Guadonna/VideoSynth/docs/r1/README.md

# VideoSynth R1 — схема, PCB и лаборатория эмуляции

23 октября 2026. Пользователь разрешил разработку схемы и PCB после исследовательской v0.5 и подтвердил готовый модуль ESP32-P4 и панель 42 HP. Старый запрет проектирования в документах v0.4/v0.5 относится к завершённому этапу. Разрешения на производство нет; заказы не создавались.

Созданы **две электрические схемы и две полностью соединённые четырёхслойные PCB KiCad 9**: основная плата и плата органов управления. В R1 используется Olimex ESP32-P4-DevKit Rev.D1. Это проверяемый инженерный прототип, ещё не выпуск для изготовления.

| Материал | Файл |
|---|---|
| Основная схема | [KiCad](../../hardware/kicad/core/videosynth_core.kicad_pro), [PDF](../../hardware/kicad/core/core-schematic.pdf) |
| Основная PCB 140×105 мм | [KiCad PCB](../../hardware/kicad/core/videosynth_core.kicad_pcb) |
| Панель управления 208,28×108 мм | [KiCad](../../hardware/kicad/panel/videosynth_panel.kicad_pro), [схема PDF](../../hardware/kicad/panel/panel-schematic.pdf), [PCB](../../hardware/kicad/panel/videosynth_panel.kicad_pcb) |
| Автономное приложение | [VideoSynth-R1.html](../../dist/VideoSynth-R1.html) — скачать и открыть в современном браузере |
| Пакет R1 с исходниками и PDF | [VideoSynth-R1-prototype.zip](../../dist/VideoSynth-R1-prototype.zip) |
| Электроника, питание и сборка | [hardware.md](hardware.md) |
| Правила синтеза и ограничения модели | [dsp.md](dsp.md) |
| Изменение AM и микса 0.6.2 | [modulation-fixes.md](modulation-fixes.md) |
| Проверки и доказательства | [validation.md](validation.md) |
| Порядок испытаний | [bringup.md](bringup.md) |
| Компоненты | [BOM](../../hardware/bom-r1.csv), [внешние узлы](../../hardware/external-assemblies.csv), [смета](../../hardware/cost-estimate-usd.csv) |
| Источники | [sources.md](sources.md) |

Краткий вывод: логика шести осцилляторов, экранной матрицы и одного микса реализована и проверяется в приложении. ERC, DRC и независимая сверка соединений проходят. Линейная модель входа CV проходит SPICE-проверку. **Работоспособность собранной электроники и 720×480/29,97 при 36 связях на ESP32-P4 пока не подтверждены.** В репозитории есть переносимое ядро C и браузерный стенд; драйверов платы и законченной ESP-IDF-прошивки ещё нет.

Перед изготовлением важнее всего проверить непрерывность PARLIO/DMA, максимальный DSP-сценарий, питание модуля без USB, номиналы и поведение CV при выключении. Также нужно утвердить точные модели ручек/дисплея и конструкцию крепления двух плат. Нулевой DRC этих вопросов не решает.
