Guadonna/VideoSynth/docs/summary-v0.5.md

# VideoSynth v0.5 — краткая выжимка

[Текущие требования](requirements/video_synth_TZ_v0.5.md) · [Исследование](feasibility-v0.5.md) · [PDF](feasibility-v0.5.pdf)

Согласовано: **один монохромный RCA, 720×480 / 480i / 29,97 кадра/с**, питание только Eurorack. Все шесть OSC могут одновременно входить в микс; кнопки переключают вкл/выкл. Выключенный из микса OSC продолжает работать в модуляционной матрице.

Матрица находится на экране: **8 источников × 18 назначений, до 36 включённых слотов**, каждый с фиксированной силой. Два энкодера выбирают строку/столбец; MODE переключает меню/preview; SLOT включает/выключает ячейку. Регулировка глубины и нажатия энкодеров не требуются. Два CV сохранены для **DC…100 Гц**. 24 потенциометра остаются.

Полностью исключены патч-гнёзда, сканер, защита 44 контактов, матричный микшер, слои A/B/C и два лишних видеоканала. У двух внешних CV и Eurorack-питания защита остаётся. Питание от USB удалено; сервисное USB-обновление из исходного ТЗ сохраняется при питании от стойки.

**Первый кандидат — один ESP32-P4NRW32X.** P4+RP2350A — резерв, если нужен отдельный генератор видеотайминга. Один RP2350 — дешёвый сравнительный стенд, без обещания максимальной производительности.

Прежние риски кабельных матриц исчезли, но максимальный DSP-режим ещё не доказан: 720×480@29,97 требует **10,358 млн точек/с**, до **62,146 млн вычислений OSC/с**. Фиксированная сила позволяет заменить многие умножения суммированием, однако 36 связей, cross-FM/PM и feedback всё равно требуют измерений. Второй MCU не ускоряет это ядро автоматически.

Предварительная стоимость: **65–150 USD электроника**, **85–210 USD с PCB и сборкой**, без панели/корпуса, доставки и налогов. База предполагает резистивный DAC, простую LED-индикацию и один MCP3204 для ручек/медленных CV. Это не котировка и не утверждённый производственный BOM. P4 нужной ревизии остаётся закупочным риском; новые ADC и RP2350A найдены в каталоге JLCPCB.

До схемы остаётся определить и проверить:

- Численные фиксированные силы FM/AM/PM, суммирование/ограничение и задержку в циклах. Отдельные экранные связи уже однозначны; проводной «семантики групп» больше нет.
- Закон итогового микса: для прототипа предложено равновесное среднее, при пустом выборе — чёрное изображение.
- Стабильность 480i под полной нагрузкой, реконструкционный фильтр, полезную видеополосу, setup и совместимость приёмников.
- Точность и защиту двух CV, потребление/нагрев, полный pin mux, конкретные органы управления и ширину HP.

Физические испытания не выполнялись. Исходный v0.4 сохранён как история; новая версия не является разрешением на схему, PCB или производство.
