Guadonna/VideoSynth/hardware/panel/opening-centres-provisional.csv

name | panel_x_mm | panel_y_mm | candidate_diameter_mm | note
H1 FREQ | 14.54 | 26.25 | 7.2 | pot candidate
H1 FINE | 14.54 | 46.25 | 7.2 | pot candidate
H1 PHASE | 14.54 | 66.25 | 7.2 | pot candidate
H1 MORPH | 14.54 | 86.25 | 7.2 | pot candidate
H2 FREQ | 36.54 | 26.25 | 7.2 | pot candidate
H2 FINE | 36.54 | 46.25 | 7.2 | pot candidate
H2 PHASE | 36.54 | 66.25 | 7.2 | pot candidate
H2 MORPH | 36.54 | 86.25 | 7.2 | pot candidate
H3 FREQ | 58.54 | 26.25 | 7.2 | pot candidate
H3 FINE | 58.54 | 46.25 | 7.2 | pot candidate
H3 PHASE | 58.54 | 66.25 | 7.2 | pot candidate
H3 MORPH | 58.54 | 86.25 | 7.2 | pot candidate
V1 FREQ | 80.53999999999999 | 26.25 | 7.2 | pot candidate
V1 FINE | 80.53999999999999 | 46.25 | 7.2 | pot candidate
V1 PHASE | 80.53999999999999 | 66.25 | 7.2 | pot candidate
V1 MORPH | 80.53999999999999 | 86.25 | 7.2 | pot candidate
V2 FREQ | 102.53999999999999 | 26.25 | 7.2 | pot candidate
V2 FINE | 102.53999999999999 | 46.25 | 7.2 | pot candidate
V2 PHASE | 102.53999999999999 | 66.25 | 7.2 | pot candidate
V2 MORPH | 102.53999999999999 | 86.25 | 7.2 | pot candidate
V3 FREQ | 124.53999999999999 | 26.25 | 7.2 | pot candidate
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
