Guadonna/VideoSynth/docs/r1/hardware.md

# Аппаратная архитектура R1

## Что разработано

Основная плата 140×105 мм и плата панели 208,28×108 мм имеют по четыре слоя: **F.Cu — сигналы/компоненты, In1.Cu — земля, In2.Cu — сигналы, B.Cu — сигналы/компоненты**. Минимальные дорожка/зазор 0,20/0,20 мм; переходные отверстия 0,60/0,30 мм; основные цепи +12 В и 5 В разведены шириной 0,70 мм. Ветви питания маломощных ИС — 0,20 мм. Толщина 1,6 мм и медь 35 мкм — предварительные параметры заказа, а не согласованный заводом stackup.

184 электрических компонента: 100 на core, 84 на panel; крепёжные отверстия отдельно. На панели SMD в основном снизу, шесть индикаторов сверху. Это **двусторонний SMD-монтаж панели**. Потенциометры, энкодеры, кнопки, CV-разъёмы, штыревые соединители и сам модуль требуют отдельной THT/ручной сборки.

Схемы содержат все используемые физические выводы; соединения между листами обозначены глобальными метками. Пользовательская библиотека символов поставляется в каждом KiCad-проекте. Геометрия корпусов взята из библиотек KiCad. PCB полностью разведены и проверены, но аналоговая компоновка и силовой контур ещё требуют инженерной проверки на физическом образце. Длинные ответвления питания и расположение развязки AD9708 не следует считать квалифицированными только на основании DRC.

## Вычислительный модуль и интерфейсы

Выбран **Olimex ESP32-P4-DevKit Rev.D1**, плата 72×30 мм, два разъёма 1×20 с шагом 2,54 мм и расстоянием между рядами 25,4 мм. Память по документации модуля: 32 МБ PSRAM, 16 МБ Flash. Частота и ограничения silicon revision должны проверяться на полученном экземпляре; старое исследование с конкретным ограничением частоты нельзя автоматически заменить рекламным значением 400 МГц.

| Функция | GPIO ESP32-P4 | Вывод модуля |
|---|---|---|
| SPI SCK / ADC CS / TFT CS | 4 / 5 / 6 | EXT1 5 / 6 / 7 |
| I²C SDA / SCL | 7 / 8 | EXT1 8 / 9 |
| Видео D0…D7 | 9…16 | EXT1 10…17 |
| Внешний clock 27 МГц | 17 | EXT1 18 |
| TFT DC / RESET | 18 / 19 | EXT1 19 / 20 |
| SPI MISO / MOSI | 54 / 53 | EXT2 3 / 4 |
| DAC SLEEP | 22 | EXT2 11 |
| UI IRQ2 / IRQ1 | 21 / 20 | EXT2 12 / 13 |
| 3,3 В для carrier/panel | выход модуля | EXT1 1 |

EXT2 pin 1 (+5 В) на carrier не подключён. Питание вводится через отдельный J2 и разъём **POE_PWR1 модуля: core J2.1 → POE_PWR1.4 (+5VP), core J2.2 → POE_PWR1.3 (GND)**. Контакты PoE PW+/PW− не используются.

**Обязательная модификация модуля: удалить FET2, разрывающий путь USB VBUS к питанию.** Без этого R1 не выполняет отказ от USB-питания. Штатный D1 в цепи +5VP сохраняется. Это операция сборки на готовом модуле, не операция JLCPCB на carrier. Сверить обозначение FET2 с фактической Rev.D1 до удаления; для другой ревизии нельзя переносить инструкцию вслепую. Сервисный USB должен работать для данных только при питании от стойки. Обратное питание и загрузку без VBUS необходимо проверить физически.

## Видеовыход

ASE-27.000MHZ-LC-T тактирует P4; SN74LVC1G04 формирует противоположный фронт для AD9708. На clock и восьми data установлены последовательные 33 Ом. Требуемое поведение: P4 меняет данные на одном фронте, ЦАП принимает их на другом. Номинальная половина периода — 18,52 нс. Полезный запас меньше: нужно вычесть GPIO delay, задержку инвертора, skew трасс и setup/hold ЦАП. Эмулятор этого не доказывает.

AD9708ARUZ работает с DVDD=3,3 В и AVDD≈5 В. `I_FS = 32 × 1,2 В / 1,91 кОм ≈ 20,105 мА`. Нагрузки IOUTA/IOUTB — 49,9 Ом. IOUTA поступает на THS7314 с усилением ×2 и встроенным ФНЧ 8,5 МГц, затем через последовательные 75 Ом и короткий 75-омный коаксиал — на панельный RCA. Дополнительной параллельной нагрузки 75 Ом на плате нет: оконечная нагрузка находится в приёмнике.

При кодах sync=0, black=73, white=255 расчётный нагруженный размах sync→white **0,9993 В**, sync→black **0,2861 В**, black→white **0,7132 В**. THS7314 добавляет смещение ≈285 мВ на выходе; после делителя 75/75 абсолютная синхровершина ≈142,5 мВ. Это не ошибка расчёта размаха, но совместимость DC-смещения/восстановления уровня с конкретным захватом необходимо измерить.

ЦАП получает 27 MSPS: строка 1716 отсчётов, активная часть 1440 отсчётов из 720 вычисленных пикселей с линейной интерполяцией ×2. В кадре 900900 байт, в двух буферах 1801800 байт. Два буфера яркости 720×480 занимают ещё 691200 байт. Памяти модуля достаточно по объёму; непрерывность DMA и реальная пропускная способность PSRAM не доказаны объёмом памяти. Физическая полоса композитного видео не гарантирует различимость всех 720 цифровых столбцов.

Возможность непрерывной выдачи через PARLIO с внешним clock, без зазоров между DMA-дескрипторами, — главный аппаратно-программный риск. В R1 нет дополнительного RP2350/FPGA, который мог бы автоматически принять эту функцию.

## CV и потенциометры

CV рассчитан для ±10 В, DC…100 Гц; ±15 В — испытательная перегрузка, **не подтверждённая характеристика**. Исчезновение физической матрицы устраняет её контакты, но не защиту двух внешних CV.

Каждый канал: 100 кОм → OPA2197 (питание 5 В), обратная связь 12 кОм || 47 нФ; смещение от делителя 12,4/10 кОм на 3,3 В; далее 4,7 кОм, 100 нФ, BAT54S к шинам, TMUX1511 с powered-off isolation и 100 кОм на землю у АЦП. Идеальная передаточная функция до последнего RC: `V = 1,65 − 0,12 × CV`. С нагрузкой 100 кОм: `V_ADC = (1,65 − 0,12 × CV) × 100/104,7`.

При −10/0/+10 В получаются приблизительно 2,7221/1,5759/0,4298 В. Код АЦП при нуле не равен середине шкалы; прошивка должна учитывать нагрузку и двухточечную калибровку. SPICE с идеальным ОУ даёт ослабление 0,846 дБ на 100 Гц относительно DC. Два полюса около 282 и 355 Гц дают лишь умеренное подавление за полосой; сильные аудио/CV вне 100 Гц не являются заявленным рабочим режимом.

TMUX1511 не разрешает произвольные ±15 В на своих выводах: его допустимый диапазон при отключённом питании ограничен документацией. Отрицательный выброс, ток в BAT54S/OPA2197, обратное питание 3,3 В, порядок включения и ESD требуют измерений. Bleeder 1 кОм — вспомогательный потребитель, а не доказательство защиты.

Два CD74HC4067 опрашивают 24 потенциометра; два оставшихся канала OPA2197 буферизуют их выходы. MCP3204 получает два mux-канала и два CV. Предложенный график: CV по 4 kSPS, каждая ручка 100 Гц с первым отбрасываемым отсчётом после переключения. Итого 12800 преобразований/с; при 24 SPI-тактах и 1 МГц занято 30,72% времени шины. Фактическое установление mux/буфера и расписание дисплея нужно проверить.

## Управление и дисплей

MCP23017 по адресам 0x20/0x21 обслуживают кнопки, LED, энкодеры и адрес mux. I²C pull-up 2,2 кОм, IRQ к P4, аппаратный RC reset. Кнопки требуют программного подавления дребезга; энкодеры — корректного квадратурного декодирования, несмотря на RC-фильтр.

TFT подключается восьмипроводным жгутом VCC/GND/DIN/CLK/CS/DC/RST/BL. Кандидат — Waveshare 2.4inch LCD Module, рабочая ориентация 320×240. Точная версия контроллера, размеры платы, ток подсветки и логический вход BL должны быть сверены с приобретённой модификацией. SN74LVC1G125 управляет **логическим BL**, а не током голого светодиода. Нельзя заменить модуль «голой» матрицей с тем же названием.

Core J5 и panel J1 соединяются 20-жильным кабелем pin-to-pin. Видеосигнал идёт отдельным коаксиалом. Предварительно целиться в длину UI-шлейфа ≤50 мм и подтвердить целостность SPI на выбранной скорости. Конструкция расстояния между платами и кронштейна ещё не утверждена.

## Питание и смета

Eurorack: pins 9/10 +12 В, 3…8 земля, 1/2 −12 В **не используются**. F1 750 мА hold, последовательный SS34, TVS SMBJ15A, TPS54302 на 5 В. Обратная связь 100 кОм/13,3 кОм, дроссель 6,8 мкГн, вход 22 мкФ/35 В и два выхода 22 мкФ/10 В. Необходимо проверить DC-bias керамики, Isat выбранного дросселя, устойчивость преобразователя и выбросы: номиналы ещё не являются испытанным импульсным источником.

Предварительный бюджет 0,4…0,9 А от 5 В при КПД 85% даёт **0,20…0,45 А от +12 В**; −12 В не потребляется. Это диапазон планирования, не измерение. Дерейтинг предохранителя и пусковой ток должны проверяться при рабочей температуре. Нужен контроль падения на штатном диоде модуля и доступного тока его 3,3 В для TFT/панели.

[Смета](../../hardware/cost-estimate-usd.csv): **$175…386 за электронику одного прототипа с двумя PCB и долей SMD-сборки**. Не включены доставка/налоги, металлическая панель, 24 колпачка ручек, ручной THT-монтаж и отладка. Это расчёт из явно заданных бюджетных допущений, не цена JLCPCB.

Сборка SMD на JLCPCB технологически правдоподобна: доступны обычные 0805, SOIC, TSSOP, SOT-23 и четырёхслойные платы. Но **все конкретные позиции не подтверждены как комплект для заказа**. Для AD9708ARUZ, OPA2197, TMUX1511, дросселя и точных номиналов нужна актуальная проверка каталога/закупки, ориентации и замены. Исторический снимок v0.5 нельзя считать подтверждением изменённого BOM R1. Готовый модуль, TFT и THT органы управления не входят автоматически в услугу SMD-монтажа.
