Guadonna/VideoSynth/docs/requirements/video_synth_TZ_v0.5.md

# Техническое задание v0.5 — один видеовыход и экранная матрица

Дата: 23.10.2026. Это консолидация изменений и ответов заказчика после исследования v0.4. Исходный файл [v0.4](video_synth_TZ_v0.4.md) сохранён как история. При противоречии применяются подтверждённые требования v0.5 ниже. Текущий этап — исследование и проверка реализуемости; схема, PCB и производство не разрешены.

## 1. Подтверждённая функциональность

- Ровно 6 цифровых пространственных осцилляторов: H1–H3 и V1–V3. Сохраняются 24 потенциометра: frequency, fine frequency, phase offset, waveform morph для каждого OSC.
- **Один** монохромный композитный видеовыход RCA, согласованный с 75-омной нагрузкой.
- Максимальная растровая сетка **720×480**, стандартный режим **480i / 30000÷1001 ≈29,97 полного кадра/с / 60000÷1001 ≈59,94 поля/с**, 525 строк всего. Это замена прежнего PAL 625/50. Цветовое кодирование не требуется.
- Шесть кнопок OSC работают как переключатели: короткое нажатие добавляет осциллятор в итоговый микс, следующее исключает его. Одновременно в изображении могут участвовать все шесть.
- Выключение OSC из микса **не выключает его как источник/приёмник модуляции**. Невидимые осцилляторы могут менять изображение через другие OSC.
- Матричного микшера 3×3, слоёв A/B/C, FIFO-назначения и трёх выходов больше нет.
- Физические патч-разъёмы и обе проводные матрицы полностью исключены. Сканирование кабелей и защита этих отсутствующих контактов больше не требуются.

## 2. Экранная матрица и органы управления

- Матрица модуляции — отдельное меню встроенного дисплея, а не физическая коммутация.
- 8 источников: H1–H3, V1–V3, CV1, CV2. 18 назначений: FM, AM, PM каждого из шести OSC. Всего 144 адресуемых слота.
- Одновременно включено **не более 36 слотов во всей матрице**, включая связи от CV. Это не 36 связей на осциллятор.
- Слот имеет только состояния **вкл/выкл с фиксированной силой**. Пользовательская регулировка глубины и жесты её редактирования на этом этапе не нужны.
- Два физических энкодера: один перемещает курсор по горизонтали, второй по вертикали.
- Рядом две отдельные кнопки: **MODE** переключает меню матрицы/предпросмотр; **SLOT** включает или выключает выбранный слот.
- Общий обязательный набор: 24 потенциометра, 2 энкодера, 8 кнопок (6 OSC + MODE + SLOT), дисплей, 2 CV TS и 1 RCA. Нажатия самих энкодеров не требуются.
- Переключение режима экрана не останавливает синтез, не меняет матрицу и не сбрасывает активные OSC.

## 3. CV и питание

- Сохраняются два внешних CV-входа для огибающих и LFO, полезная полоса **DC…100 Гц**.
- Прежний предварительный рабочий диапазон ±10 В сохранён для расчётов; диапазон, точность, перегрузка и испытательные условия входов ещё нужно зафиксировать до схемы.
- Удаление патч-матриц не отменяет входной тракт и защиту двух оставшихся CV-разъёмов от отрицательных/избыточных напряжений, ESD и обратного питания при выключении.
- Только **Eurorack**, питание от стандартной шины ±12 В/GND. Standalone и питание устройства от USB исключены.
- Защита от перевёрнутого кабеля Eurorack, ограничение аварийного тока и фильтрация питания сохраняются.
- Требование v0.4 об обновлении прошивки через USB не отменено запросом об отказе от USB-питания. Поэтому сохраняется **сервисный USB для данных при питании модуля от стойки**; USB VBUS не питает рабочие шины. Система выбора USB/Eurorack и USB current-advertisement controller не нужны.

## 4. Предложения реализации, ещё не отдельные согласованные требования

- Строки меню = 8 источников; столбцы = 18 назначений, сгруппированных по OSC. Это естественное отображение двух энкодеров.
- Включение 37-го слота отклоняется с сообщением «Лимит 36»; ранее включённые связи не меняются. Все 144 позиции остаются доступными для выбора.
- В preview кнопка SLOT ничего не меняет, чтобы не переключать невидимый слот. OSC-кнопки работают в обоих режимах.
- Для первого прототипа итоговый микс — равновесное среднее включённых OSC, затем ограничение яркости. При отсутствии выбранных OSC выводится чёрное изображение с непрерывной синхронизацией. Другой закон микса можно оценить на визуальном прототипе.
- Несколько связей на одно назначение суммируются с явно заданным ограничением. Один и тот же фиксированный коэффициент внутри данного назначения позволяет сначала суммировать источники и потом масштабировать результат.
- Конкретные фиксированные силы FM/AM/PM, единицы их измерения, saturation, диапазоны частот, morph/anti-alias и задержка циклической обратной связи требуют определения в DSP-прототипе. Фиксированная сила не означает автоматически коэффициент «1» для всех трёх разных типов модуляции.
- 720×480 рассматривается как целевая **вычисляемая** сетка максимального режима. Апскейл более низкого внутреннего разрешения не объявляется её подтверждением. Поддержка 36 связей при максимальном режиме должна быть проверена до выбора MCU.

## 5. Следующие контрольные точки

1. Проверить непрерывный 525/59,94 raster и одну нагруженную видеолинию.
2. Сравнить DSP на ESP32-P4 и RP2350: все шесть OSC, до 36 связей, включая межосевые и согласованные циклические сценарии, UI и CV одновременно.
3. Проверить CV DC…100 Гц, питание, нагрев и обновление прошивки от сервисного USB при питании Eurorack.
4. Выбрать архитектуру и полный BOM на основании результатов; затем отдельно согласовать переход к электрической схеме/PCB.
