Guadonna/VideoSynth/docs/r1/dsp.md

# DSP, матрица и эмулятор

## Подтверждённое поведение

Шесть пространственных OSC: H1–H3 зависят от X, V1–V3 — от Y. У каждого frequency/fine/phase/morph; кнопка переключает участие в итоговом изображении и **не выключает модуляцию**. Все шесть продолжают вычисляться. Матрица 8×18: шесть OSC и два CV → FM/AM/PM каждого OSC. До 36 связей суммарно, включая CV. 37-я связь отклоняется атомарно. Два энкодера перемещают курсор, MODE переключает экран, SLOT переключает выбранную связь. В режиме preview SLOT ничего не меняет.

Пользователь дополнительно выбрал **перемножение сигналов в миксе** и **AM со сменой полярности**. С версии эмулятора 0.6.2 оба действия работают с биполярными значениями −1…+1. Эти правила реализованы в интерфейсе и переносимом [ядре C](../../firmware/dsp/engine.c). Из него собирается WebAssembly для браузера; нативный C-тест использует тот же исходник. Интерфейс выполняет ровно 720×480, а не скрытый рендер низкого разрешения.

## Инженерные допущения R1

Пользователь подтвердил фиксированную силу и характер AM/микса. Числа FM/PM, объединение нескольких управляющих AM-сигналов и семантика циклов остаются **инженерными допущениями R1**:

- Frequency 0,25…64 пространственных периода на ширину/высоту; fine ±1 период; итоговая частота ограничена 0,01…64.
- Phase 0…1 оборот. Morph непрерывно проходит sine → triangle → saw → square.
- Источники OSC в матрице читаются из **предыдущего активного пикселя**. Все шесть новых значений вычисляются одновременно из старых. Самомодуляция и циклы допустимы; порядок обхода OSC не меняет причинность.
- В начале каждого поля история источников сбрасывается в ноль. H-фаза начинается заново на каждой строке. Для V хранится отдельная фаза на каждый столбец; поле шагает по чётным или нечётным строкам, поэтому V-инкремент равен двум строкам.
- FM: множитель частоты `clip(1 + 0,25×sum, 0, 2)`, сумма источников ограничена ±4. PM: `0,125×sum` оборота, сумма также ограничена ±4.
- AM: при наличии хотя бы одной связи множитель `clip(sum, −1, +1)` **без постоянного смещения**. Несколько входящих AM-источников складываются на одной управляющей шине и затем ограничиваются; они не образуют цепочку отдельных умножителей. Без AM-связей множитель равен +1. Результат OSC после AM ограничен ±1 и используется как источник матрицы на следующем активном пикселе.
- Микс — **произведение** включённых OSC после AM, пока сигналы ещё биполярны. Преобразование в яркость выполняется один раз, после перемножения. Нет включённых OSC → чёрные активные пиксели; синхронизация сохраняется.
- CV проходит номинальную модель входа, квантование 12 бит и sample-and-hold 4 kSPS с временной шкалой двух полей. Нормированный рабочий CV ±1 соответствует ±10 В. Для синусоидального LFO приближённо учтены два полюса фильтра; это не transient-SPICE защиты.

### Формулы AM и микса 0.6.2

Для формы `wᵢ ∈ [−1,+1]` после FM/PM и предыдущих выходов источников `sⱼ`:

```text
aᵢ = 1                         при отсутствии AM-связей
aᵢ = clip(Σ sⱼ, −1, +1)        при наличии AM-связей
xᵢ = clip(wᵢ × aᵢ, −1, +1)
p  = Π xᵢ                     только выбранные кнопками OSC
Y  = round(255 × (p + 1) / 2)  если выбран хотя бы один OSC
Y  = 0                        если ни один OSC не выбран
```

| Множитель AM / фактор микса | Результат |
|---|---|
| +1 | Сигнал сохраняется |
| −1 | Полярность меняется: светлое и тёмное меняются местами |
| 0 | Переменная составляющая исчезает; на экране средний серый |
| Два одинаковых сигнала `x` в миксе | `x²`; отрицательные участки становятся положительными |
| Два противоположных сигнала `x`, `−x` | `−x²` |

Это модель четырёхквадрантного умножителя. Перемножение яркостей 0…1 дало бы другой эффект без смены полярности. При умножении многих синусоид произведение часто близко к нулю, поэтому контраст может уменьшаться. Автоматического усиления, усреднения и добавления исходной несущей нет.

Сцена «AM · инверсия»: в миксе только H1; V1 модулирует его AM, оставаясь невидимым. SLOT выключает/включает связь для сравнения. Сцена «Перемножение»: H1 × V1 без связей матрицы. В «Переплетении» AM приходит от независимых H2/V2. В «36 связях» V3 подаётся на AM остальных OSC, а собственный AM у V3 отключён; все шесть прямоугольных OSC участвуют в миксе.

Циклическая модуляция может давать выраженные текстуры, зависимость от порядка строк и переход на границе поля. **Замкнутая группа только из AM, включая self-AM, при нулевой начальной истории может навсегда остаться на нуле**, то есть дать серое изображение. Это следует из `w × 0 = 0`. Независимый источник на AM-шине или отключение одной связи может разорвать такое состояние; случайный шум и скрытое смещение не добавляются. Другие начальные условия и задержки обратной связи требуют отдельного решения. Аналоговый шум и смещения реальных умножителей здесь не моделируются.

PolyBLEP уменьшает aliasing saw/square от основной частоты. Он **не обеспечивает** полную полосу при сильной PM/FM, кольцевой AM, перемножении OSC и пространственной обратной связи. Произведение создаёт суммарные/разностные частоты; для нескольких высокочастотных сигналов возможен выход за Найквист. Обработка предельных режимов — предмет следующих DSP-испытаний; размытие внешним видеотрактом не равно корректному цифровому anti-alias.

## Видеовременная шкала

[video.js](../../app/video.js) строит полный монохромный растр: 27 МГц; 1716 отсчётов/строку; 525 строк; 900900 отсчётов/кадр; два поля по 450450 отсчётов, то есть 262,5 строки. Частоты 30000/1001 и 60000/1001 Гц. На каждом поле предусмотрены 6 предуравнивающих, 6 широких синхроимпульсов и 6 постуравнивающих полупериодов. Номиналы округлены до целых отсчётов: HSync 127, equalizing 62, broad-sync 731.

Активная область поля начинается с глобальных полустрок 44 и 570, 240 строк на поле, горизонтальное смещение 244 отсчёта. Это выбранное окно 480 строк внутри 525-line timing. Цветового burst и chroma нет; режим установки чёрного — 0 IRE, без 7,5 IRE setup. Требуется проверить захват и centering на реальном приёмнике.

Кнопка экспорта во вкладке «Проверки» сохраняет ровно 900900 байт, uint8, полный кадр с синхроимпульсами. Это тестовые данные ЦАП, не видеоконтейнер и не готовый DMA-драйвер.

Превью на мониторе приложения показывает вычисленную яркость. Оно не моделирует полностью THS7314, коаксиал, телевизионный clamp, расфокусировку и деинтерлейс захвата. Режимы «Поле 1/2» позволяют увидеть чересстрочное разложение.

## Производительность и границы переносимости

При 720×480×29,97 нужно обработать **10,358 млн активных пикселей/с**, вычислить **62,146 млн OSC/с** и до **372,875 млн накоплений связей/с**. На одном ядре 400 МГц это всего **38,62 такта на весь активный пиксель**; даже два ядра без потерь дали бы 77,24. Реально часть бюджета забирают формирование растра, DMA, синхронизация, CV и UI. Для меньшей допустимой частоты запас ещё ниже.

Текущее C-ядро — скалярная эталонная модель на float с RGBA-выводом для браузера. **Оно не считается готовой производительной реализацией для P4.** 36 связей общего вида требуют профилирования, плотных структур маршрутов, SIMD/fixed-point или другого ускорения. Параллелить соседние пиксели произвольно нельзя из-за принятой обратной связи. Независимые поля можно рассмотреть отдельно, но нужно проверить работу с живым CV и задержку отображения.

[Измерение нативного ядра на хосте](../../hardware/verification/host-dsp-benchmark.json) показывает только производительность данного компьютера; его нельзя переносить на ESP32-P4. В интерфейсе отображаются фактические миллисекунды/кадр и fps браузера. При медленном компьютере приложение замедляет модельное время и сохраняет размер кадра; это не доказательство real-time.

Программно получены: управление, формирование изображения, обработка матрицы, модель CV и генерация последовательности отсчётов видео. **Ещё не реализованы:** ESP-IDF boot/application, PARLIO+GDMA, управление буферами PSRAM/cache, MCP3204/MCP23017/TFT-драйверы, аппаратный debounce, калибровка, watchdog и USB update на реальной плате. Следующий этап начинается с измерительного firmware-spike, а не с объявления платы работоспособной.

Если P4 не проходит максимальный режим, нельзя молча уменьшить разрешение или число связей. Следует пересмотреть архитектуру: отдельный видеогенератор снимает риск тайминга, но сам по себе не ускоряет DSP; для полного DSP могут потребоваться FPGA/более мощный вычислительный узел либо отдельно согласованное изменение семантики.

## Управление приложением

Ручки: вертикальное перетаскивание, колесо мыши, клавиатура после фокуса. Кнопки 1…6 — OSC, M — MODE, стрелки — курсор, пробел — SLOT. Энкодеры можно вращать колесом или кнопками +/−. Пресеты сохраняются в JSON; некорректный файл отклоняется без частичной замены состояния. Формат JSON версии 1 совместим, но старые настройки отображаются по новому закону AM/микса, поэтому изображение изменится; старый замкнутый AM-патч может стать серым. Есть экспорт PNG, пауза, генераторы внешнего CV и встроенные проверки.

Автономный HTML не обращается к CDN, серверу или облачным API. PDF-ссылки в нём ведут на GitHub; для чтения схем без сети нужно скачать пакет с PDF. На этом облачном хосте навигация Chromium по `file://` запрещена администратором, поэтому автономность проверена загрузкой HTML по HTTP с блокировкой всех последующих сетевых запросов: **0 внешних запросов**. Это ограничение тестовой среды, а не удалённая зависимость приложения.
