Guadonna/VideoSynth/docs/requirements/video_synth_TZ_v0.4.md

# Техническое задание v0.4 — цифровой видеосинтезатор с аппаратным патчингом

**Статус:** концепция и требования для предварительного анализа (НЕ утверждённый проект платы).  
**Цель:** самостоятельный цифровой видеосинтезатор, который также может монтироваться в Eurorack, с минимальной ручной сборкой.  
**Исполнитель проектирования:** Codex с KiCad и SDK выбранного микроконтроллера.  
**Производство:** PCBA с заводским монтажом всех SMD и по возможности THT; ручная пайка допускается для крупных потенциометров, джеков, RCA и разъёмов.

## 1. Режимы использования и питание

1. Standalone: питание от USB-C 5 В, без обязательного подключения к Eurorack.
2. Eurorack: питание от стандартной шины Eurorack (предварительно 10-pin ±12 В/GND; совместимость с 16-pin системами через кабель). Плата должна корректно преобразовывать напряжение в необходимое для цифровой и аналоговой частей.
3. Обязательная защита от переполюсовки и ошибок питания; безопасное переключение/объединение источников USB и Eurorack без обратной подачи питания в компьютер или шину Eurorack. Прямое соединение источников запрещено.
4. Электропотребление и нагрев — оценить до проектирования; проверить применимость типовых источников USB и возможностей питания Eurorack.
5. Механика: совместимость с Eurorack 3U по высоте, посадочным отверстиям и шагу ширины HP. Конкретная ширина — только после расчёта компоновки всех 24 ручек, 6 кнопок выбора осцилляторов и не менее 44 патч-контактов при рекомендованной реализации матрицы микширования из девяти изолированных пар (ещё больше при необходимости дополнительных точек патчинга), дисплея и разъёмов; удобство использования важнее компактности.

## 2. Процессор и ПО

1. Только программно-цифровая генерация паттернов. Основной вычислитель — микроконтроллер семейства ESP32 либо Raspberry Pi RP (например, ESP32-P4, ESP32-S3 или RP2350), окончательный выбор **только после сравнительного теста**.
2. Допускаются специализированные вспомогательные микросхемы (АЦП, мультиплексоры, видеокодеры/ЦАП, буферы, конвертеры питания), но не отдельный аналоговый осцилляторный тракт.
3. До PCB обязательно сделать доказательство реализуемости: оценить CPU, RAM, DMA, пропускную способность внешней памяти, нагрузку интерфейса и способ выдачи ТРЁХ независимых композитных потоков одновременно.
4. Прошивка должна быть обновляема через USB без внешнего программатора; предусмотреть загрузочный и диагностический режимы.
5. Инструменты: Git, KiCad, CI, unit tests алгоритмов, моделирование видеорендера на ПК.

## 3. Осцилляторы

**Утверждено заказчиком:** **ровно 6** цифровых осцилляторов: **3 горизонтальных (H1, H2, H3) и 3 вертикальных (V1, V2, V3)**. Исходное «4 H + 4 V» было опечаткой.

- Всего 6 пространственных осцилляторов с фиксированным разделением: H1–H3 формируют горизонтальные паттерны, V1–V3 — вертикальные. Каждый осциллятор может модулировать любой другой, включая осцилляторы другой ориентации.
- Для каждого: 4 физических потенциометра (всего 24): frequency, fine frequency, phase offset, waveform morph.
- Набор форм волн и правила плавного морфинга — спроектировать и согласовать. Предварительные варианты: sine, triangle, saw, square; нужны бесшовный морфинг и предсказуемый диапазон частот.
- Определить поведение осцилляторов по пикселю/строке/кадру, диапазоны частот и способы антиалиасинга; проверить корректность фазового накопителя на переходах строк и кадров.
- Каждый осциллятор может быть источником модуляции для других осцилляторов.

## 4. Матрица модуляции — физический одноконтактный патчинг

Источники: OSC1–OSC6, CV1, CV2 (итого 8).  
Назначения: индивидуальные входы FM, AM, PM на каждом из 6 осцилляторов (6 × 3 = 18).

- Минимум **26 фронтальных патч-контактов** (8 исходных + 18 целевых), если каждому источнику/назначению соответствует один контакт.
- Патч-кабели одно-контактные, в эстетике AE Modular. Все сигналы внутри устройства имеют общую опорную землю; патч-шина не должна без защиты соединяться с внешними CV-системами.
- Предпочтительный принцип: кабели только передают информацию о соединениях; DSP выполняет математическую модуляцию внутри микроконтроллера. Это не требует передачи полночастотного аналогового видео по патч-кабелям. Схему определения подключений необходимо разработать, проверить электрическую безопасность и документировать.
- Предположительно требуются одно-ко-многим и много-к-одному соединения. Для этого предусмотреть физические дублирующиеся гнёзда, стекуемые/разветвительные патч-кабели либо отдельные MULT-поля: **одинарное одноконтактное гнездо без разветвителя не позволяет вставить два обычных кабеля**. Требуется решить: допустимо ли несколько источников на одном входе, как задавать глубину модуляции и как обрабатывать самопатчинг/циклическую обратную связь.
- **Способ обнаружения кабелей:** контроллер периодически активирует ровно один защищённый контакт сканирующей сети, остальные переводит в высокоимпедансное состояние и измеряет связанные контакты. Могут применяться I/O-экспандеры/мультиплексоры, ограничительные резисторы, ESD-защита, программная антидребезговая обработка. Все кабели должны быть только однопроводными сигнальными связями **внутри устройства**; отрицательное/высокое внешнее Eurorack-CV через патч-сеть недопустимо.
- **Ограничение топологии:** сканер определяет электрически объединённые группы контактов, но **не способен в общем случае различить, какая именно пара кабелей образовала соединение в сети из трёх и более точек**. Например, A→OUT1, A→OUT2 и B→OUT1 могут электрически объединить A, B, OUT1, OUT2, отчего появляется ложный маршрут B→OUT2. Для полной 3×3 матрицы применить индивидуально сканируемые, электрически изолированные патч-пары. Правила маршрутизации для объединённых групп нужно задать до разработки прошивки.
- Недопустимо электрически соединять активные GPIO-выходы друг с другом без токоограничения/защиты. Датчик патчинга должен выдерживать произвольные соединения доступных фронтальных контактов.
- **Согласованная цель по ошибочному патчингу:** выдерживать случайное длительное попадание напряжения от −15 до +15 В на любой пользовательский цифровой патч-контакт, включая выключенное питание, без повреждения устройства и без опасных токов в подключённое внешнее оборудование. Это инженерное требование, а не подтверждённая характеристика: нужны расчёты максимальных токов, ESD/перенапряжения, защита от обратного питания, тестовый план и верификация прототипа. Допустимые комбинации ошибок и сценарии соединения нескольких контактов документировать.

## 5. Два CV-входа Eurorack

- 2 × 3.5 мм моно TS входа CV1/CV2.
- Доступность обоих CV как источников внутренней матрицы модуляции.
- Защита АЦП/входов микроконтроллера от отрицательных и положительных внешних напряжений, ошибок коммутации и ESD; предварительно ориентироваться на рабочий диапазон -10…+10 В, подтвердить до схемы.
- Диапазон частот полезного CV-сигнала и частота опроса АЦП — отдельная инженерная спецификация; недопустимо молча считать быстрые CV аудиочастотными без проверки.
- Настройка функциональности и масштабирования CV через интерфейс прибора — деталь реализации для согласования.

## 6. Матрица микширования 3 × 3

- 3 входные шины/слоя A, B, C → 3 выходных канала OUT1, OUT2, OUT3.
- 9 потенциальных маршрутов, включаемых физическим патчингом одноконтактными кабелями. Логическая матрица имеет девять независимых состояний маршрута (A/B/C → OUT1/OUT2/OUT3). Минимально 3 исходных + 3 приёмных контакта (6 точек) поддерживают **простые** соединения. Для одновременного патчинга нескольких источников к одному OUT и одного источника к нескольким OUT требуются дублирующиеся контакты, MULT-разветвители или специальные кабели. **Рекомендуемый вариант, позволяющий однозначно обнаружить все девять маршрутов**: девять электрически независимых пар контактов (18 физических контактов, один короткий кабель на каждую ячейку 3×3). Альтернатива — 9 контактов источников (по 3 на источник) и 9 контактов назначений (по 3 на OUT), причём все повторяющиеся точки должны быть *электрически изолированы для сканера*, но сопоставлены с общим логическим источником/назначением в прошивке. Запрещается жёстко соединять одноимённые контакты, если это делает независимые патчи неразличимыми. Компоновку согласовать до PCB.
### 6.1. Назначение осцилляторов на входы A/B/C — утверждено

- **Шесть отдельных фронтальных кнопок OSC1…OSC6**, по одной на каждый из 6 генераторов, выбирают источник для трёх входных цифровых шин **A, B, C**. **Никакой дополнительной кабельной коммутации OSC → A/B/C не требуется**: это только программное назначение.
- Один вход A/B/C в каждый момент содержит **не более одного** назначенного осциллятора. По умолчанию один и тот же осциллятор не должен занимать сразу два входа; кнопка уже назначенного осциллятора не меняет маршрутизацию (без повторного переназначения).
- При нажатии кнопки не назначенного осциллятора контроллер:
  1. Если есть свободные входы, занимает **первый свободный в порядке A → B → C**.
  2. Если A/B/C уже заняты, заменяет источник во входе, где находится **самое раннее из трёх текущих назначений** (FIFO по времени назначения). Новый источник становится самым новым назначением, а остальные остаются на своих входах.
- Проверочный пример: `OSC1 → A`, затем `OSC2 → B`, затем `OSC3 → C`; нажатие `OSC4` приводит к `A=OSC4, B=OSC2, C=OSC3`; следующее нажатие `OSC5` приводит к `A=OSC4, B=OSC5, C=OSC3`; затем `OSC6` → `A=OSC4, B=OSC5, C=OSC6`.
- **Предлагаемое для проверки поведение при повторном нажатии уже назначенного OSC:** никаких изменений (в том числе FIFO-порядка). Для освобождения слота предусмотреть **удержание** его кнопки (например, 1 с): вход становится пустым. Это правило является UX-предложением, подлежит согласованию; не путать его с уже утверждённым FIFO-алгоритмом.
- Обеспечить **понятную индикацию** на панели: желательно RGB-индикатор возле каждой кнопки (A/B/C — три различимые цвета, не назначен — не горит); также можно показывать текстовые назначения `A:OSC4 / B:OSC2 / C:OSC3` на дисплее. Конкретные цветовые обозначения/электронику выбрать на стадии компоновки. Индикация должна корректно обновляться при вытеснении осциллятора.
- Назначение источника A/B/C **не изменяет кабельные маршруты матрицы 3×3**: каждая активная ячейка A/B/C → OUT1/2/3 продолжает работать, только содержимое соответствующей шины меняется. Поведение пустого входа — нулевая яркостная составляющая; синхронизация видеовыхода должна оставаться корректной.
- Состояние, очередь возрастов назначений и отображение изменять атомарно, исключая «рваные» кадры. Проверить автотестами назначение, вытеснение, повторное нажатие и очистку.
- **Ключевой открытый вопрос:** требуются ли регулируемые уровни/глубины смешивания каждого из 9 соединений; физические патчи сами по себе не задают коэффициенты.
- Смешивание цифровое, с предсказуемыми ограничениями уровня, чтобы не портить композитную синхронизацию.

## 7. Три независимых видеовыхода

- 3 × RCA Composite Video, по одному на OUT1/2/3, все должны работать одновременно.
- Независимые изображения на трёх выходах, но согласованная видеоразвёртка между каналами.
- **Утверждено заказчиком:** монохромный (чёрно-белый) композитный видеосигнал на всех трёх выходах; цветной видеокодер и PAL-хрома не требуются. Требуется подтвердить кадровый режим (например, 625/50 с чересстрочностью или прогрессивный вариант, если дисплеи его поддержат), разрешения рендера и качества изображения.
- Требуются выделенные выводящие тракты для 3 выходов (ЦАП/видеокодер/выходные буферы — по проекту), привязка к реальной нагрузке 75 Ом, правильные уровни и синхроимпульсы. Нельзя выдавать GPIO напрямую на RCA и считать это готовым выходом.
- До закупки — доказать одновременную работу всех трёх монохромных каналов на целевой платформе. Синхроимпульсы всех каналов генерируются общей временной базой и не смешиваются с уровнем яркости.

## 8. Встроенный дисплей

- Фронтальный экран для предпросмотра результата без внешнего монитора.
- По умолчанию — переключаемый preview OUT1 / OUT2 / OUT3; при наличии производительности возможен режим трёх миниатюр.
- Экран не должен нарушать своевременную генерацию видеосинхронизации трёх RCA.
- Размер, интерфейс и тип экрана выбрать только после составления компоновки/бюджета памяти и шин.

## 9. Передняя панель и механика

- 24 потенциометра и **6 кнопок OSC1…OSC6 с индикацией назначенного слота A/B/C**: отдельные группы из 3 горизонтальных (H1–H3) и 3 вертикальных (V1–V3) генераторов, по 4 ручки на каждый. Группы должны быть визуально различимы.
- Не менее 26 модуляционных патч-контактов. Для рекомендованного способа детектирования 9 независимых маршрутов микширования предусмотреть ещё 18 патч-контактов (9 изолированных пар). Итого исходная оценка — минимум 44 контакта, до уточнения физической реализации.
- 2 × CV TS 3.5 мм, 3 × RCA, экран, органы выбора preview/режимов (если нужны).
- На плате предусмотреть понятные маркировки, крепёж, тест-пойнты, демонтируемость дисплея и защиту от вырывания разъёмов.
- Допускается несколько соединённых PCB: основная вычислительная, панельные органы управления/патч-плата, при необходимости видеоаналоговая/питания.
- Дизайн корпуса как standalone и фронтальной панели 3U как минимум должен иметь общие монтажные точки.

## 10. Заводская сборка

- Целевая услуга — PCB + PCBA (например, JLCPCB). Все SMD заводской сборки. Выводные компоненты устанавливаются заводом при доступности услуги; крупные органы управления можно оставить для самостоятельной пайки.
- Проверять реальные артикулы, footprint, наличие в каталоге сборщика, ревизии компонентов и риск замены, а не только номиналы.
- Составить BOM с реальными manufacturer part number / supplier part number, CPL/position file, Gerber, drill, assembly drawings, фото/3D платы, полную схему KiCad.
- Не размещать заказ без предварительной проверки сборщиком и независимой ревизии принципиальной схемы и питания человеком, имеющим опыт с высокочастотной электроникой.

## 11. Порядок выполнения для Codex

**Шлюз 1 — feasibility:** сопоставить RP2350A/B, ESP32-S3 и ESP32-P4; расчёты бюджета времени на пиксель, ОЗУ, передачи данных, таймингов трёх композитных потоков + предпросмотра. Отчёт с источниками и рисками; НЕ рисовать всю PCB до прохождения этапа.

**Шлюз 2 — цифровой прототип:** разработать C/C++-ядро 6 пространственных осцилляторов, smooth morph, FM/AM/PM, патч-граф с безопасным feedback и 3×3 микшер; **FIFO-менеджер 6 кнопок → 3 слота A/B/C, включая автотесты**; host-side рендер тестовых кадров OUT1/2/3 и unit tests.

**Шлюз 3 — видеовывод:** подтвердить на девкитах/лабораторном прототипе 3 одновременно работающих композитных видеовыхода; если невозможно на выбранном MCU без дополнительных узлов, подготовить прозрачную переработку архитектуры.

**Шлюз 4 — схемотехника:** раздельные листы KiCad: питание USB/Eurorack, MCU/память, 24 потенциометра, 6 кнопок выбора OSC, их индикацию и опрос, сканер патчей, 2 × CV с защитой, 3 × видео, TFT; ERC и проверка питаний.

**Шлюз 5 — разводка:** компоновка фронтальной панели, тепловой/помеховый анализ, импедансы и видеотракты, DRC, 3D preview и примерка в 3U; проверить все доступные для монтажа у производителя footprint.

**Шлюз 6 — производство:** подготовить Gerber/Excellon, BOM, CPL, документацию по ручным компонентам, смету, последовательность сборки и тест-план; независимая ревизия до оплаты.

## 12. Что Codex обязан выдать

- `docs/requirements.md` — утверждённое ТЗ и список допущений.
- `docs/feasibility.md` — сравнение процессоров, RAM/DMA/выходов/дисплея с измеряемыми расчётами.
- `docs/architecture.md` — архитектура сигнального графа, временных задержек, патч-детектора и приоритетов задач.
- `firmware/` — собираемый код, автотесты, тестовые векторные паттерны.
- `hardware/kicad/` — редактируемый исходник проекта KiCad с проверяемой схемой и PCB.
- `hardware/panel/` — размеры передней панели, отверстия, компонентный layout и 3D-проверка.
- `manufacturing/` — Gerber, BOM, CPL, монтажная документация, список вручную устанавливаемых деталей.
- `docs/bringup.md` — пошаговая безопасная первая проверка собранных плат с мультиметром и при необходимости осциллографом, включая условия остановки при сбоях.
- `docs/risks.md` — незакрытые технические риски и требуемые проверки инженером.

## 13. Вопросы, которые нельзя молча угадать

1. **Решено:** 6 осцилляторов делятся на 3 горизонтальных (H1–H3) и 3 вертикальных (V1–V3).
2. Утверждены **3 независимых монохромных композитных выхода**. Какой видеорежим — PAL 625/50 interlaced либо 288p-like progressive?
3. **Решено:** шесть кнопок, по одной на каждый OSC; свободные A/B/C заполняются по порядку, после заполнения вытесняется наиболее старое текущее назначение. **На согласование:** короткое повторное нажатие активного OSC игнорируется; длительное нажатие освобождает слот.
4. Как задаётся глубина каждого соединения в матрице модуляции и микширования?
5. Допускается ли один провод с несколькими назначениями и несколько источников на одном назначении?
6. Какой максимум ширины Eurorack (HP) приемлем и как физически реализуем 9 одновременных маршрутов микшера?
7. Требуется ли обновление параметров FM/AM/PM на скорости пикселей или допустима более низкая частота управления для некоторых модулей?

**Изменения v0.4:** добавлено утверждённое управление шестью осцилляторами через шесть кнопок с программным FIFO-назначением на три входа A/B/C матрицы микширования; пример алгоритма, индикация, предлагаемые правила повторного/длительного нажатия, тесты и влияние на панель. Зафиксирована цель защиты цифровых патч-контактов от случайных внешних ±15 В (без заявлений о доказанной устойчивости).

**Изменения v0.3:** заказчик подтвердил ровно 3 горизонтальных + 3 вертикальных осциллятора. Обновлены компоновка панели, минимальное число контактов при рекомендуемой схеме микшерной матрицы (26 + 18 = 44) и список открытых вопросов.

**Изменения v0.2:** утверждены 6 вместо 8 генераторов, 24 вместо 32 ручек, 3 независимых монохромных выхода; подтверждён полностью цифровой принцип **обеих** патч-матриц. Добавлено требование проверки физического one-to-many/many-to-one патчинга и индикации/сканирования связей.

**Принцип:** не начинать изготовление дорогостоящей платы, пока требования, цифровой прототип и способ генерации трёх видео-каналов не проверены. Codex может выполнять разработку, но аппаратные ошибки окончательно обнаруживаются измерениями на физических прототипах.

## Полезные спецификации и источники

- RP2350 official: https://www.raspberrypi.com/products/rp2350/
- Raspberry Pi MCU specifications: https://www.raspberrypi.com/documentation/microcontrollers/microcontroller-chips.html
- ESP32-P4 official datasheet: https://documentation.espressif.com/esp32-p4_datasheet_en.html
- Eurorack power: https://doepfer.de/a100_man/a100t_e.htm
- JLCPCB PCBA services: https://jlcpcb.com/help/article/pcb-assembly-faqs
- Composite video background: https://www.analog.com/en/resources/technical-articles/understanding-analog-video-signals.html
