Guadonna/VideoSynth/docs/summary-v0.4.md

# VideoSynth: краткая выжимка исследования v0.4

Обновлено 23.10.2026. [Полный отчёт](feasibility-v0.4.md), [PDF](feasibility-v0.4.pdf), [проверка ранее заблокированных источников](research-v0.4/verification-update.md).

**Три независимых монохромных изображения с общей развёрткой 625/50 технически реализуемы. Полное ТЗ на выбранном MCU пока не доказано:** основные ограничения — тяжёлая перекрёстная модуляция, защита/сканирование патчей и качество аналогового видео. Рекомендация для сравнительного прототипа сохраняется: **ESP32-P4 для DSP/UI + RP2350B для видеотайминга**, параллельно сравнить варианты с одним RP2350B и одним P4. Начальная точка измерений — 360×288 при 25 обновлениях/с; это предложение, а не утверждённое изменение ТЗ.

Сетевые блокировки сняты. Прочитаны datasheet, ITU и USB-IF, проверен публичный каталог JLCPCB. Дополнительные разрешения среды для этой работы не нужны. Электрическая схема, PCB и производственные заказы не создавались.

Важные изменения после проверки:

- **Защиту патчей нужно переработать.** ADG7421F защищает внешний S-пин при отключённом питании, но не гарантирует сканирование прямыми уровнями 0/3,3 В. Предложены смещённые уровни, отдельные драйверы/компараторы и 6 экспандеров вместо 3. Это архитектурный кандидат, ещё без электрической квалификации.
- **Видеовыход требует уточнения.** SYNC в ADV7125 действует только на один из трёх DAC. Фильтр THS7314 8,5 МГц недостаточен как единственный фильтр для широкополосного содержимого при 13,5 MSPS. Нужны согласованные фильтрация/интерполяция и одинаковая синхронизация трёх выходов.
- **CV-ADC заменён в shortlist.** ADS8684 имеет полосу −3 дБ 15 кГц, поэтому для CV до 20 кГц предложены 2×ADS8866 с внешним защищённым аналоговым трактом. Частота преобразований сама по себе не доказывает полезную полосу.
- **Питание уточнено.** TPS62133 — фиксированный 5-В регулятор; для 3,3 В нужны TPS62132 или регулируемый TPS62130. Учтено отдельное питание ядра P4. USB-C 5 В реализуем, но допустимый ток определяется CC; полный режим нельзя обещать от любого USB-порта.
- **JLCPCB проверен предметно.** RP2350B и большинство базовых IC найдены. P4 ревизии X — под заказ, ADG7421F в наличии 7 шт. при потребности 22 на прибор. Consignment/Global Sourcing поддерживаются, однако весь BOM сейчас складом не обеспечен.

Обновлённый резерв: **$250–420 за электронику**, ориентировочно **$280–525 с PCB и сборкой**, без доставки, налогов и механики. Это расчётный диапазон, не котировка завода. Защита 44 контактов — одна из главных статей стоимости.

Перед проектированием стоит дополнить ТЗ:

1. **Разрешение и производительность:** минимальное качество, 25/50 обновлений, допустимое число одновременно активных pixel-rate FM/AM/PM-связей, поведение при перегрузке и задержка feedback.
2. **Семантика патчей:** однопроводная сеть позволяет определить связанные группы, но не отдельные кабели внутри них. Выбрать групповую модель либо другую систему маршрутизации; задать fan-out, длины кабелей и требуемую задержку обнаружения.
3. **CV:** диапазон, полезная полоса и допустимый спад/ошибка, необходимость синхронного sampling и защита при выключенном питании.
4. **Качество видео:** полезная полоса и уровни, список приёмников для совместимости; различить монохромный 625/50 и строгий студийный PAL с допуском частоты цветного стандарта ±0,2 ppm.
5. **Питание и механика:** поведение от слабого USB, предельный ток Eurorack, габариты/HP, конкретные гнёзда и экран, тираж и целевая цена.

Без физических испытаний остаются неподтверждёнными FPS и DMA-устойчивость, три нагруженных 75-омных выхода, реальная защита ±15 В on/off, сканирование длинных групп, CV-шум/полоса, hot-plug, потребление и нагрев. План этих испытаний приведён в §15 полного отчёта. Переход к схеме и PCB требует отдельного согласования.
