Guadonna/VideoSynth/docs/r1/screenshots/dsp-compatibility-mobile.png

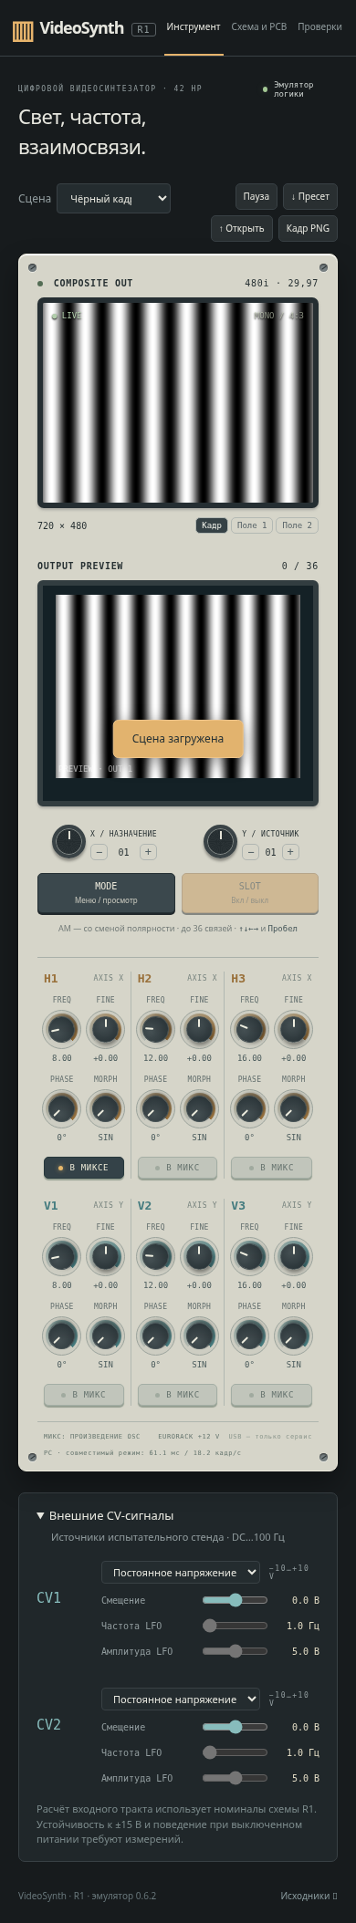
docs/r1/screenshots/dsp-compatibility-mobile.png
