Guadonna/VideoSynth/docs/r1/screenshots/emulator-mobile.png

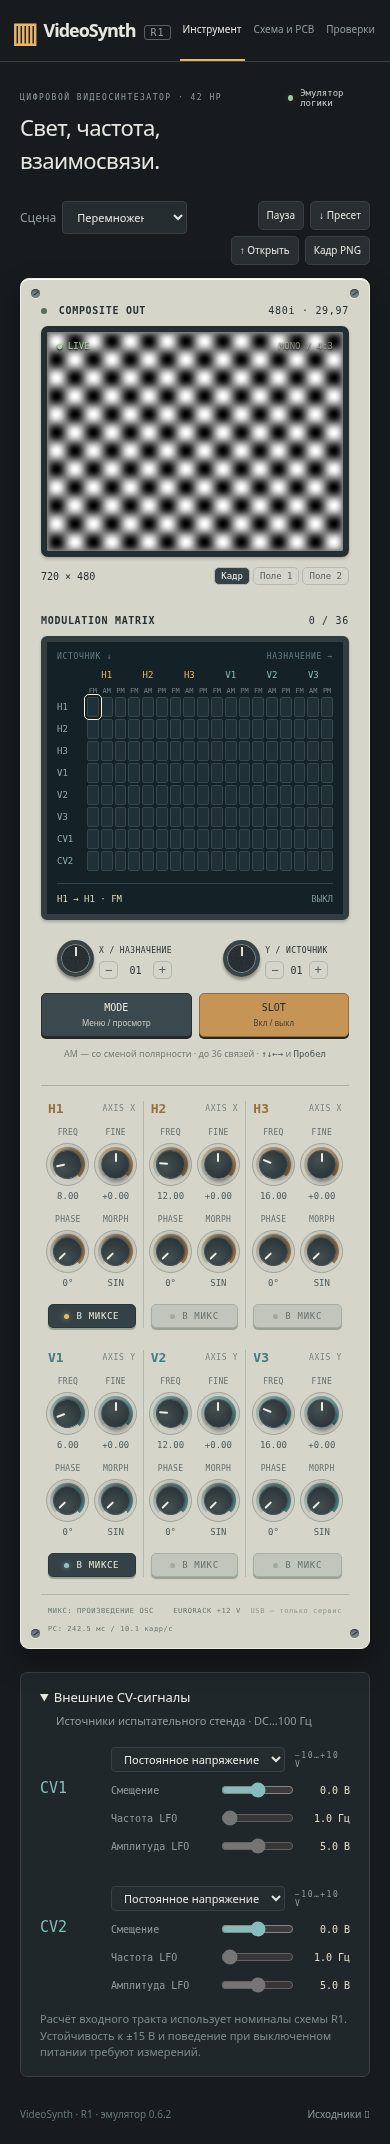
docs/r1/screenshots/emulator-mobile.png
