Guadonna/VideoSynth/docs/r1/screenshots/hardware.png

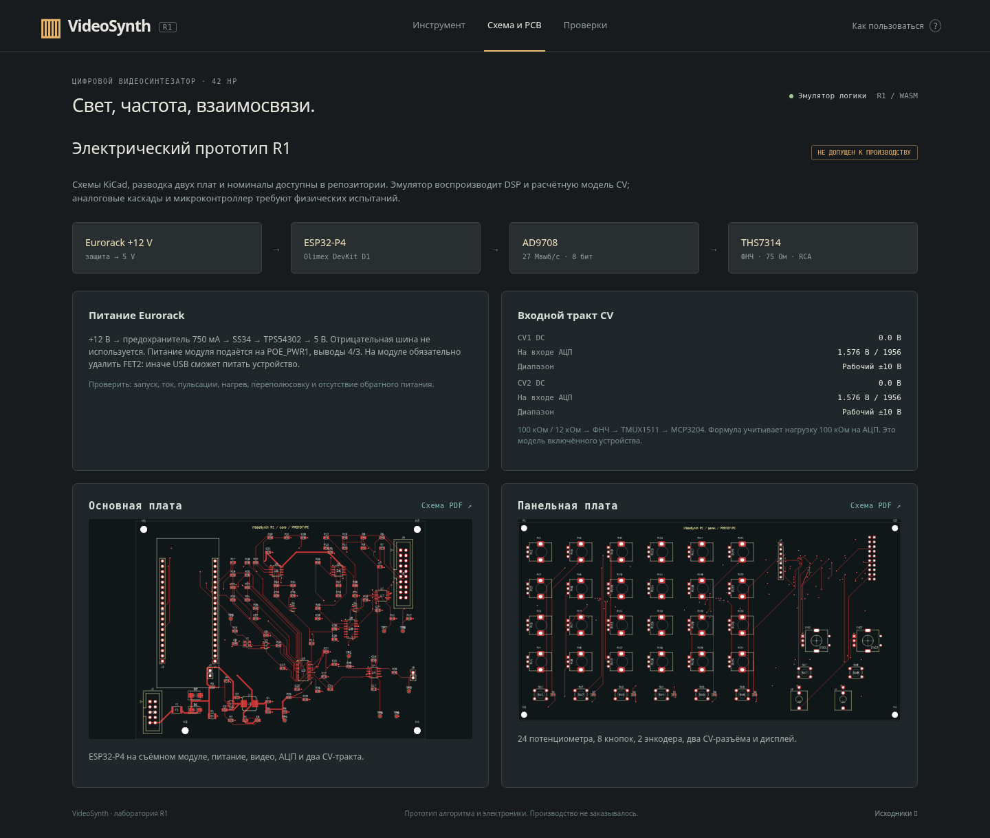
docs/r1/screenshots/hardware.png
