Guadonna/VideoSynth/docs/r1/screenshots/panel-layout.png

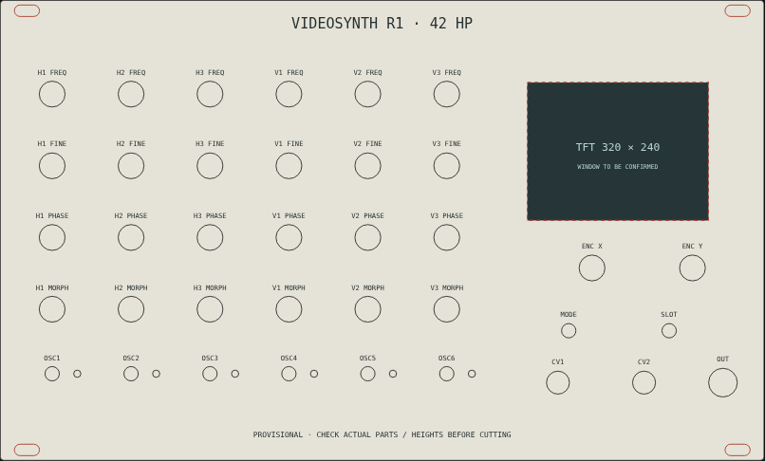
docs/r1/screenshots/panel-layout.png
