Guadonna/VideoSynth/hardware/bom-r1.csv

board | reference | value | manufacturer_part | footprint | assembly | qualification | note
core | J1 | EURORACK_10 |  | Connector_IDC:IDC-Header_2x05_P2.54mm_Vertical | THT/module | MPN to select: verify value / rating / package | Stripe = pins 1/2, -12 V NC. Use keyed 10-pin ribbon.
core | F1 | 750mA HOLD 33V | Bourns MF-MSMF075-2 | Fuse:Fuse_1812_4532Metric | SMD | candidate MPN: approve exact orderable part
core | D1 | SS34 | SS34 | Diode_SMD:D_SMA | SMD | candidate MPN: approve exact orderable part | Series reverse polarity diode, 40 V
core | D2 | SMBJ15A | SMBJ15A | Diode_SMD:D_SMB | SMD | candidate MPN: approve exact orderable part | TVS after fuse/series diode; surge qualification required
core | C1 | 22u 35V X7R | GRM32ER7YA226KE15L | Capacitor_SMD:C_1210_3225Metric | SMD | candidate MPN: approve exact orderable part
core | C2 | 100n 50V X7R |  | Capacitor_SMD:C_0805_2012Metric | SMD | MPN to select: verify value / rating / package
core | U1 | TPS54302DDCR | TPS54302DDCR | Package_TO_SOT_SMD:SOT-23-6 | SMD | candidate MPN: approve exact orderable part
core | C3 | 100n 16V X7R |  | Capacitor_SMD:C_0805_2012Metric | SMD | MPN to select: verify value / rating / package
core | L1 | 6.8uH verify Isat | SRP7028A-6R8M | Inductor_SMD:L_Bourns_SRP7028A_7.3x6.6mm | SMD | candidate MPN: approve exact orderable part
core | C4 | 22u 10V X7R |  | Capacitor_SMD:C_0805_2012Metric | SMD | MPN to select: verify value / rating / package
core | C5 | 22u 10V X7R |  | Capacitor_SMD:C_0805_2012Metric | SMD | MPN to select: verify value / rating / package
core | R1 | 100k 1% |  | Resistor_SMD:R_0805_2012Metric | SMD | MPN to select: verify value / rating / package
core | R2 | 13.3k 1% |  | Resistor_SMD:R_0805_2012Metric | SMD | MPN to select: verify value / rating / package
core | C6 | 75p C0G |  | Capacitor_SMD:C_0805_2012Metric | SMD | MPN to select: verify value / rating / package
core | R3 | 100k 1% |  | Resistor_SMD:R_0805_2012Metric | SMD | MPN to select: verify value / rating / package
core | R4 | 24.9k 1% |  | Resistor_SMD:R_0805_2012Metric | SMD | MPN to select: verify value / rating / package
core | R5 | 1k 1% |  | Resistor_SMD:R_0805_2012Metric | SMD | MPN to select: verify value / rating / package | Rail discharge / small fault-current sink; 25 mW nominal
core | J2 | MODULE_5VP_GND |  | Connector_PinHeader_2.54mm:PinHeader_1x02_P2.54mm_Vertical | THT/module | MPN to select: verify value / rating / package | Harness to Olimex POE_PWR1: our pin1 -> module pin4; our pin2 -> module pin3. Pins1/2 PoE never connected.
core | J3 | OLIMEX_EXT1 |  | Connector_PinSocket_2.54mm:PinSocket_1x20_P2.54mm_Vertical | THT/module | MPN to select: verify value / rating / package | Olimex ESP32-P4-DevKit Rev.D1 EXT1, top-view exact pin correspondence
core | J4 | OLIMEX_EXT2 |  | Connector_PinSocket_2.54mm:PinSocket_1x20_P2.54mm_Vertical | THT/module | MPN to select: verify value / rating / package | EXT2 pin1 +5V intentionally NC. Supply through POE_PWR1 only. REMOVE module FET2 to disconnect USB power.
core | J5 | PANEL_20 |  | Connector_IDC:IDC-Header_2x10_P2.54mm_Vertical | THT/module | MPN to select: verify value / rating / package | Straight-through keyed cable <=50 mm, same pin numbers on panel.
core | R6 | 33 |  | Resistor_SMD:R_0805_2012Metric | SMD | MPN to select: verify value / rating / package
core | R7 | 33 |  | Resistor_SMD:R_0805_2012Metric | SMD | MPN to select: verify value / rating / package
core | R8 | 2.2k |  | Resistor_SMD:R_0805_2012Metric | SMD | MPN to select: verify value / rating / package
core | R9 | 2.2k |  | Resistor_SMD:R_0805_2012Metric | SMD | MPN to select: verify value / rating / package
core | R10 | 10k |  | Resistor_SMD:R_0805_2012Metric | SMD | MPN to select: verify value / rating / package
core | R11 | 10k |  | Resistor_SMD:R_0805_2012Metric | SMD | MPN to select: verify value / rating / package
core | R12 | 10k |  | Resistor_SMD:R_0805_2012Metric | SMD | MPN to select: verify value / rating / package
core | R13 | 10k |  | Resistor_SMD:R_0805_2012Metric | SMD | MPN to select: verify value / rating / package
core | R14 | 100k |  | Resistor_SMD:R_0805_2012Metric | SMD | MPN to select: verify value / rating / package
core | C7 | 10u 10V X7R |  | Capacitor_SMD:C_0805_2012Metric | SMD | MPN to select: verify value / rating / package
core | Y1 | 27.000MHz 3V3 | ASE-27.000MHZ-LC-T | Oscillator:Oscillator_SMD_Abracon_ASE-4Pin_3.2x2.5mm | SMD | candidate MPN: approve exact orderable part
core | C8 | 100n 16V X7R |  | Capacitor_SMD:C_0805_2012Metric | SMD | MPN to select: verify value / rating / package
core | R15 | 33 |  | Resistor_SMD:R_0805_2012Metric | SMD | MPN to select: verify value / rating / package
core | U2 | SN74LVC1G04DBVR | SN74LVC1G04DBVR | Package_TO_SOT_SMD:SOT-23-5 | SMD | candidate MPN: approve exact orderable part
core | C9 | 100n 16V X7R |  | Capacitor_SMD:C_0805_2012Metric | SMD | MPN to select: verify value / rating / package
core | R16 | 33 |  | Resistor_SMD:R_0805_2012Metric | SMD | MPN to select: verify value / rating / package
core | U3 | AD9708ARUZ | AD9708ARUZ | Package_SO:TSSOP-28_4.4x9.7mm_P0.65mm | SMD | candidate MPN: approve exact orderable part
core | R17 | 33 |  | Resistor_SMD:R_0805_2012Metric | SMD | MPN to select: verify value / rating / package
core | R18 | 33 |  | Resistor_SMD:R_0805_2012Metric | SMD | MPN to select: verify value / rating / package
core | R19 | 33 |  | Resistor_SMD:R_0805_2012Metric | SMD | MPN to select: verify value / rating / package
core | R20 | 33 |  | Resistor_SMD:R_0805_2012Metric | SMD | MPN to select: verify value / rating / package
core | R21 | 33 |  | Resistor_SMD:R_0805_2012Metric | SMD | MPN to select: verify value / rating / package
core | R22 | 33 |  | Resistor_SMD:R_0805_2012Metric | SMD | MPN to select: verify value / rating / package
core | R23 | 33 |  | Resistor_SMD:R_0805_2012Metric | SMD | MPN to select: verify value / rating / package
core | R24 | 33 |  | Resistor_SMD:R_0805_2012Metric | SMD | MPN to select: verify value / rating / package
core | R25 | 1 1% |  | Resistor_SMD:R_0805_2012Metric | SMD | MPN to select: verify value / rating / package
core | C10 | 22u 10V X7R |  | Capacitor_SMD:C_0805_2012Metric | SMD | MPN to select: verify value / rating / package
core | C11 | 100n 16V X7R |  | Capacitor_SMD:C_0805_2012Metric | SMD | MPN to select: verify value / rating / package
core | C12 | 100n 16V X7R |  | Capacitor_SMD:C_0805_2012Metric | SMD | MPN to select: verify value / rating / package
core | C13 | 100n 16V X7R |  | Capacitor_SMD:C_0805_2012Metric | SMD | MPN to select: verify value / rating / package
core | R26 | 1.91k 0.1% |  | Resistor_SMD:R_0805_2012Metric | SMD | MPN to select: verify value / rating / package
core | C14 | 100n 16V X7R |  | Capacitor_SMD:C_0805_2012Metric | SMD | MPN to select: verify value / rating / package
core | C15 | 100n 16V X7R |  | Capacitor_SMD:C_0805_2012Metric | SMD | MPN to select: verify value / rating / package
core | R27 | 49.9 0.1% |  | Resistor_SMD:R_0805_2012Metric | SMD | MPN to select: verify value / rating / package
core | R28 | 49.9 0.1% |  | Resistor_SMD:R_0805_2012Metric | SMD | MPN to select: verify value / rating / package
core | U4 | THS7314D | THS7314D | Package_SO:SOIC-8_3.9x4.9mm_P1.27mm | SMD | candidate MPN: approve exact orderable part | Gain 2, 8.5MHz fifth-order LPF, +285mV output level shift
core | C16 | 100n 16V X7R |  | Capacitor_SMD:C_0805_2012Metric | SMD | MPN to select: verify value / rating / package
core | C17 | 10u 10V X7R |  | Capacitor_SMD:C_0805_2012Metric | SMD | MPN to select: verify value / rating / package
core | R29 | 75 1% |  | Resistor_SMD:R_0805_2012Metric | SMD | MPN to select: verify value / rating / package
core | J6 | CVBS_COAX |  | Connector_PinHeader_2.54mm:PinHeader_1x02_P2.54mm_Vertical | THT/module | MPN to select: verify value / rating / package | Short 75 ohm coax to panel RCA; no second 75 ohm shunt on PCB.
core | TP1 | DAC_A |  | TestPoint:TestPoint_Pad_D1.5mm | THT/module | MPN to select: verify value / rating / package
core | TP2 | CVBS |  | TestPoint:TestPoint_Pad_D1.5mm | THT/module | MPN to select: verify value / rating / package
core | TP3 | CLK_P4 |  | TestPoint:TestPoint_Pad_D1.5mm | THT/module | MPN to select: verify value / rating / package
core | R30 | 12.4k 0.1% |  | Resistor_SMD:R_0805_2012Metric | SMD | MPN to select: verify value / rating / package
core | R31 | 10k 0.1% |  | Resistor_SMD:R_0805_2012Metric | SMD | MPN to select: verify value / rating / package
core | C18 | 1u 10V X7R |  | Capacitor_SMD:C_0805_2012Metric | SMD | MPN to select: verify value / rating / package
core | R32 | 100k 0.1% |  | Resistor_SMD:R_0805_2012Metric | SMD | MPN to select: verify value / rating / package
core | R33 | 12k 0.1% |  | Resistor_SMD:R_0805_2012Metric | SMD | MPN to select: verify value / rating / package
core | C19 | 47n 5% X7R |  | Capacitor_SMD:C_0805_2012Metric | SMD | MPN to select: verify value / rating / package
core | R34 | 4.7k 1% |  | Resistor_SMD:R_0805_2012Metric | SMD | MPN to select: verify value / rating / package
core | C20 | 100n 5% X7R |  | Capacitor_SMD:C_0805_2012Metric | SMD | MPN to select: verify value / rating / package
core | D3 | BAT54S | BAT54S | Package_TO_SOT_SMD:SOT-23 | SMD | candidate MPN: approve exact orderable part | Series pair clamp. Exact forward voltage and power-off behavior require bench test.
core | U5 | OPA2197IDR | OPA2197IDR | Package_SO:SOIC-8_3.9x4.9mm_P1.27mm | SMD | candidate MPN: approve exact orderable part
core | C21 | 100n 16V X7R |  | Capacitor_SMD:C_0805_2012Metric | SMD | MPN to select: verify value / rating / package
core | R35 | 47 |  | Resistor_SMD:R_0805_2012Metric | SMD | MPN to select: verify value / rating / package
core | C22 | 1n C0G |  | Capacitor_SMD:C_0805_2012Metric | SMD | MPN to select: verify value / rating / package
core | R36 | 100k 0.1% |  | Resistor_SMD:R_0805_2012Metric | SMD | MPN to select: verify value / rating / package
core | R37 | 12k 0.1% |  | Resistor_SMD:R_0805_2012Metric | SMD | MPN to select: verify value / rating / package
core | C23 | 47n 5% X7R |  | Capacitor_SMD:C_0805_2012Metric | SMD | MPN to select: verify value / rating / package
core | R38 | 4.7k 1% |  | Resistor_SMD:R_0805_2012Metric | SMD | MPN to select: verify value / rating / package
core | C24 | 100n 5% X7R |  | Capacitor_SMD:C_0805_2012Metric | SMD | MPN to select: verify value / rating / package
core | D4 | BAT54S | BAT54S | Package_TO_SOT_SMD:SOT-23 | SMD | candidate MPN: approve exact orderable part | Series pair clamp. Exact forward voltage and power-off behavior require bench test.
core | U6 | OPA2197IDR | OPA2197IDR | Package_SO:SOIC-8_3.9x4.9mm_P1.27mm | SMD | candidate MPN: approve exact orderable part
core | C25 | 100n 16V X7R |  | Capacitor_SMD:C_0805_2012Metric | SMD | MPN to select: verify value / rating / package
core | R39 | 47 |  | Resistor_SMD:R_0805_2012Metric | SMD | MPN to select: verify value / rating / package
core | C26 | 1n C0G |  | Capacitor_SMD:C_0805_2012Metric | SMD | MPN to select: verify value / rating / package
core | R40 | 1k 1% |  | Resistor_SMD:R_0805_2012Metric | SMD | MPN to select: verify value / rating / package | 3.3 mA bleeder absorbs specified clamp-current budget; not a replacement for power-off test
core | U7 | TMUX1511PWR | TMUX1511PWR | Package_SO:TSSOP-14_4.4x5mm_P0.65mm | SMD | candidate MPN: approve exact orderable part | Powered-off isolation valid only for signal nodes 0..3.6V; verify both CV fault polarities.
core | C27 | 100n 16V X7R |  | Capacitor_SMD:C_0805_2012Metric | SMD | MPN to select: verify value / rating / package
core | R41 | 100k |  | Resistor_SMD:R_0805_2012Metric | SMD | MPN to select: verify value / rating / package
core | R42 | 100k |  | Resistor_SMD:R_0805_2012Metric | SMD | MPN to select: verify value / rating / package
core | U8 | MCP3204-CI/SL | MCP3204-CI/SL | Package_SO:SOIC-14_3.9x8.7mm_P1.27mm | SMD | candidate MPN: approve exact orderable part
core | C28 | 100n 16V X7R |  | Capacitor_SMD:C_0805_2012Metric | SMD | MPN to select: verify value / rating / package
core | C29 | 1u 10V X7R |  | Capacitor_SMD:C_0805_2012Metric | SMD | MPN to select: verify value / rating / package
core | TP4 | V5 |  | TestPoint:TestPoint_Pad_D1.5mm | THT/module | MPN to select: verify value / rating / package
core | TP5 | V3V3 |  | TestPoint:TestPoint_Pad_D1.5mm | THT/module | MPN to select: verify value / rating / package
core | TP6 | GND |  | TestPoint:TestPoint_Pad_D1.5mm | THT/module | MPN to select: verify value / rating / package
core | TP7 | CV1_ADC |  | TestPoint:TestPoint_Pad_D1.5mm | THT/module | MPN to select: verify value / rating / package
core | TP8 | CV2_ADC |  | TestPoint:TestPoint_Pad_D1.5mm | THT/module | MPN to select: verify value / rating / package
panel | J1 | CORE_20 |  | Connector_IDC:IDC-Header_2x10_P2.54mm_Vertical | THT/module | MPN to select: verify value / rating / package | Pin-for-pin cable to core PANEL_20, inspect pin1 on both faces
panel | C1 | 10u 10V X7R |  | Capacitor_SMD:C_0805_2012Metric | SMD | MPN to select: verify value / rating / package
panel | U1 | MCP23017-E/SO | MCP23017-E/SO | Package_SO:SOIC-28W_7.5x17.9mm_P1.27mm | SMD | candidate MPN: approve exact orderable part | I2C address 0x20; IRQ open-drain active-low; configure output latches before direction.
panel | C2 | 100n 16V X7R |  | Capacitor_SMD:C_0805_2012Metric | SMD | MPN to select: verify value / rating / package
panel | U2 | MCP23017-E/SO | MCP23017-E/SO | Package_SO:SOIC-28W_7.5x17.9mm_P1.27mm | SMD | candidate MPN: approve exact orderable part | I2C address 0x21; IRQ open-drain active-low; configure output latches before direction.
panel | C3 | 100n 16V X7R |  | Capacitor_SMD:C_0805_2012Metric | SMD | MPN to select: verify value / rating / package
panel | R1 | 10k |  | Resistor_SMD:R_0805_2012Metric | SMD | MPN to select: verify value / rating / package
panel | C4 | 100n 16V X7R |  | Capacitor_SMD:C_0805_2012Metric | SMD | MPN to select: verify value / rating / package
panel | R2 | 100k |  | Resistor_SMD:R_0805_2012Metric | SMD | MPN to select: verify value / rating / package
panel | R3 | 100k |  | Resistor_SMD:R_0805_2012Metric | SMD | MPN to select: verify value / rating / package
panel | R4 | 100k |  | Resistor_SMD:R_0805_2012Metric | SMD | MPN to select: verify value / rating / package
panel | R5 | 100k |  | Resistor_SMD:R_0805_2012Metric | SMD | MPN to select: verify value / rating / package
panel | RV1 | 10k B linear | ALPS RK09K1130A6S | Potentiometer_THT:Potentiometer_Alps_RK09K_Single_Vertical | THT/module | candidate MPN: approve exact orderable part | H1 frequency; shaft=(12,16) mm
panel | RV2 | 10k B linear | ALPS RK09K1130A6S | Potentiometer_THT:Potentiometer_Alps_RK09K_Single_Vertical | THT/module | candidate MPN: approve exact orderable part | H1 fine; shaft=(12,36) mm
panel | RV3 | 10k B linear | ALPS RK09K1130A6S | Potentiometer_THT:Potentiometer_Alps_RK09K_Single_Vertical | THT/module | candidate MPN: approve exact orderable part | H1 phase; shaft=(12,56) mm
panel | RV4 | 10k B linear | ALPS RK09K1130A6S | Potentiometer_THT:Potentiometer_Alps_RK09K_Single_Vertical | THT/module | candidate MPN: approve exact orderable part | H1 morph; shaft=(12,76) mm
panel | RV5 | 10k B linear | ALPS RK09K1130A6S | Potentiometer_THT:Potentiometer_Alps_RK09K_Single_Vertical | THT/module | candidate MPN: approve exact orderable part | H2 frequency; shaft=(34,16) mm
panel | RV6 | 10k B linear | ALPS RK09K1130A6S | Potentiometer_THT:Potentiometer_Alps_RK09K_Single_Vertical | THT/module | candidate MPN: approve exact orderable part | H2 fine; shaft=(34,36) mm
panel | RV7 | 10k B linear | ALPS RK09K1130A6S | Potentiometer_THT:Potentiometer_Alps_RK09K_Single_Vertical | THT/module | candidate MPN: approve exact orderable part | H2 phase; shaft=(34,56) mm
panel | RV8 | 10k B linear | ALPS RK09K1130A6S | Potentiometer_THT:Potentiometer_Alps_RK09K_Single_Vertical | THT/module | candidate MPN: approve exact orderable part | H2 morph; shaft=(34,76) mm
panel | RV9 | 10k B linear | ALPS RK09K1130A6S | Potentiometer_THT:Potentiometer_Alps_RK09K_Single_Vertical | THT/module | candidate MPN: approve exact orderable part | H3 frequency; shaft=(56,16) mm
panel | RV10 | 10k B linear | ALPS RK09K1130A6S | Potentiometer_THT:Potentiometer_Alps_RK09K_Single_Vertical | THT/module | candidate MPN: approve exact orderable part | H3 fine; shaft=(56,36) mm
panel | RV11 | 10k B linear | ALPS RK09K1130A6S | Potentiometer_THT:Potentiometer_Alps_RK09K_Single_Vertical | THT/module | candidate MPN: approve exact orderable part | H3 phase; shaft=(56,56) mm
panel | RV12 | 10k B linear | ALPS RK09K1130A6S | Potentiometer_THT:Potentiometer_Alps_RK09K_Single_Vertical | THT/module | candidate MPN: approve exact orderable part | H3 morph; shaft=(56,76) mm
panel | RV13 | 10k B linear | ALPS RK09K1130A6S | Potentiometer_THT:Potentiometer_Alps_RK09K_Single_Vertical | THT/module | candidate MPN: approve exact orderable part | V1 frequency; shaft=(78,16) mm
panel | RV14 | 10k B linear | ALPS RK09K1130A6S | Potentiometer_THT:Potentiometer_Alps_RK09K_Single_Vertical | THT/module | candidate MPN: approve exact orderable part | V1 fine; shaft=(78,36) mm
panel | RV15 | 10k B linear | ALPS RK09K1130A6S | Potentiometer_THT:Potentiometer_Alps_RK09K_Single_Vertical | THT/module | candidate MPN: approve exact orderable part | V1 phase; shaft=(78,56) mm
panel | RV16 | 10k B linear | ALPS RK09K1130A6S | Potentiometer_THT:Potentiometer_Alps_RK09K_Single_Vertical | THT/module | candidate MPN: approve exact orderable part | V1 morph; shaft=(78,76) mm
panel | RV17 | 10k B linear | ALPS RK09K1130A6S | Potentiometer_THT:Potentiometer_Alps_RK09K_Single_Vertical | THT/module | candidate MPN: approve exact orderable part | V2 frequency; shaft=(100,16) mm
panel | RV18 | 10k B linear | ALPS RK09K1130A6S | Potentiometer_THT:Potentiometer_Alps_RK09K_Single_Vertical | THT/module | candidate MPN: approve exact orderable part | V2 fine; shaft=(100,36) mm
panel | RV19 | 10k B linear | ALPS RK09K1130A6S | Potentiometer_THT:Potentiometer_Alps_RK09K_Single_Vertical | THT/module | candidate MPN: approve exact orderable part | V2 phase; shaft=(100,56) mm
panel | RV20 | 10k B linear | ALPS RK09K1130A6S | Potentiometer_THT:Potentiometer_Alps_RK09K_Single_Vertical | THT/module | candidate MPN: approve exact orderable part | V2 morph; shaft=(100,76) mm
panel | RV21 | 10k B linear | ALPS RK09K1130A6S | Potentiometer_THT:Potentiometer_Alps_RK09K_Single_Vertical | THT/module | candidate MPN: approve exact orderable part | V3 frequency; shaft=(122,16) mm
panel | RV22 | 10k B linear | ALPS RK09K1130A6S | Potentiometer_THT:Potentiometer_Alps_RK09K_Single_Vertical | THT/module | candidate MPN: approve exact orderable part | V3 fine; shaft=(122,36) mm
panel | RV23 | 10k B linear | ALPS RK09K1130A6S | Potentiometer_THT:Potentiometer_Alps_RK09K_Single_Vertical | THT/module | candidate MPN: approve exact orderable part | V3 phase; shaft=(122,56) mm
panel | RV24 | 10k B linear | ALPS RK09K1130A6S | Potentiometer_THT:Potentiometer_Alps_RK09K_Single_Vertical | THT/module | candidate MPN: approve exact orderable part | V3 morph; shaft=(122,76) mm
panel | U3 | CD74HC4067M96 | CD74HC4067M96 | Package_SO:SOIC-24W_7.5x15.4mm_P1.27mm | SMD | candidate MPN: approve exact orderable part
panel | C5 | 100n 16V X7R |  | Capacitor_SMD:C_0805_2012Metric | SMD | MPN to select: verify value / rating / package
panel | U4 | CD74HC4067M96 | CD74HC4067M96 | Package_SO:SOIC-24W_7.5x15.4mm_P1.27mm | SMD | candidate MPN: approve exact orderable part
panel | C6 | 100n 16V X7R |  | Capacitor_SMD:C_0805_2012Metric | SMD | MPN to select: verify value / rating / package
panel | SW1 | OSC1 | Omron B3F-1000 | Button_Switch_THT:SW_PUSH_6mm | THT/module | candidate MPN: approve exact orderable part | Momentary; latched in software
panel | R6 | 10k |  | Resistor_SMD:R_0805_2012Metric | SMD | MPN to select: verify value / rating / package
panel | D1 | LED green | LTST-C190KGKT | LED_SMD:LED_0603_1608Metric | SMD | candidate MPN: approve exact orderable part
panel | R7 | 1k |  | Resistor_SMD:R_0805_2012Metric | SMD | MPN to select: verify value / rating / package
panel | SW2 | OSC2 | Omron B3F-1000 | Button_Switch_THT:SW_PUSH_6mm | THT/module | candidate MPN: approve exact orderable part | Momentary; latched in software
panel | R8 | 10k |  | Resistor_SMD:R_0805_2012Metric | SMD | MPN to select: verify value / rating / package
panel | D2 | LED green | LTST-C190KGKT | LED_SMD:LED_0603_1608Metric | SMD | candidate MPN: approve exact orderable part
panel | R9 | 1k |  | Resistor_SMD:R_0805_2012Metric | SMD | MPN to select: verify value / rating / package
panel | SW3 | OSC3 | Omron B3F-1000 | Button_Switch_THT:SW_PUSH_6mm | THT/module | candidate MPN: approve exact orderable part | Momentary; latched in software
panel | R10 | 10k |  | Resistor_SMD:R_0805_2012Metric | SMD | MPN to select: verify value / rating / package
panel | D3 | LED green | LTST-C190KGKT | LED_SMD:LED_0603_1608Metric | SMD | candidate MPN: approve exact orderable part
panel | R11 | 1k |  | Resistor_SMD:R_0805_2012Metric | SMD | MPN to select: verify value / rating / package
panel | SW4 | OSC4 | Omron B3F-1000 | Button_Switch_THT:SW_PUSH_6mm | THT/module | candidate MPN: approve exact orderable part | Momentary; latched in software
panel | R12 | 10k |  | Resistor_SMD:R_0805_2012Metric | SMD | MPN to select: verify value / rating / package
panel | D4 | LED green | LTST-C190KGKT | LED_SMD:LED_0603_1608Metric | SMD | candidate MPN: approve exact orderable part
panel | R13 | 1k |  | Resistor_SMD:R_0805_2012Metric | SMD | MPN to select: verify value / rating / package
panel | SW5 | OSC5 | Omron B3F-1000 | Button_Switch_THT:SW_PUSH_6mm | THT/module | candidate MPN: approve exact orderable part | Momentary; latched in software
panel | R14 | 10k |  | Resistor_SMD:R_0805_2012Metric | SMD | MPN to select: verify value / rating / package
panel | D5 | LED green | LTST-C190KGKT | LED_SMD:LED_0603_1608Metric | SMD | candidate MPN: approve exact orderable part
panel | R15 | 1k |  | Resistor_SMD:R_0805_2012Metric | SMD | MPN to select: verify value / rating / package
panel | SW6 | OSC6 | Omron B3F-1000 | Button_Switch_THT:SW_PUSH_6mm | THT/module | candidate MPN: approve exact orderable part | Momentary; latched in software
panel | R16 | 10k |  | Resistor_SMD:R_0805_2012Metric | SMD | MPN to select: verify value / rating / package
panel | D6 | LED green | LTST-C190KGKT | LED_SMD:LED_0603_1608Metric | SMD | candidate MPN: approve exact orderable part
panel | R17 | 1k |  | Resistor_SMD:R_0805_2012Metric | SMD | MPN to select: verify value / rating / package
panel | SW7 | MODE | Omron B3F-1000 | Button_Switch_THT:SW_PUSH_6mm | THT/module | candidate MPN: approve exact orderable part | Momentary; latched in software
panel | R18 | 10k |  | Resistor_SMD:R_0805_2012Metric | SMD | MPN to select: verify value / rating / package
panel | SW8 | SLOT | Omron B3F-1000 | Button_Switch_THT:SW_PUSH_6mm | THT/module | candidate MPN: approve exact orderable part | Momentary; latched in software
panel | R19 | 10k |  | Resistor_SMD:R_0805_2012Metric | SMD | MPN to select: verify value / rating / package
panel | ENC1 | EC11E1534408 | ALPS EC11E1534408 | Rotary_Encoder:RotaryEncoder_Alps_EC11E_Vertical_H20mm | THT/module | candidate MPN: approve exact orderable part
panel | R20 | 10k |  | Resistor_SMD:R_0805_2012Metric | SMD | MPN to select: verify value / rating / package
panel | C7 | 10n 16V X7R |  | Capacitor_SMD:C_0805_2012Metric | SMD | MPN to select: verify value / rating / package
panel | R21 | 10k |  | Resistor_SMD:R_0805_2012Metric | SMD | MPN to select: verify value / rating / package
panel | C8 | 10n 16V X7R |  | Capacitor_SMD:C_0805_2012Metric | SMD | MPN to select: verify value / rating / package
panel | ENC2 | EC11E1534408 | ALPS EC11E1534408 | Rotary_Encoder:RotaryEncoder_Alps_EC11E_Vertical_H20mm | THT/module | candidate MPN: approve exact orderable part
panel | R22 | 10k |  | Resistor_SMD:R_0805_2012Metric | SMD | MPN to select: verify value / rating / package
panel | C9 | 10n 16V X7R |  | Capacitor_SMD:C_0805_2012Metric | SMD | MPN to select: verify value / rating / package
panel | R23 | 10k |  | Resistor_SMD:R_0805_2012Metric | SMD | MPN to select: verify value / rating / package
panel | C10 | 10n 16V X7R |  | Capacitor_SMD:C_0805_2012Metric | SMD | MPN to select: verify value / rating / package
panel | J2 | TFT_SPI_3V3 |  | Connector_PinHeader_2.54mm:PinHeader_1x08_P2.54mm_Vertical | THT/module | MPN to select: verify value / rating / package | Harness: Waveshare 2.4inch LCD Module: VCC GND DIN CLK CS DC RST BL. Confirm ordered revision before assembly.
panel | U5 | SN74LVC1G125DBVR | SN74LVC1G125DBVR | Package_TO_SOT_SMD:SOT-23-5 | SMD | candidate MPN: approve exact orderable part
panel | R24 | 100k |  | Resistor_SMD:R_0805_2012Metric | SMD | MPN to select: verify value / rating / package
panel | C11 | 100n 16V X7R |  | Capacitor_SMD:C_0805_2012Metric | SMD | MPN to select: verify value / rating / package
panel | J3 | CV1 | WQP-PJ398SM | Connector_Audio:Jack_3.5mm_QingPu_WQP-PJ398SM_Vertical_CircularHoles | THT/module | candidate MPN: approve exact orderable part | Verify physical sleeve/tip orientation. Normalling contact tied to GND makes unplugged CV 0 V.
panel | J4 | CV2 | WQP-PJ398SM | Connector_Audio:Jack_3.5mm_QingPu_WQP-PJ398SM_Vertical_CircularHoles | THT/module | candidate MPN: approve exact orderable part | Verify physical sleeve/tip orientation. Normalling contact tied to GND makes unplugged CV 0 V.
