Guadonna/VideoSynth/docs/r1/validation.md

# Проверки R1 и границы доказательств

Результаты получены 23.10.2026 на сохранённых исходниках. Отчёты доступны в [hardware/verification](../../hardware/verification/). Физических плат в этой сессии не было.

| Проверка | Результат | Что подтверждает |
|---|---|---|
| ERC core / panel | 0 ошибок, 0 предупреждений | Проверяемые электрические правила KiCad при заданных типах выводов |
| DRC core / panel | 0 нарушений, 0 незавершённых соединений | Геометрию меди/отверстий и связность по правилам проекта; исключения не добавлялись |
| XML схемы ↔ manifest ↔ PCB | PASS, 678 уникальных пар reference/pad | Все заданные nets и NC совпадают; 184 электрических компонента |
| C / WASM / model / raster / запуск | 32 теста PASS | Логика, кольцевая AM, произведение OSC, цифровой растр и восстановление запуска DSP |
| Chromium UI | 13 сценариев PASS, 0 page errors | Управление, проверку AM/микса по аналитическим значениям пикселей, загрузку/экспорт, лимит, адаптивность и standalone |
| Chromium: совместимость DSP, повтор на 0.6.2 | 7 сценариев PASS, 0 page errors | Блокировка Worker, отсутствие API, timeout, оба canvas, ошибки WASM, автономный HTML в документе с opaque origin |
| Встроенная самопроверка | 10 PASS | Отдельные проверки логики, включая инверсию AM, нулевую несущую и произведение |
| SPICE powered-on CV | 201 DC + 201 AC точка | Линейную передаточную функцию идеализированного входа |
| Физический ESP32-P4 / CV / видео / питание | **НЕ ПРОВЕРЕНО** | Нет соответствующих экспериментальных данных |

ERC не доказывает правильность выбранного корпуса или datasheet pinout: часть выводов пассивна, а power flags являются явными допущениями о внешних источниках. Поэтому добавлена независимая сверка всех площадок и отдельные проверки Eurorack, module power и межплатного шлейфа. Эта сверка тоже не заменяет физическое ревью модуля и компонентов.

Автотесты проверяют максимальные 36 связей и отказ 37-й, неизменность матрицы при выключении OSC из микса, циклы и самомодуляцию, X/Y-зависимость, чётные/нечётные строки, чёрный кадр с синхронизацией, защиту загрузки пресета, 900900 отсчётов и полупериоды 480i. Браузерный тест проверяет standalone с блокированием всех запросов после HTML; внешних ресурсов не требуется. Сам браузер хоста запрещает прямую навигацию `file://`, поэтому этот путь не объявлен непосредственно испытанным здесь.

В 0.6.2 добавлены аналитические проверки `x²`, `−x²`, произведения шести синусоид, отключения факторов, AM с +10/0/−10 В, независимого невидимого OSC-модулятора, задержки на один активный пиксель в обоих полях, суммирования нескольких AM-источников и нулевого состояния замкнутой AM-цепи. Допуск сравнения с аналитической синусоидой — 1 LSB яркости с учётом LUT и 12-битного CV. Через UI проверяются реальные пиксели canvas после изменения кнопок, слота и CV, а не только внутреннее состояние JavaScript.

## Численные результаты

SPICE: максимальное расхождение DC с номинальной формулой **3,05 мкВ** (это точность идеальной модели, не точность реального устройства); на ±10 В получены **2,72206 / 0,42980 В** у АЦП; на 100 Гц **−0,8462 дБ относительно DC**. Нет моделей перегрузки ОУ, диодов, TMUX power-off, ESD, импульсного buck и паразитик видеотракта.

Нативный C-бенчмарк 0.6.2 на данном x86_64 хосте, GCC 14.2, `-O3`: **79,12 мс/кадр в среднем за 20 кадров** при отдельном повторе после остальных тестов. Сценарий соответствует обновлённому пресету «36 связей»: шесть square OSC в произведении, V3 без входящих AM, но с FM/PM. Контрольная сумма кадра — 2284877339. Это медленнее бюджета 33,37 мс даже на этом хосте. Прежние 41,78 мс относились к другому алгоритму и патчу; прямого сравнения скорости версий из этих чисел сделать нельзя. Сценарий не является полным worst-case по morph/UI/CV; результат может меняться при повторе из-за нагрузки хоста. **Утверждать, что этот эталонный алгоритм уже работает в real-time на P4, оснований нет.** Нужны оптимизация и аппаратное измерение; возможен пересмотр архитектуры.

Расчёт загрузки: 10,358 млн пикселей/с; 62,146 млн вычислений OSC/с; до 372,875 млн накоплений модуляции/с. Это объясняет, почему прошивка является самостоятельным следующим этапом, а не автоматической компиляцией эмулятора.

## Как повторить

Приложение использует включённый WASM; для запуска нужен только Node.js 20+ или автономный HTML. Для полного цикла нужны KiCad 9 с pcbnew, C-компилятор, Chromium, libngspice, Python 3, Node.js и wasi-sdk 25.

```sh
bash scripts/setup-cloud.sh
npm run build
npm test
bash scripts/verify-hardware.sh
python3 scripts/draw_panel.py
```

В отдельном терминале запустить `npm start`, затем:

```sh
npm run test:browser
python3 scripts/verification_asset.py
node scripts/bundle.mjs
```

`setup-cloud.sh` проверяет зависимости базового образа и устанавливает npm/wasi-sdk без root. Он не устанавливает системный KiCad/Chromium/libngspice на произвольной ОС: они уже присутствуют в выбранном облачном образе. Для другого Linux установите их пакетным менеджером своей системы. `CHROMIUM` и `WASI_CC` позволяют задать пути. В облаке HOME доступен только для чтения; KiCad использует XDG-каталоги внутри `/workspace`.

Готовые PCB открываются без генератора и autorouter. **Не запускать `build_kicad.py` без `--schematics-only` на рабочей разводке:** это намеренно создаёт исходные платы заново и удаляет трассировку. Изменение single-source design.py также требует последующего согласованного изменения PCB, повторного ERC/DRC и сверки; скрипт не выполняет магический ECO.

## Что было заблокировано и как решено

- Системная установка пакетов без root недоступна. Использованы уже установленные KiCad/Chromium, shared libngspice и локальный wasi-sdk; текущие проверки выполнены, ожидания разрешения на установку нет.
- Запись настроек KiCad в read-only HOME заменена штатными XDG-путями в `/workspace`.
- Прямая `file://`-навигация Chromium запрещена политикой браузера. Проверка автономного HTML выполнена с полной блокировкой вторичных сетевых запросов.
- Datasheet Bourns дросселя возвращал HTTP 403. Isat/дерейтинг остаются незакрытым пунктом BOM, не подменены предположением.
- Заводская комплектация всех конкретных SMD, коммерческая PCBA-котировка и DFM ещё не получены; производство не заказывалось.
- Настройка среды сохраняется отдельным черновиком. Сохранение черновика само по себе не публикует образ и не подтверждает восстановление новой машины.

Ни один провал CAD-проверки не скрыт исключением: локальные airwires/зазоры исправлены, окончательные отчёты чистые.
