Guadonna/VideoSynth/docs/r1/bringup.md

# План сборки и физических испытаний R1

Изготовление не заказано. До передачи файлов заводу выполнить ревью схемы/корпусов и квалификацию компонентов. Все пункты ниже пока являются планом, а не отчётом измерений.

## 1. До PCB: модуль, видео и вычисления

1. Проверить фактическую ревизию Olimex, ESP32-P4 и доступные GPIO. Сначала на модуле написать минимальную прошивку PARLIO/GDMA, выдающую повторяющийся растр 27 MSPS от внешнего clock. Проверить паузы на стыках DMA-дескрипторов, PSRAM/cache, reset и SLEEP ЦАП. Длительный тест не должен иметь пропусков строк/полей.
2. Измерить время DSP в 720×480: 0/18/36 связей; межосевые циклы; максимальная частота/morph; два CV 100 Гц; обновление TFT и опрос органов управления одновременно. Логировать worst-case, не только среднее, минимум 30 минут. Цель для рабочего кадра — ≤33,3667 мс с запасом; рекомендуемый инженерный gate ≤26 мс для DSP+подготовки, без underrun.
3. Если gate не пройден, профилировать и измерить оптимизированное ядро. При сохраняющемся провале остановить выпуск R1 и выбрать другую вычислительную архитектуру; перенос синхронизации на RP2350 не решает недостаток DSP.

## 2. Проверка до включения собранных плат

- Сверить каждый MPN, напряжение/ёмкость под DC bias, Isat дросселя, реальные pin 1 и ориентации IC/диодов/LED. У BOM есть незаполненные MPN пассивов и кандидаты механики; это открытые пункты закупки.
- Сверить Ext1/Ext2 с Rev.D1 и подключение 5VP. Удалить **FET2** на модуле только после проверки обозначения. Проверить, что EXT2 +5 В не соединён на carrier. Не перепутать POE_PWR1 с PoE PW+/PW−.
- Проверить отсутствие замыканий на +12/5/3,3 В; целостность земляных контактов; полярность Eurorack. −12 В никуда не должно питать узлы R1.
- Проверить шлейф core J5 ↔ panel J1: pin-to-pin, без зеркального переворота. Сверить TS tip/sleeve/normal с реальным разъёмом. Не подключать неизвестный TFT по одному совпадению количества контактов.
- Примерить панель, 24 ручки/колпачка, высоты кнопок/энкодеров/CV, окно и плату TFT, RCA, доступ к сервисному USB. Чертёж панели предварительный. Разработать/проверить крепёж core к panel: набор отверстий сам по себе не задаёт совместимый кронштейн.

## 3. Питание

Первое включение от лабораторного +12 В с ограничением тока, без дорогого видеоприёмника. Проверить 5 В сначала без модуля, потом с электронной нагрузкой до выбранного максимума; затем модуль и панель. Записать запуск, ток, пульсации, переходные процессы, dropout на модуле, нагрев после 60 минут и запас F1 при температуре.

Отдельно проверить rack on/USB off, rack on/USB on, rack off/USB on. Последний режим не должен запускать устройство или поднимать рабочие шины. Проверить сервисное программирование/boot/reset при питании от стойки. Испытание переполюсовки начинать на ограниченном лабораторном источнике, а не на установленной стойке.

## 4. Видео

Нагрузить выход **одними 75 Ом**, осциллограф использовать с корректной 75-омной оконечкой или внешним резистором и высокоомным входом. Проверить full-scale, sync, black, white, DC-смещение, фронты, overshoot и спектр шума. Цели номинально: 0,999 В sync→white, 0,286 В sync→black, H=63,5556 мкс, поля 16,6833 мс.

Логическим анализатором/осциллографом проверить D0…D7 и setup/hold относительно DAC_CLK, включая reset/SLEEP. Сравнить белый/чёрный, лестницу яркости, сетку, single-pixel чередование, 36-связный stress. Проверить захват минимум двумя разными приёмниками и длительное удержание синхронизации, оба поля, положение изображения и реальную полосу.

## 5. CV и управление

Двухточечно калибровать каждый CV и проверить −10/0/+10 В. Снять DC и АЧХ 1…100 Гц; сравнить с 0,846 дБ на 100 Гц, оценить шум, погрешность АЦП, установление после mux и проникновение SPI/TFT в видео.

Защиту ±15 В проверять отдельно на ограниченном источнике с измерением токов и всех шин: +15/−15 В, по одному и двум каналам, питание on/off, включение/выключение под CV, горячее подключение. Начать с небольшого тока и короткой выдержки, затем увеличивать в рамках datasheet всех затронутых компонентов. Проверить отсутствие latch-up, обратного питания, повреждения и остаточного смещения. ESD — отдельный стенд и методика; SPICE с идеальным ОУ не сертифицирует ESD.

Для 24 ручек проверить монотонность/концы диапазона/скорость обновления; для энкодеров — быстрые шаги и направление; для кнопок — дребезг и однократное переключение. Проверить невидимый OSC, лимит 36, попытку включить 37-й, MODE/SLOT, сохранение настроек и восстановление после reset.

## Условия следующего выпуска

Закрыты timing/DSP gates, питание и CV испытаны, корректный сигнал принят реальными устройствами, утверждены точные компоненты и механика, выполнено независимое ревью PCB и заводской DFM/BOM/CPL. Лишь после этого имеет смысл подготовить производственный выпуск и отдельно согласовать отправку на изготовление.
