Guadonna/VideoSynth/docs/research-v0.4/verification-update.md

# Дополнительная проверка источников и исправления

Дата проверки: 23.10.2026 UTC. Это дополнение к исследованию ТЗ v0.4, а не новая версия самого ТЗ. Исходное задание не изменено. Электрическая схема и PCB не создавались; заказы, резервирование компонентов и обращения к поставщикам не выполнялись.

## Что удалось закрыть

Прежний сетевой запрет снят. Прочитаны прямые документы Raspberry Pi, Espressif, TI, Analog Devices, Microchip, NXP, ST, ITU и USB-IF; проверены публичные каталог и условия PCBA JLCPCB. В `source-register.csv` сохранена история прежних неудач и добавлены успешные загрузки с SHA-256. История `403` больше не является текущей причиной незавершённости.

Снимок каталога находится в `catalog-snapshot-2026-10-23.json`, выбранные позиции — в `catalog-availability.csv`. Пустая HTML-оболочка поиска не считалась отсутствием товара: выполнены запросы публичного поиска, включая отдельный раздел закупки `buy`. Ответы этого поиска не являются заказом или резервом. Документы производителей не перепубликуются в репозитории; приведены оригинальные ссылки и контрольные суммы.

## Исправления, влияющие на архитектуру

| Узел | Подтверждение | Следствие |
|---|---|---|
| PAL | ITU-R BT.470-7 отсылает к BT.1700; в официальном ZIP прочитан именно `1700-e.pdf`, Part B, tables 1–3, figures 1–5 | Базовые 625/50, 64 мкс подтверждены; уточнены допуски и чересстрочная последовательность |
| Временная точность | BT.1700 table 1: 15 625 Гц ±0,00002% для **цветного** 625 PAL | Это ±0,2 ppm. Делитель PLL обеспечивает точное отношение частот, но не такую абсолютную точность обычного кварца. Для монохромной совместимости и строгого соответствия студийному PAL нужны разные явно названные критерии |
| ADV7125 | Rev D, pin descriptions p.9: `SYNC` управляет током только IOG; `BLANK` действует на все три выхода и защёлкивается CLOCK | Три DAC не дают три готовых CVBS. Для одинакового sync на A/B/C нужен общий внешний тракт/маска или кодирование sync во всех трёх потоках. Прерывание CLOCK тоже должно быть исключено; GPIO-бюджет уточнён до 46/48 с отдельным DAC CLOCK |
| THS7314 | SLOS513B, электрические характеристики и раздел фильтра: −3 дБ при 8,5 МГц, gain 2, внутреннее DC-смещение примерно 0,29 В на выходе | При DAC 13,5 MSPS и тоне 5 МГц первый образ попадает на 8,5 МГц: один этот фильтр подавит его лишь примерно на 3 дБ. Необходимо пересмотреть фильтр/полосу/интерполяцию |
| ADG7421F | Rev 0, table 11 p.26: для single 3 V допустимый аналоговый диапазон VSS+0,1…VDD−0,25 В | Прямые уровни GPIO 0/3,3 В не гарантированы. Нужны смещённые уровни и отдельные драйверы/компараторы; 22 dual IC дают 44 защищённых канала |
| ADG7421F off-state | Source S защищён до ±60 В при питании и без него; GND обязателен. Drain leakage при заземлённых rails нормируется, при плавающих rails приводится другой типовой результат | Внешний контакт подключается к защищаемой стороне S. Нужны определённое состояние rails при выключении, ограничение быстрых импульсов и проверка отсутствия back-power; число «±60 В» само по себе не квалифицирует весь порт |
| TMUX7462F | SCDS394B, recommended conditions: VDD−VSS ≥8 В; single supply 8–44 В; VFP/VFN задают пороги | Реальная альтернативная quad-защита, но USB 5 В требует вспомогательного boost. Это не drop-in для 3,3/5 В |
| MCP23S17 | DS20001952C p.4: GPIO VIH≥0,8VDD, VIL≤0,2VDD, утечка до ±1 мкА | При 44 контактах, R=4,7 кОм, Rp=1 МОм идеальный HIGH 2,735 В даёт всего 95 мВ до VIH=2,64 В. Прямое высокоомное считывание не квалифицировано; повышен резерв IO с 3 до 6 экспандеров для отдельных драйверов и приёмников |
| ADS8684 | SBAS582C pp.7,9: полоса −3 дБ 15 кГц, −0,1 дБ 2,5 кГц; защита ±20 В требует AVDD=5 В либо сопротивления rail <30 кОм, при плавающем AVDD лишь ±11 В | Снят с роли основного ADC для CV до 20 кГц. Допустим как вариант для более медленного CV. Выдерживание ±15 В при плавающем питании не подтверждено |
| Новый кандидат CV | ADS8866, SBAS614C: 16 bit, 100 kSPS, AVDD 2,7–3,6 В, VREF 2,5–5 В, вход 0…VREF | По одному ADC на CV; общий CONVST позволяет синхронизировать выборку, данные читаются раздельно/цепочкой. Требуются внешний масштабатор ±10 В, смещение, буфер, reference, anti-alias и защита; это ещё не готовый CV-тракт |
| Шина 3,3 В | TI SLVSAG7 family comparison p.3: TPS62132=3,3 В, TPS62133=5 В, TPS62130 adjustable | TPS62133 исключён. Из-за нулевого остатка TPS62132 основной закупочный кандидат — TPS62130RGTR с настройкой на 3,3 В |
| ESP32-P4 | Официальный **pre-release v0.7**, tables 2-12/13, 5-2: HP supply 0,99–1,3 В, nominal 1,1 В; PSRAM 1,65–1,95 В; external DC/DC EN/FB | В бюджет добавлено питание ядра. Нельзя запитать весь P4 одной шиной 3,3 В. План внутренних LDO/внешних rails, sequencing и токовый запас требуют проверки на devkit; 0,5 А в таблице — требование к источнику, не измеренное потребление всего прибора |
| MCU revision | P4 v0.7 перечисляет NRW16X/NRW32X, v3.x, 400 МГц, 16/32 MB PSRAM, bus16 DDR до250 МГц. Каталог RP2350B указывает A4 | Фиксировать полный MPN и проверять silicon revision при получении. Datasheet P4 имеет статус pre-release; SDK и errata должны быть зафиксированы вместе с прошивкой |
| USB-C | USB Type-C R2.5 March2026, §2.3.3/table2-1 и §4.6; TUSB320LAI datasheet | 5 В 1,5/3 А доступны без PD при соответствующем объявлении CC. Default current не равен 1,5 А. При недостаточном источнике нужно ограничение функций/пуска; Rd и CC-контроллер не дублировать без предусмотренной схемы |
| Power mux | TPS2121 datasheet: 2,8–22 В, reverse-current blocking; TPS54302: 4,5–28 В input | Два регулируемых пути 5 В можно объединить через mux. Защита от обратного тока не заменяет защиту Eurorack от −12 В при перевёрнутом кабеле |

### Численная проверка сканирования без выбора схемы

Для исследовательского варианта ADG7421F предлагаются функциональные уровни: idle bias 0,3 В, активный drive 2,7 В, comparator threshold 0,9 В. При R=47 кОм, Rp=2,2 МОм и 44 объединённых контактах:

`Vhigh = 0,3 + (2,7−0,3) × 2,2M / (2,2M + 44×47k) = 1,537 В`.

Идеальный запас HIGH — 0,637 В, LOW — 0,6 В. Это показывает перспективность смещённого компараторного считывания, но **не является worst-case доказательством**. Нужны допуски bias/threshold, токи всех драйверов в high-Z, утечки switch/TVS, offset/bias компараторов, загрязнение и температура. TLV1704 имеет input bias до 20 нА в указанном диапазоне температур; это кандидат за fault-switch, а не самостоятельная защита ±15 В. При выключении и быстрых фронтах нужно квалифицировать весь путь до каждого входа.

Оценка 5RC при 2 нФ и 47 кОм — 470 мкс; 44 точки — 20,68 мс. Для шести MCP23S17 при консервативном бюджете 300 SPI-бит/позицию и 5 МГц добавляется 2,64 мс: около 23,3 мс на скан до программных накладных расходов. Два подтверждения дают порядка 47 мс. Поэтому прежнюю иллюстративную задержку 6,2 мс нельзя переносить на новый вариант. Максимальный размер группы и длины кабелей влияют на цену, ток и задержку одновременно.

### Видеофильтр и синхронизация

Для иллюстративного идеального фильтра Butterworth порядка 5: `A(f)=10 log10(1+(f/8,5MHz)^10)`. Это 3,01 дБ при 8,5 МГц и около 41,3 дБ при 22 МГц. Реальный THS7314 — модифицированный фильтр, поэтому точную характеристику берут из datasheet/измерений, а не из этой модели.

Повышение тактовой частоты DAC до 27 МГц помогает только при настоящей цифровой интерполяции/формировании более частой последовательности. Простое повторение каждого значения дважды оставляет аналоговую ступеньку прежней длительности и не устраняет образ исходного 13,5-MSPS потока. Для 360 отсчётов на активную строку ситуация с собственными образами ещё строже: требуется учитывать реальную частоту смены уровней. Альтернатива — ограничить полезную полосу и выбрать согласованный более узкий фильтр. Резкие края sync нельзя бесконтрольно фильтровать вместе с яркостью: в BT.1700 отдельно нормированы фронты и длительности.

При настоящем 27-MSPS выводе 32-битного слова поток RP2350 составит 108 MB/s, 16 строк потребуют 110592 байта; PIO при 135 МГц имеет делитель 5. Это арифметическая возможность, а не подтверждение DMA-арбитража. Архитектура должна сохранять CLOCK и синхронизацию при голодании pixel FIFO.

## Закупка и заводская сборка

На момент снимка публичного каталога:

| Компонент | JLC код | Остаток | Нужен на прибор | Наблюдаемая цена, USD |
|---|---|---:|---:|---:|
| RP2350B, описание A4 | C42415655 | 3649 | 1 | 1,2822 при 1–9 |
| ESP32-P4NRW32X | C54540373 | 0; `buy` | 1 | 6,2031 при 1–9; срок требует подтверждения |
| ADG7421FBCPZ-RL7 | C3657421 | 7 | 22 | 5,7762 при 1–9; 5,4459 при 100+ |
| TMUX7462FRRPR, альтернатива | C3657147 | 3 | 11 | 5,6585 при 1–9 |
| ADV7125KSTZ140 | C9668 | 252 | 1 | 12,7757 при 1–9 |
| THS7314DR, Texas Instruments | C882751 | 3489 | 1 | 0,6853 при 1–9 |
| ADS8866IDGSR | C455432 | 1541 | 2 | 5,49 при 10–29 |
| MCP23S17-E/SO | C145413 | 1139 | 6 | 1,3509 при 27–99 |
| TPS62132RGTR | C81563 | 0 | 1 | цена не означает наличие |
| TPS62130RGTR, adjustable | C43590 | 25142 | 1 | 1,1285 при 1–9 |

Для пяти приборов требуется 110 ADG7421F, а не 22. Каталожная цена 110 штук даёт `22×5,4459 = 119,81 USD/прибор` только за защитные switch; их нельзя сейчас купить из наблюдаемого остатка 7. Смета оставляет резерв 121–136,40 USD на этот блок и отдельно 20–45 USD на драйверы/приёмники. Для одиннадцати quad TMUX в WQFN публичные ступени цен дают потенциально меньшую стоимость, но нужен boost, другой fault/front-end и пополнение склада. Это отдельный прототипный вариант, не утверждённая замена.

Для C55820335 (P4NRW16X) выдача содержала неправдоподобные 0,0398 USD, нулевой остаток и отсутствие срока. Эта цена сохранена для аудита, но **исключена из расчёта**. Строка THS7314DR-TUDI другого производителя не приравнивалась к TI THS7314DR. Неинтерпретируемый `assemblyComponentFlag=false` в поиске не использован как доказательство ни отказа, ни приёмки PCBA.

Официальные [возможности PCBA](https://jlcpcb.com/capabilities/pcb-assembly-capabilities) подтверждают монтаж QFN/QFP/BGA и минимальный шаг 0,35 мм для Standard, 0,40 мм для Economy. Для корпуса P4 и всех мелких QFN проверить конкретный package drawing; Standard — исходный кандидат сервиса. [FAQ](https://jlcpcb.com/help/article/pcb-assembly-faqs) прямо допускает consigned parts и Global Sourcing. Таким образом, маршрут монтажа всех SMD существует; **полный BOM сейчас не обеспечен складом и не принят сборщиком**. Условия профиля reflow, exposed pad, точные корпус/лента, запас на потери и допустимость дисплея должны войти в будущую проверку BOM/CPL после согласования проектирования. Публичные минимальные тарифы не заменяют котировку конкретного изделия.

## Что осталось и почему

| Остаток работы | Причина | Следующий шаг |
|---|---|---|
| Реальный DSP/FPS, DMA underrun, PSRAM contention | Нет физических devkit и измерений; расчёт частоты не benchmark | Единое ядро на RP2350/P4, сцены 0/18/54/108 OSC-связей, UI/CV/scan одновременно |
| PAL и фильтрация | Не собран аналоговый тракт; bandwidth и критерий совместимости ещё не утверждены | Три 75-омных нагрузки, осциллограф, проверка полей/полосы/изображений на нескольких приёмниках |
| ±15 В on/off | Datasheet квалифицирует IC при конкретных условиях, не всю цепь | Отдельный исследовательский макет защиты, управляемые faults, тест выключенных/плавающих rails и максимальной кабельной группы |
| Точный CV-тракт | Нужно выбрать полосу/плоскостность, усилители, reference и защиту | 2×ADS8866 со стендовым масштабированием, АЧХ/шум/settling/phase/skew |
| Мощность и hot-plug | Нет совместно работающего железа | USB default/1,5/3 А, Eurorack, оба источника; ток/температура/back-feed |
| Полная заводская сборка и конечная цена | P4 под заказ, protection shortage, часть аналоговой обвязки и механики ещё не выбрана | Закупочная проверка и котировка после фиксации технического BOM; без заказа сейчас |
| Разрешение, modulation budget, семантика patch, габариты | Это открытые требования изделия | Зафиксировать дополнение к ТЗ перед схемой; текущая работа не подменяет согласование |

Дополнительные разрешения облачной среды больше не нужны. Переход к электрической схеме/PCB остаётся за отдельным согласованием пользователя. Физические испытания и закупочная котировка не объявлены выполненными.
