Guadonna/VideoSynth/hardware/kicad/core/core-schematic.pdf

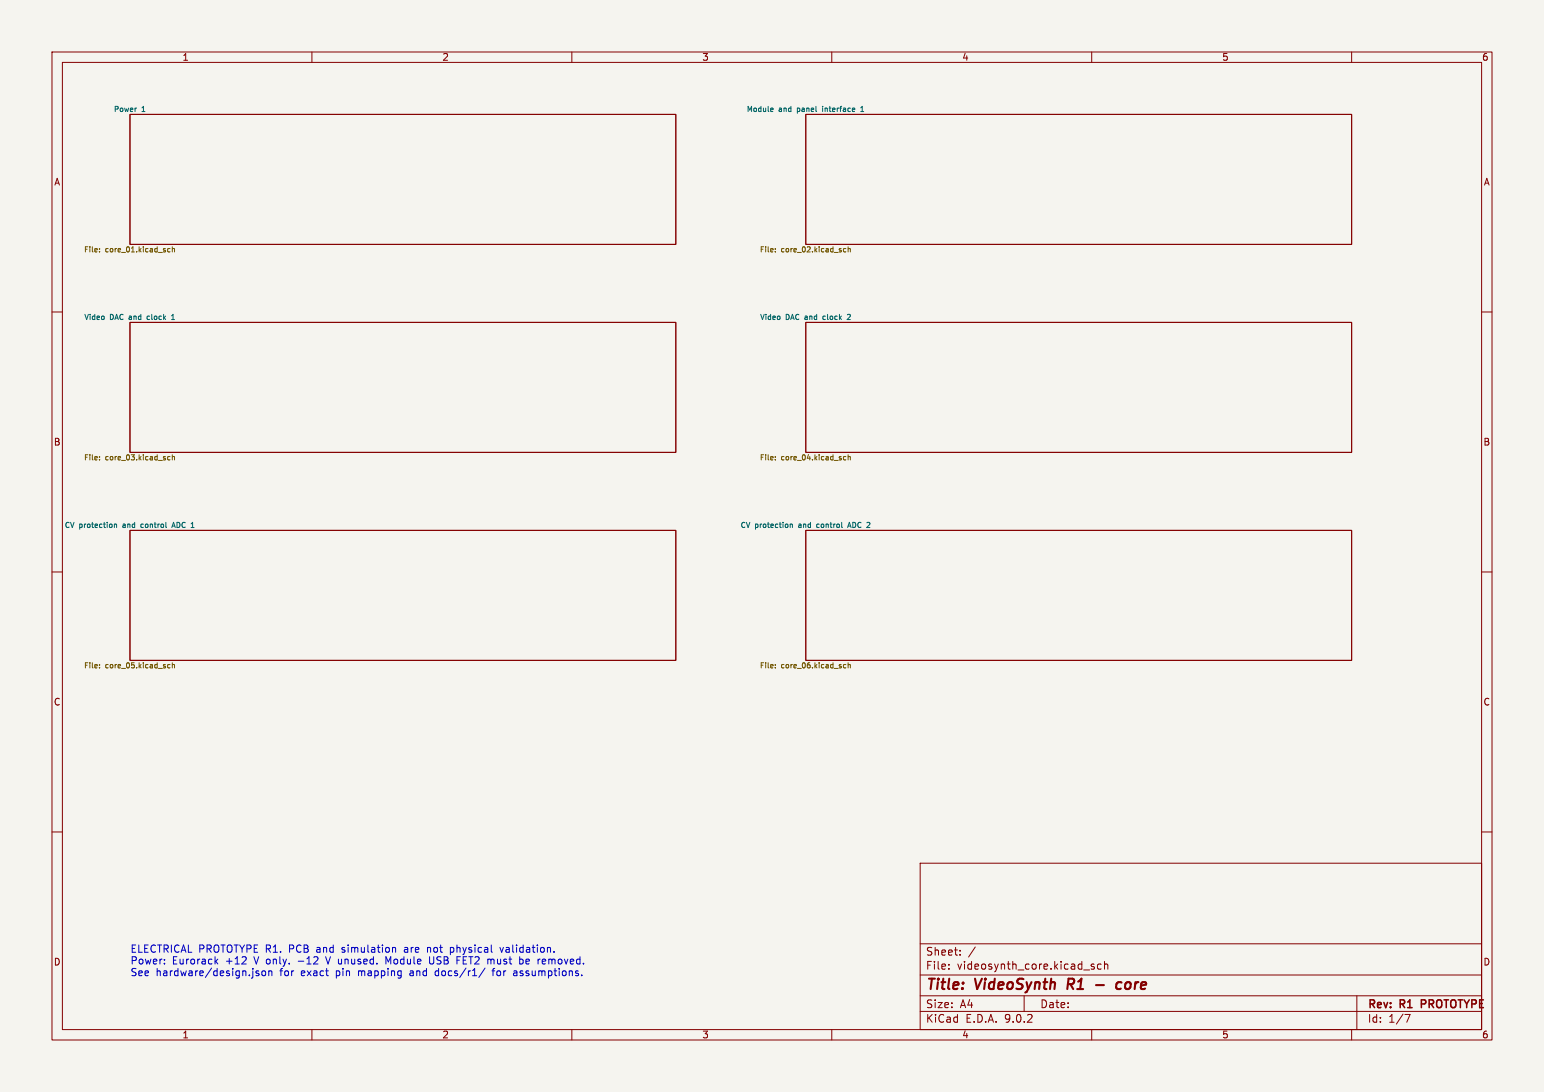
[picture p8: page 1]

File: videosynth_core.kicad_sch Sheet: /
Id: 1/7 Title: VideoSynth R1 - core

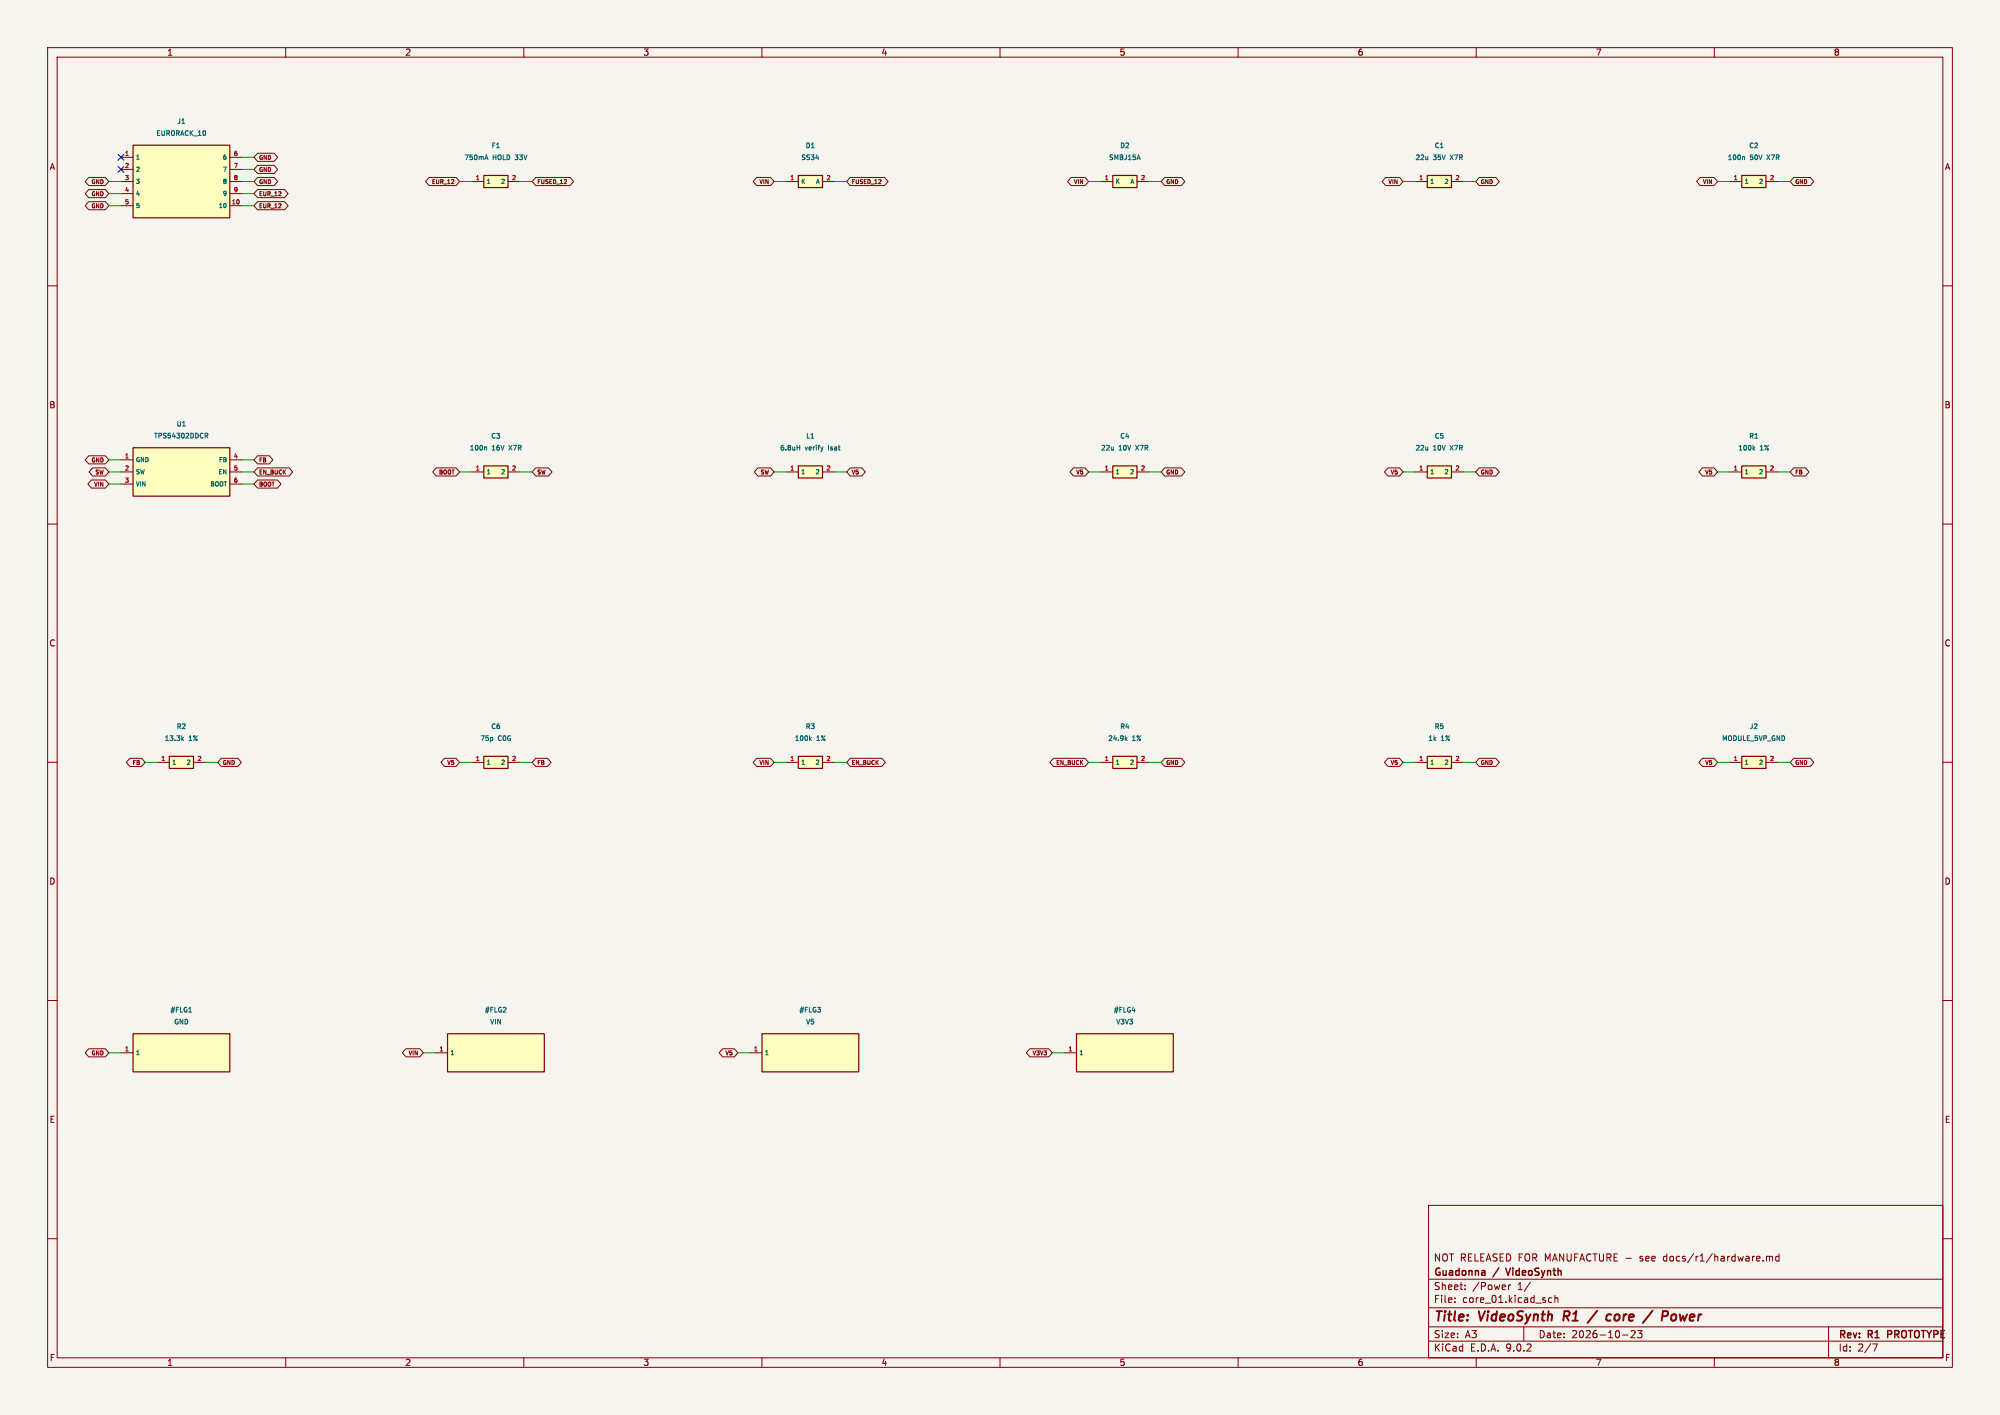
[picture p9: page 2]

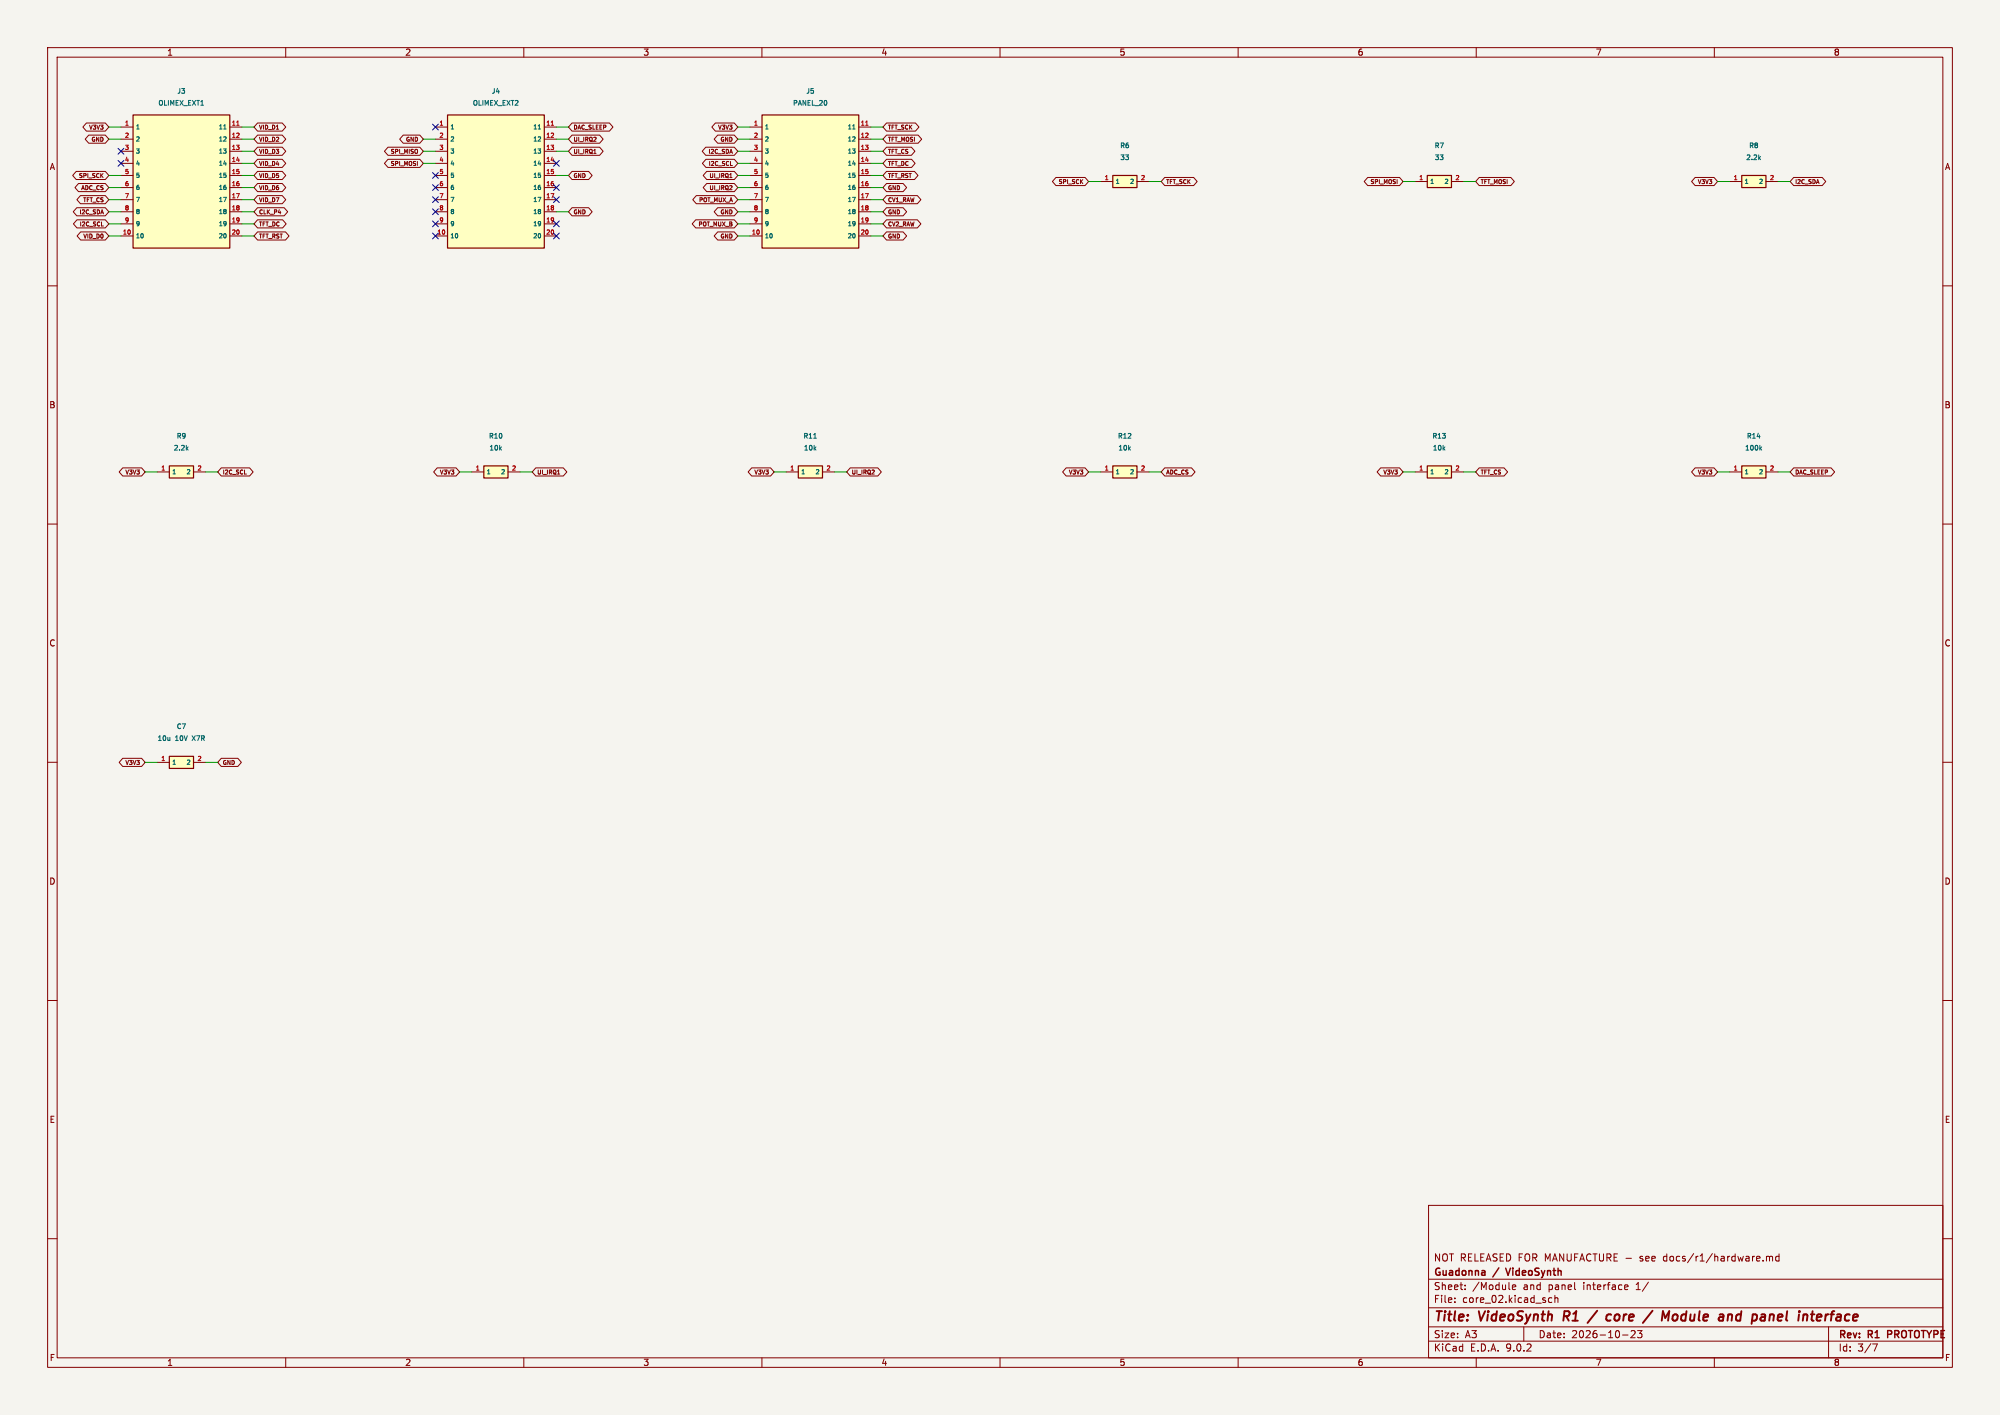
[picture p10: page 3]

Id: 3/7 Title: VideoSynth R1 / core / Module and panel interface

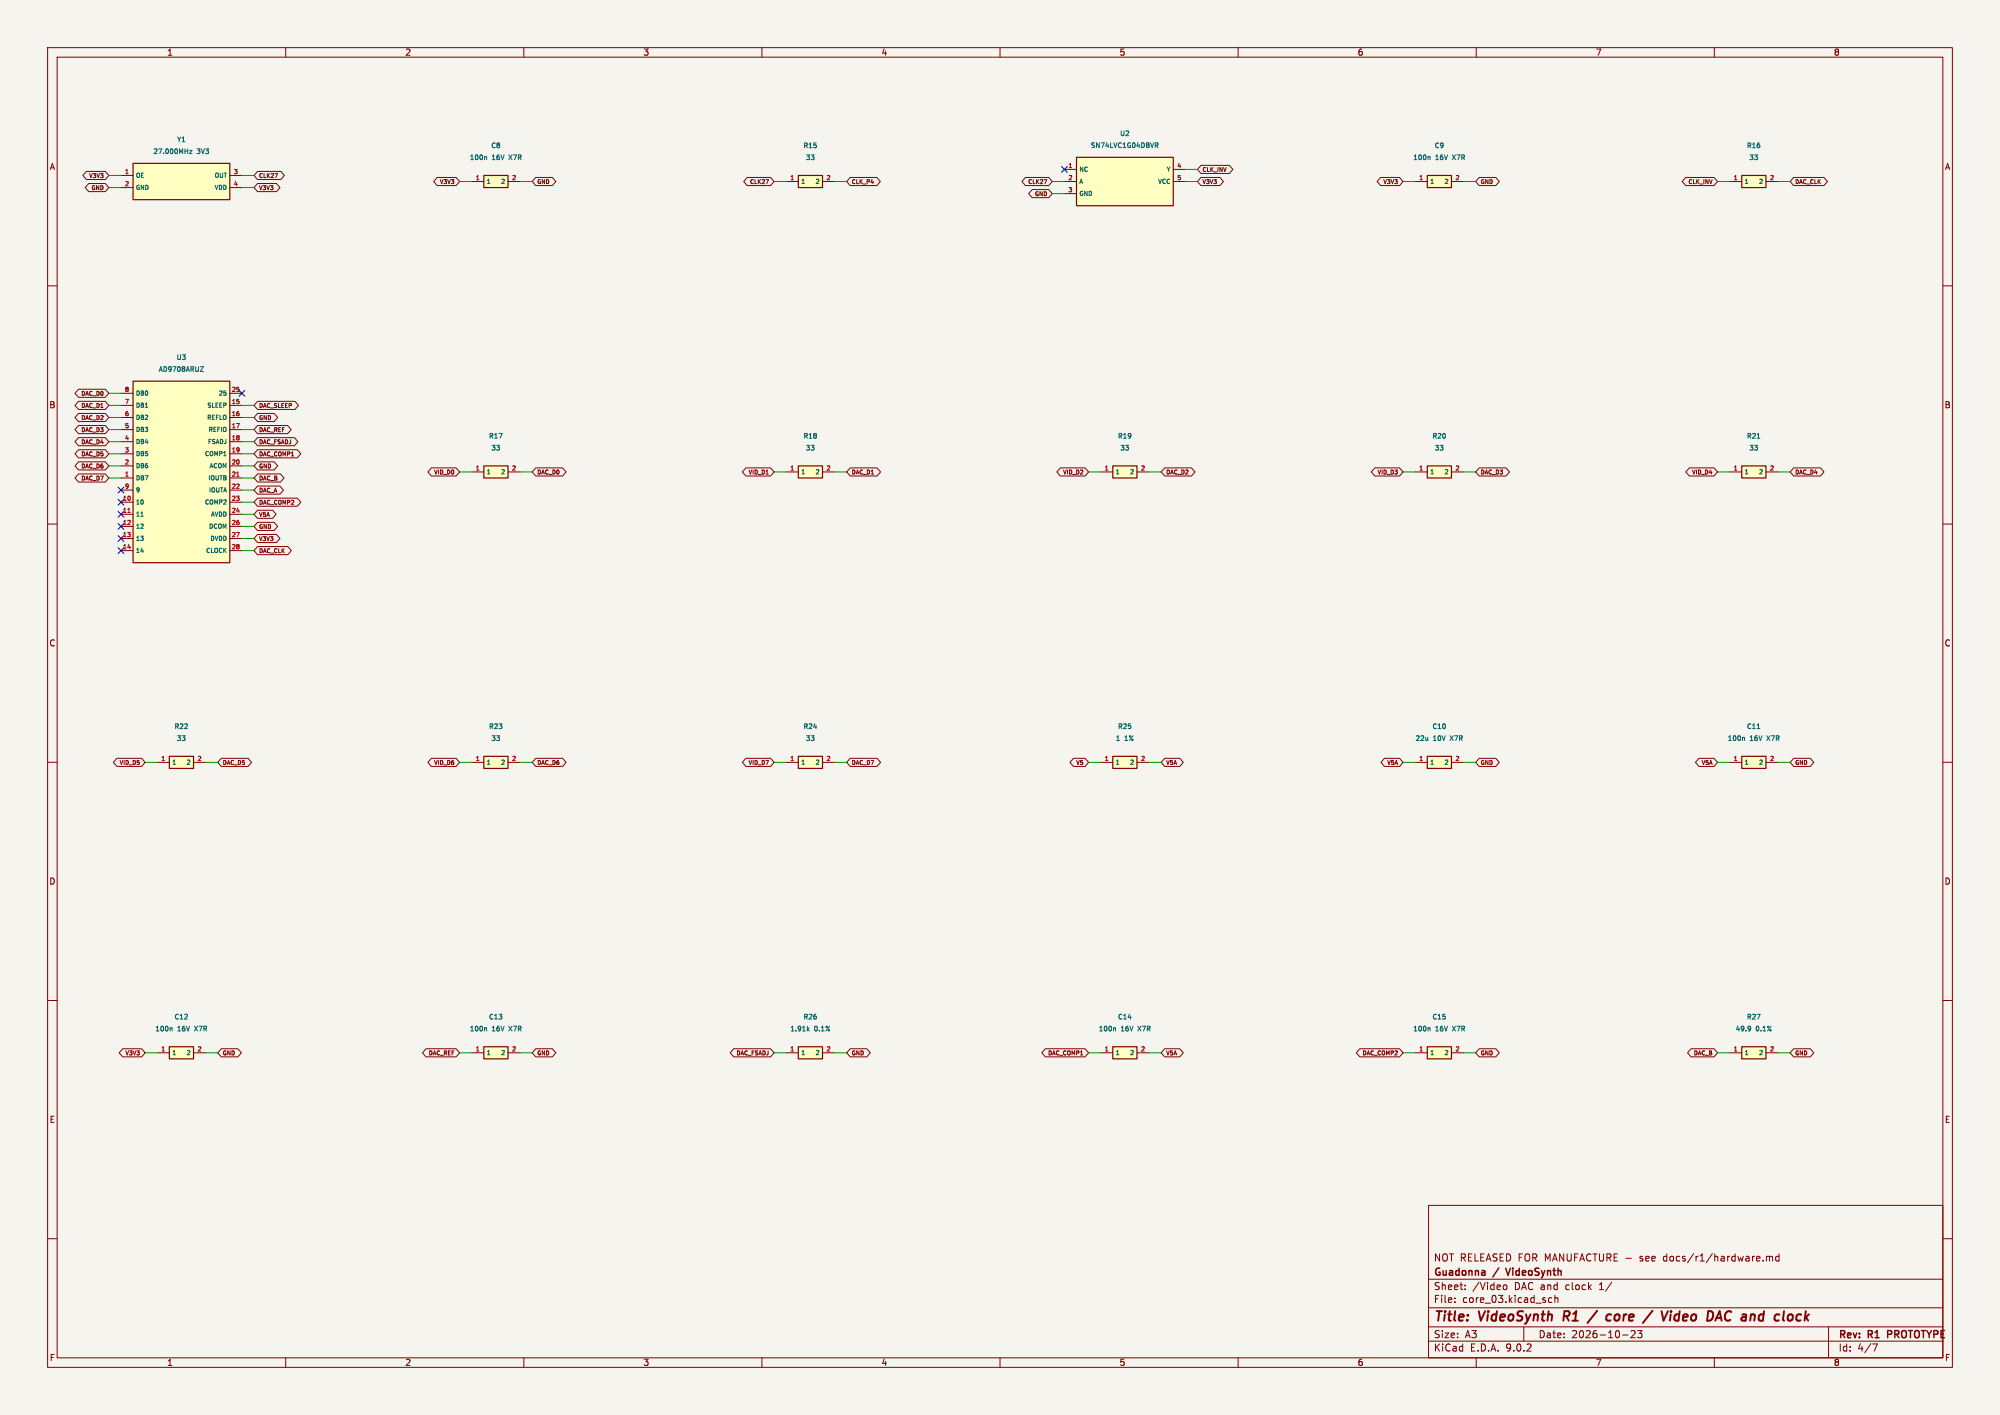
[picture p11: page 4]

Id: 4/7 Title: VideoSynth R1 / core / Video DAC and clock

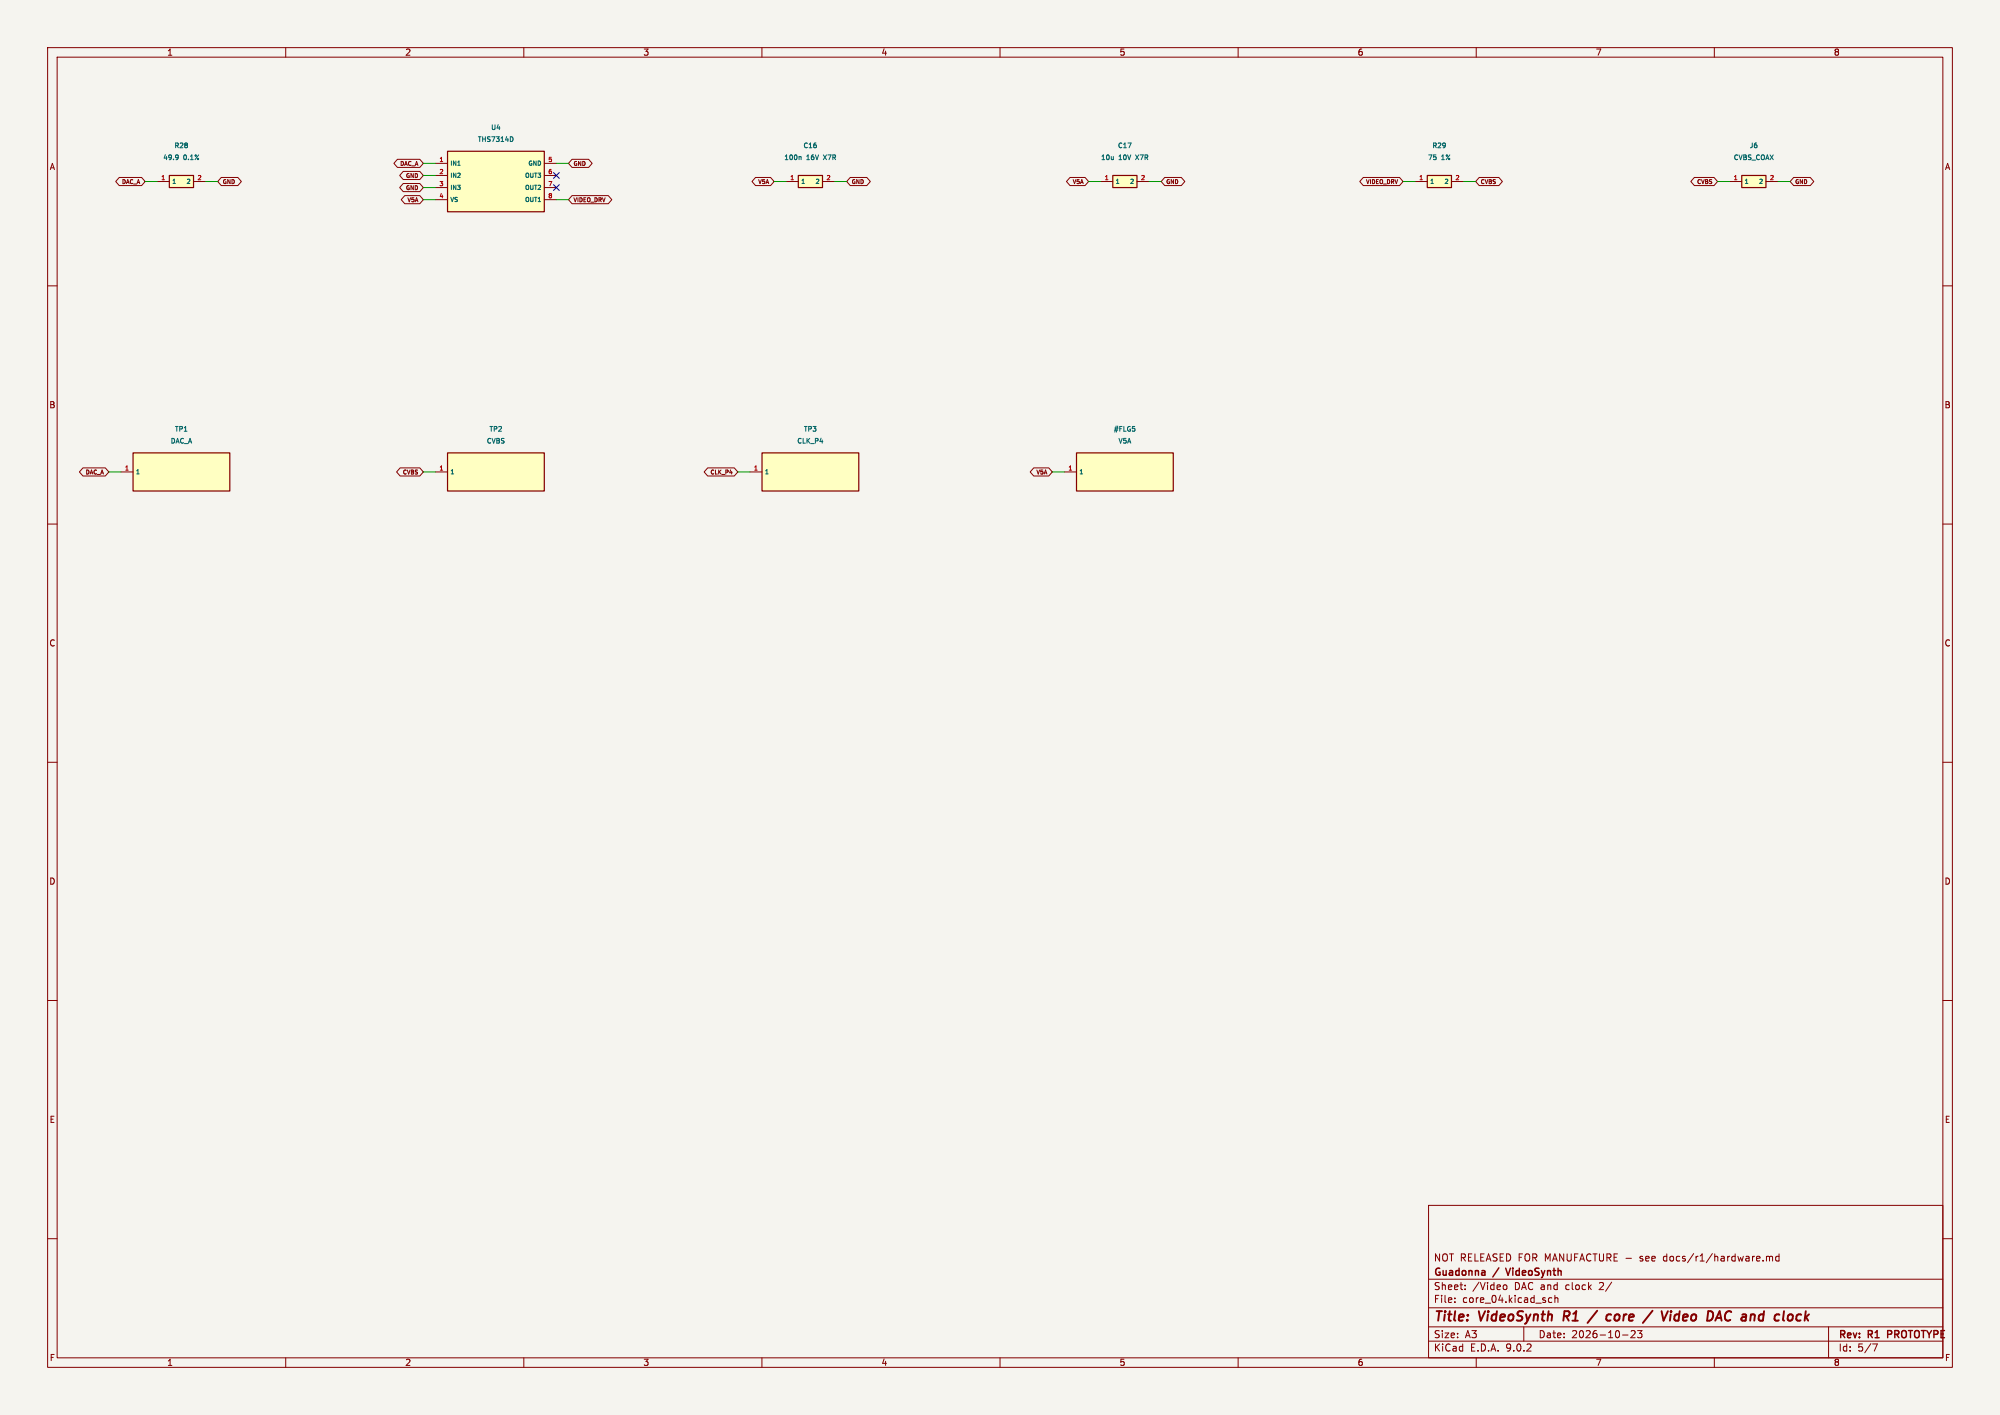
[picture p12: page 5]

Id: 5/7 Title: VideoSynth R1 / core / Video DAC and clock

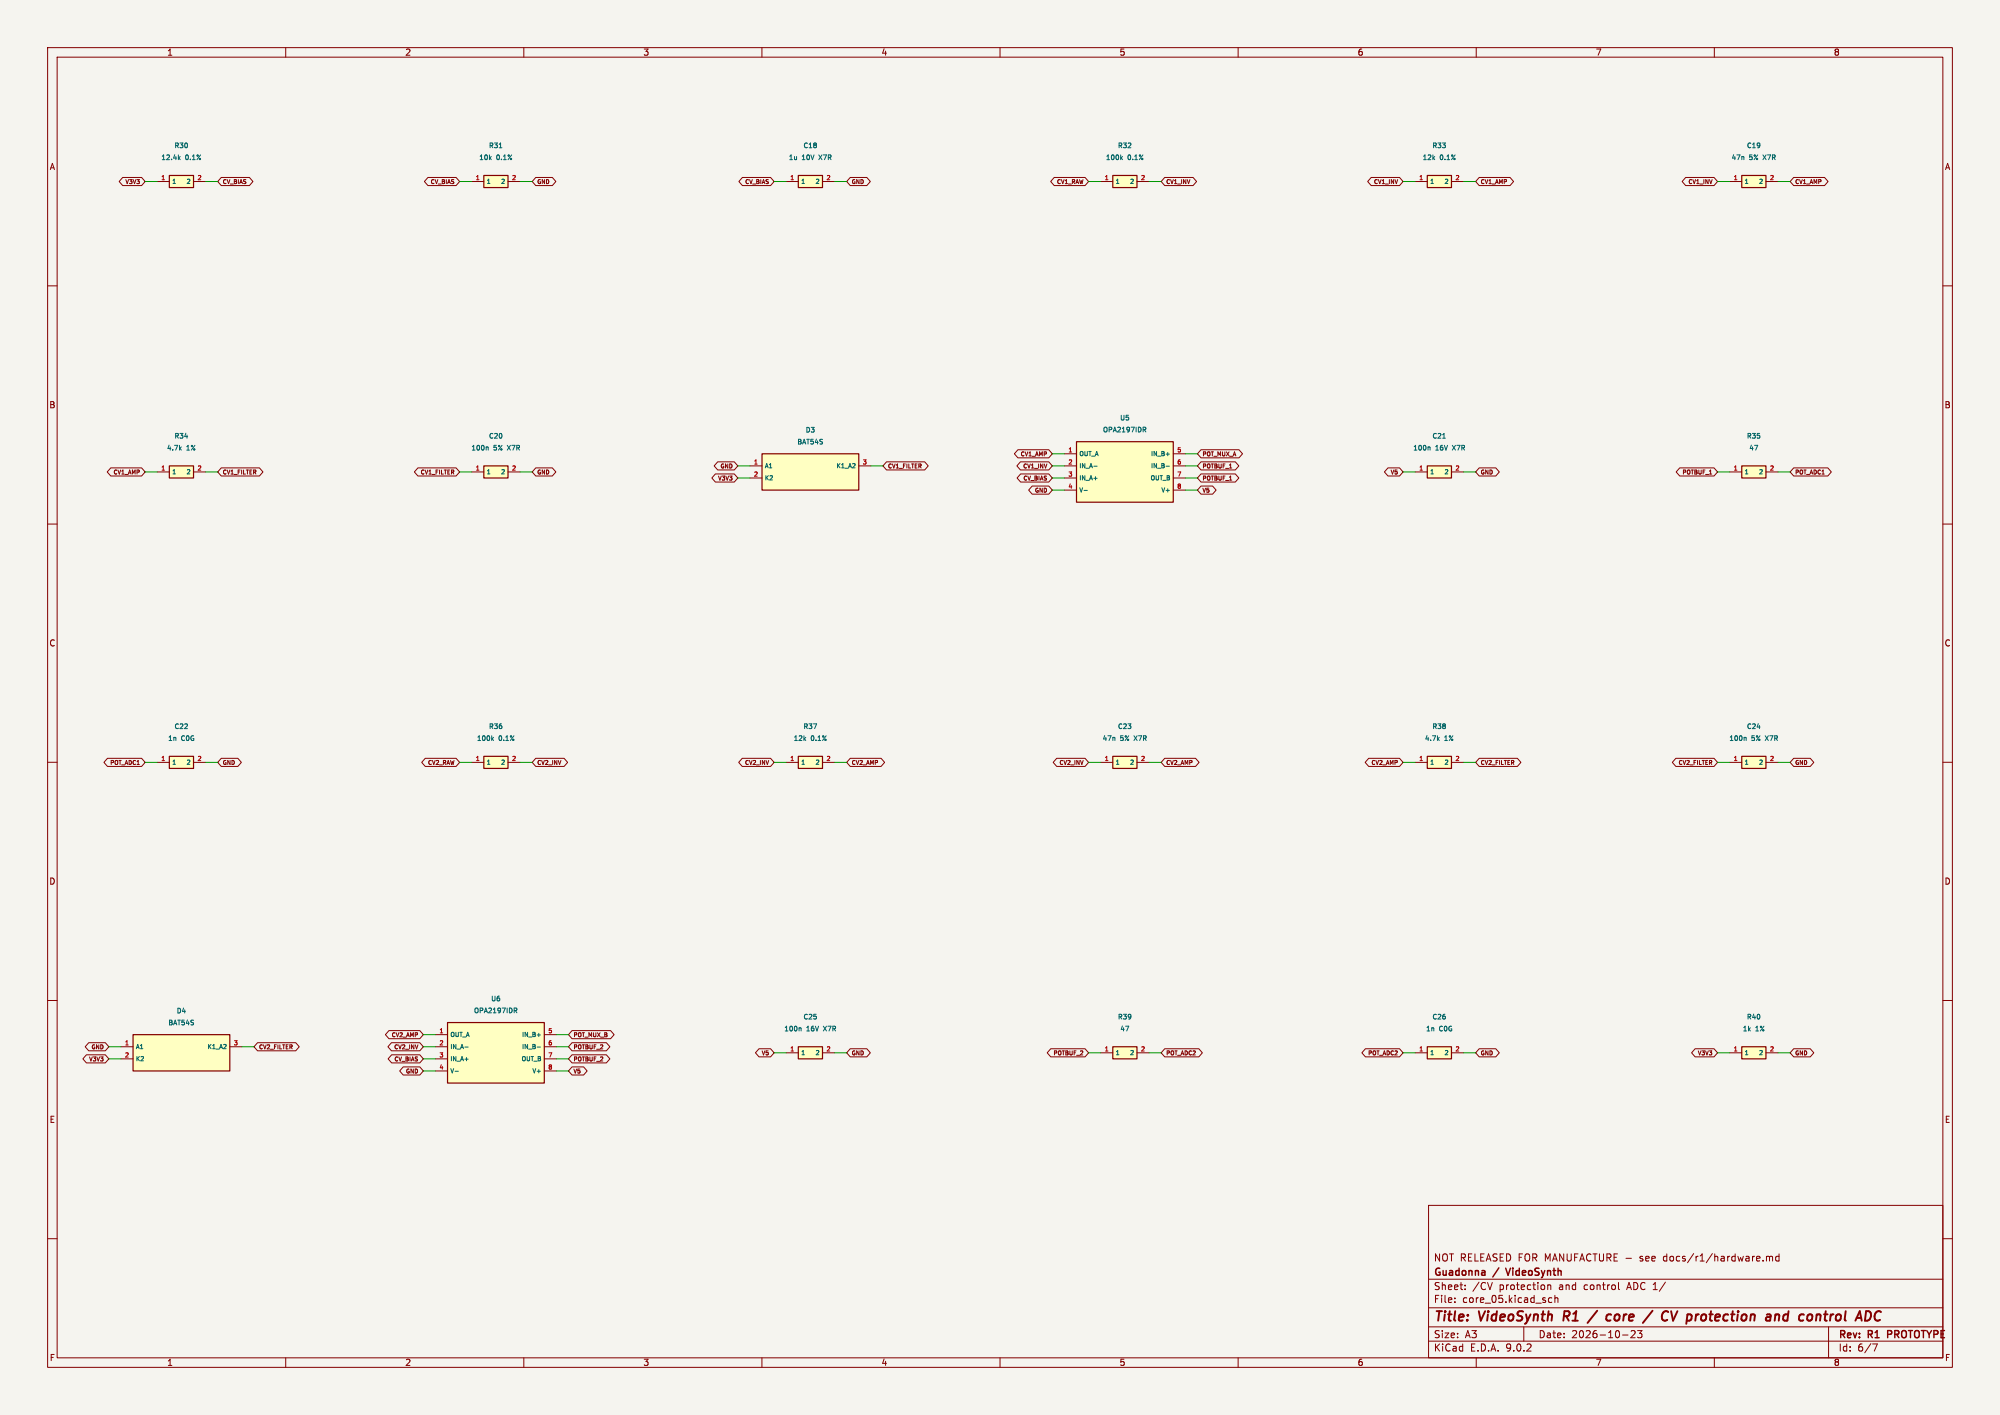
[picture p13: page 6]

Id: 6/7 Title: VideoSynth R1 / core / CV protection and control ADC

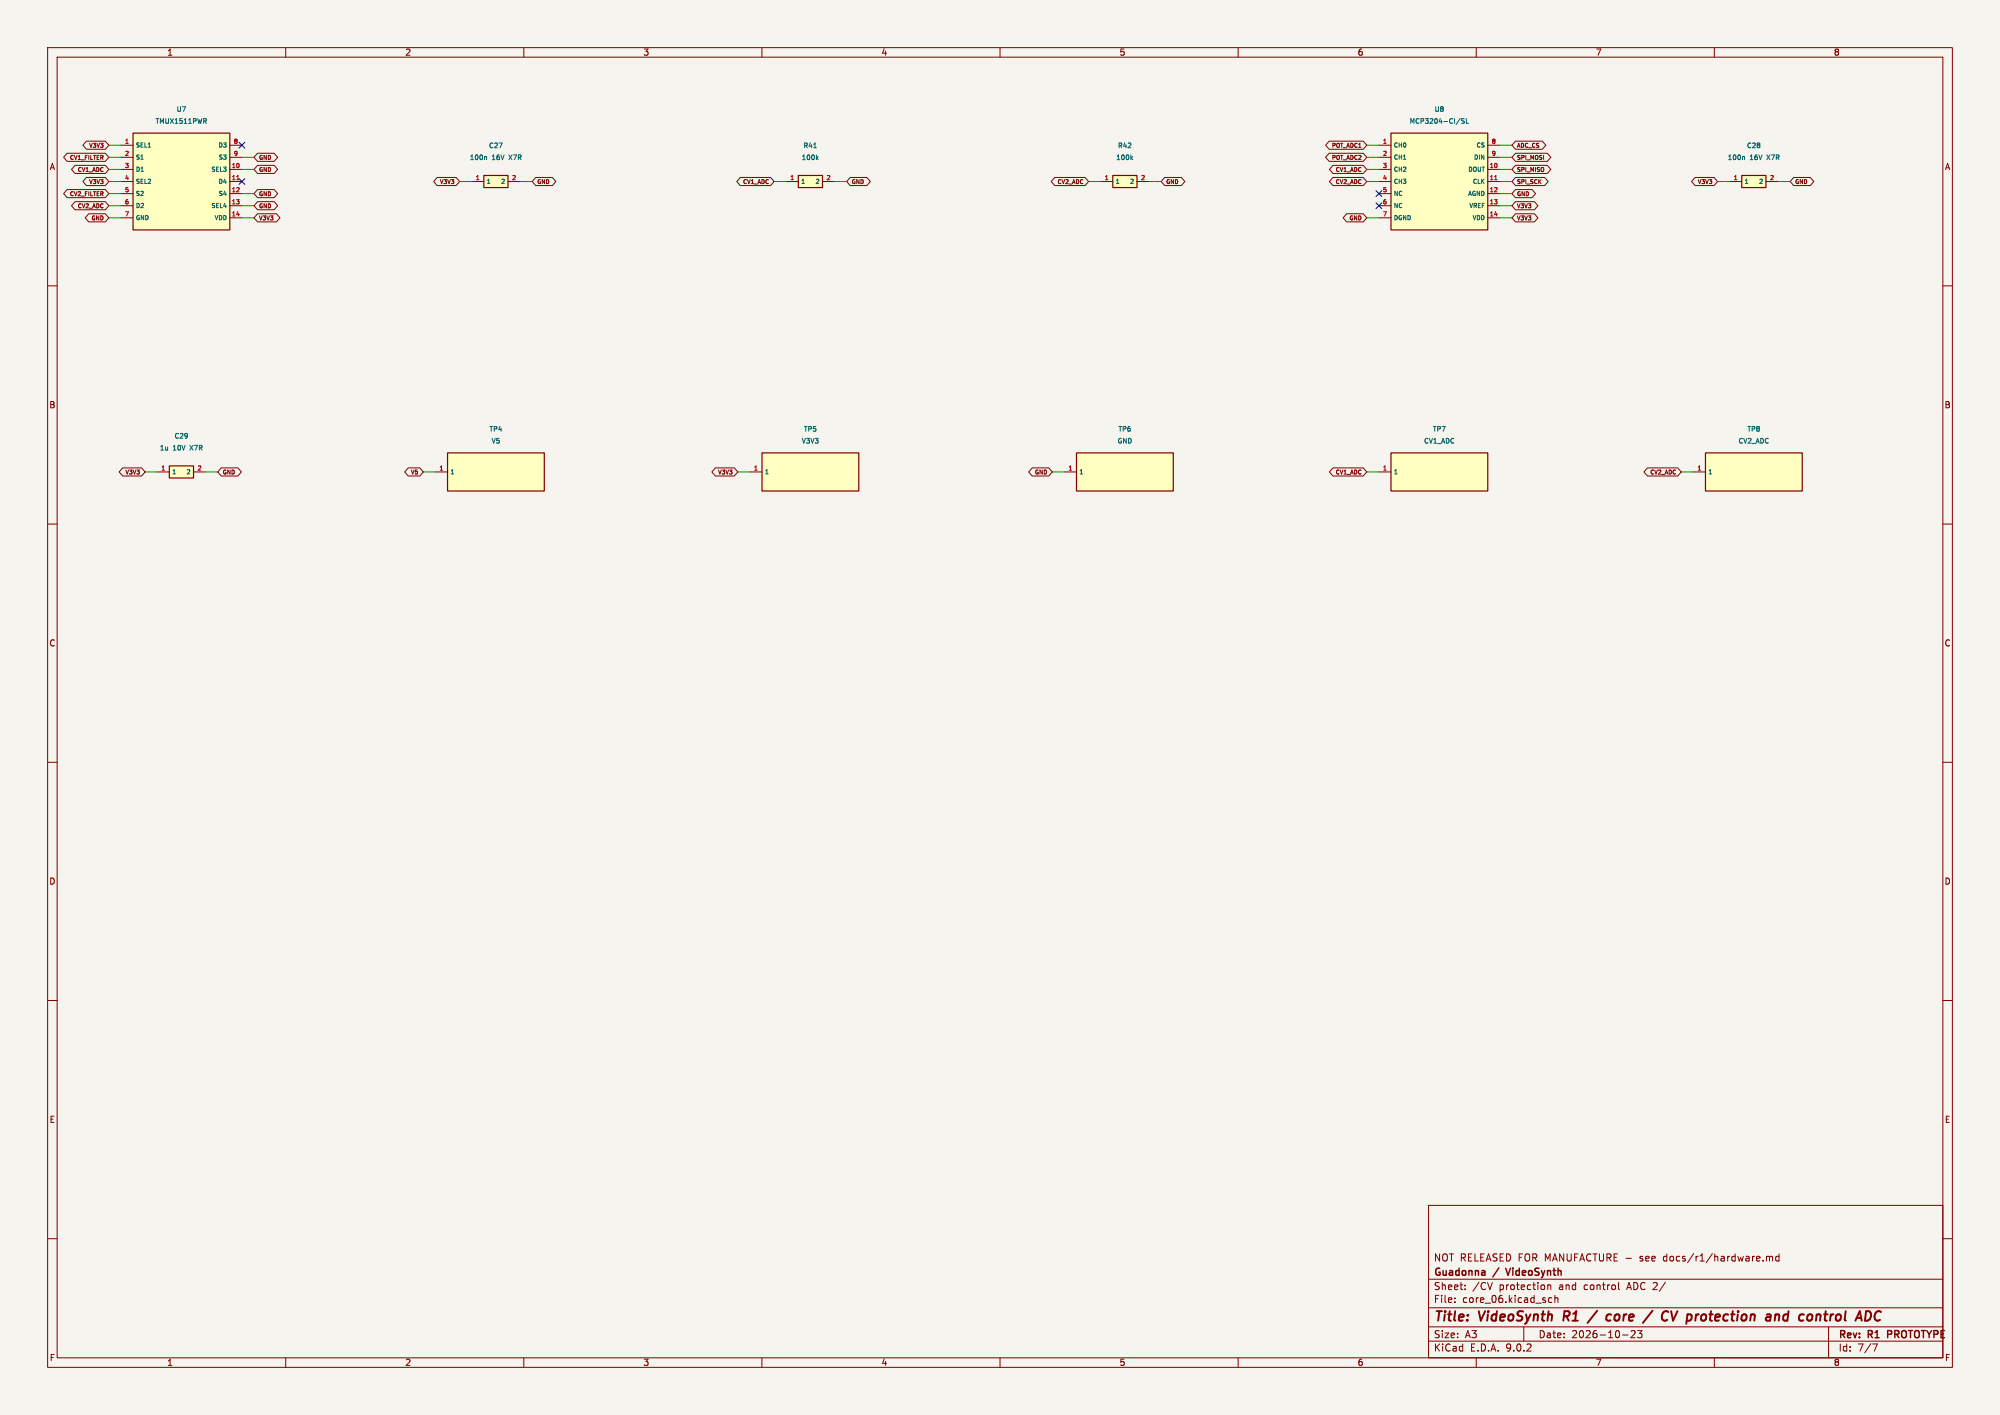
[picture p14: page 7]

Id: 7/7 Title: VideoSynth R1 / core / CV protection and control ADC
