Guadonna/VideoSynth/hardware/kicad/panel/panel-schematic.pdf

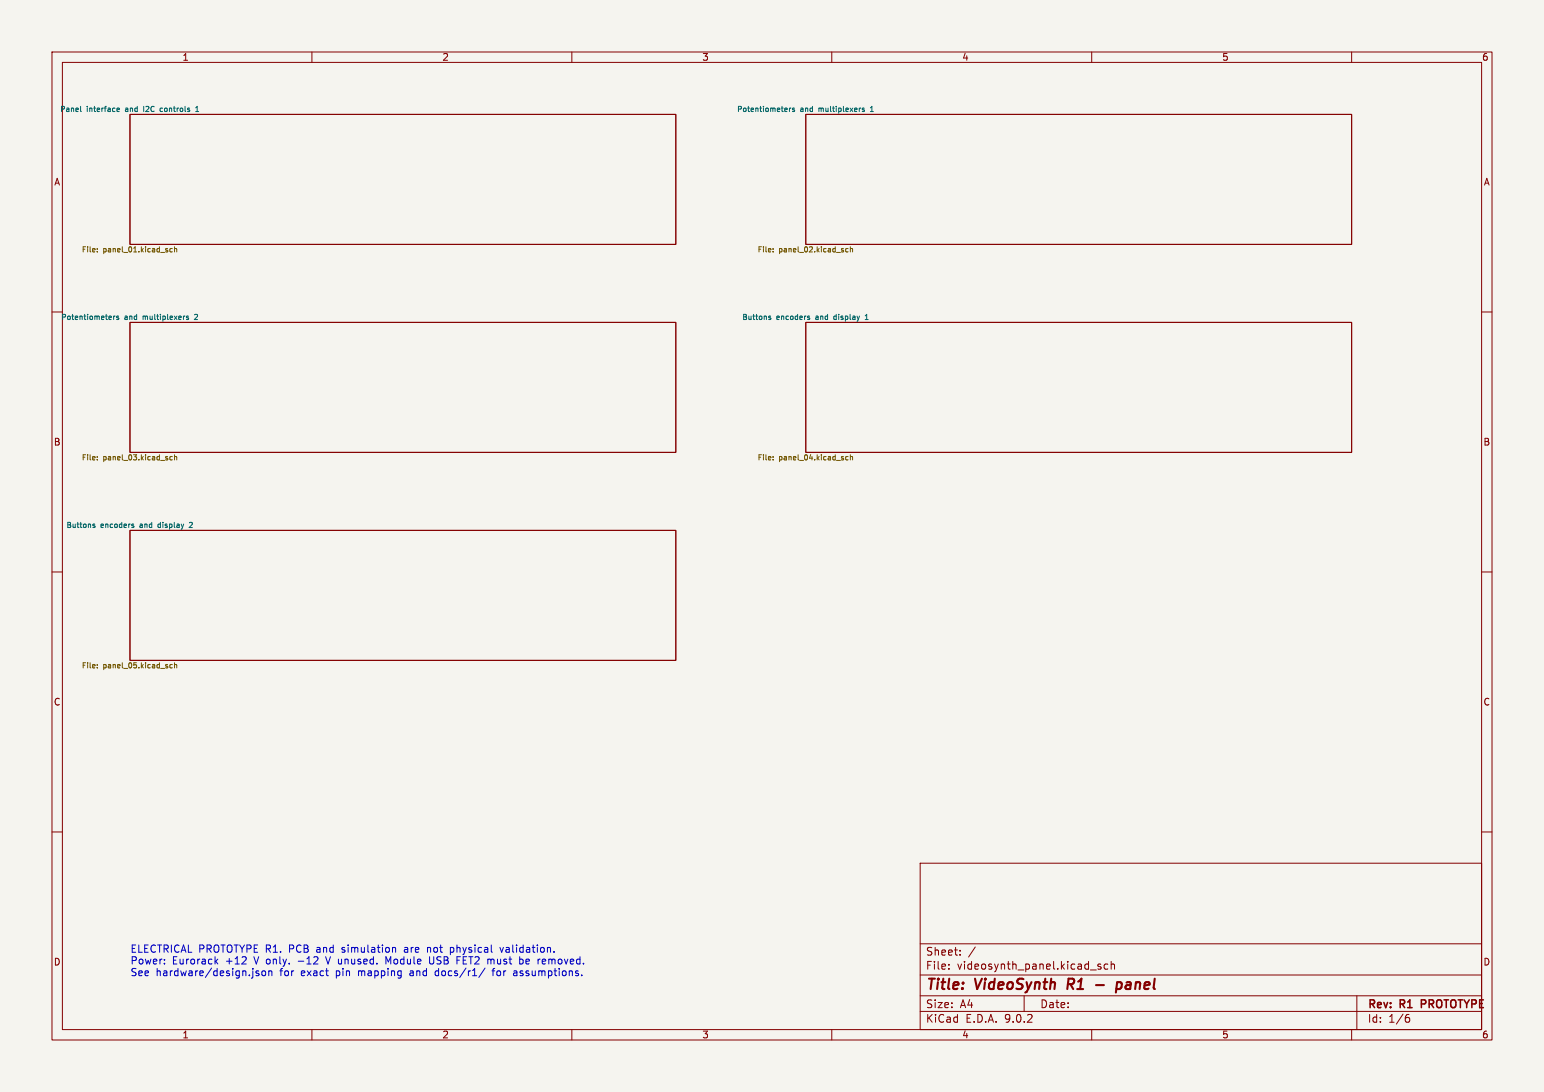
[picture p15: page 1]

Id: 1/6 Title: VideoSynth R1 - panel File: videosynth_panel.kicad_sch Sheet: /

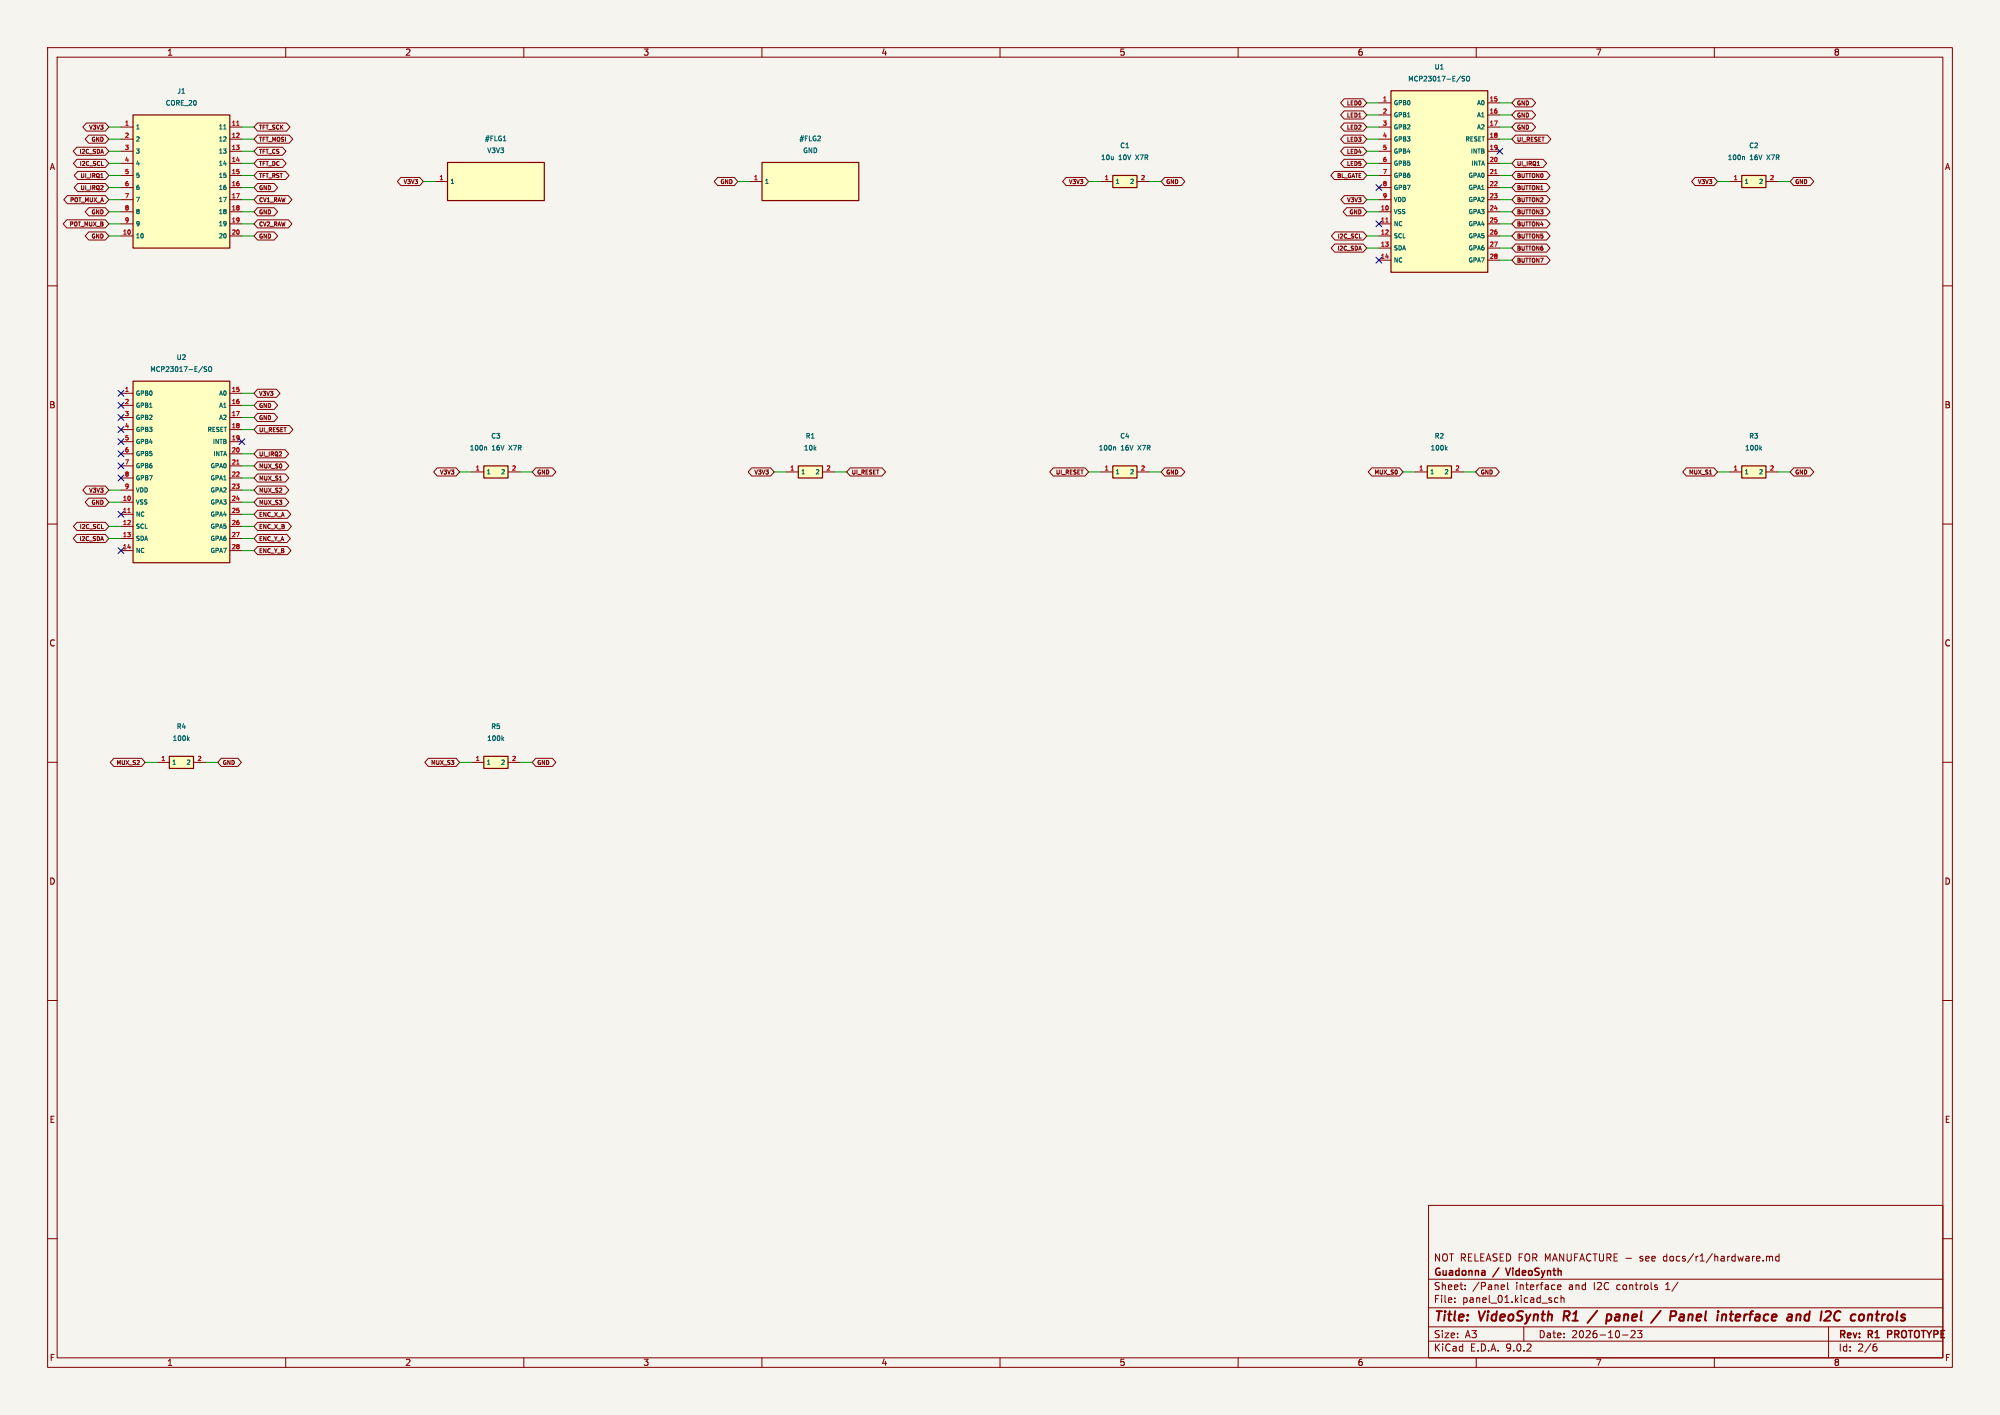
[picture p16: page 2]

Id: 2/6 Title: VideoSynth R1 / panel / Panel interface and I2C controls

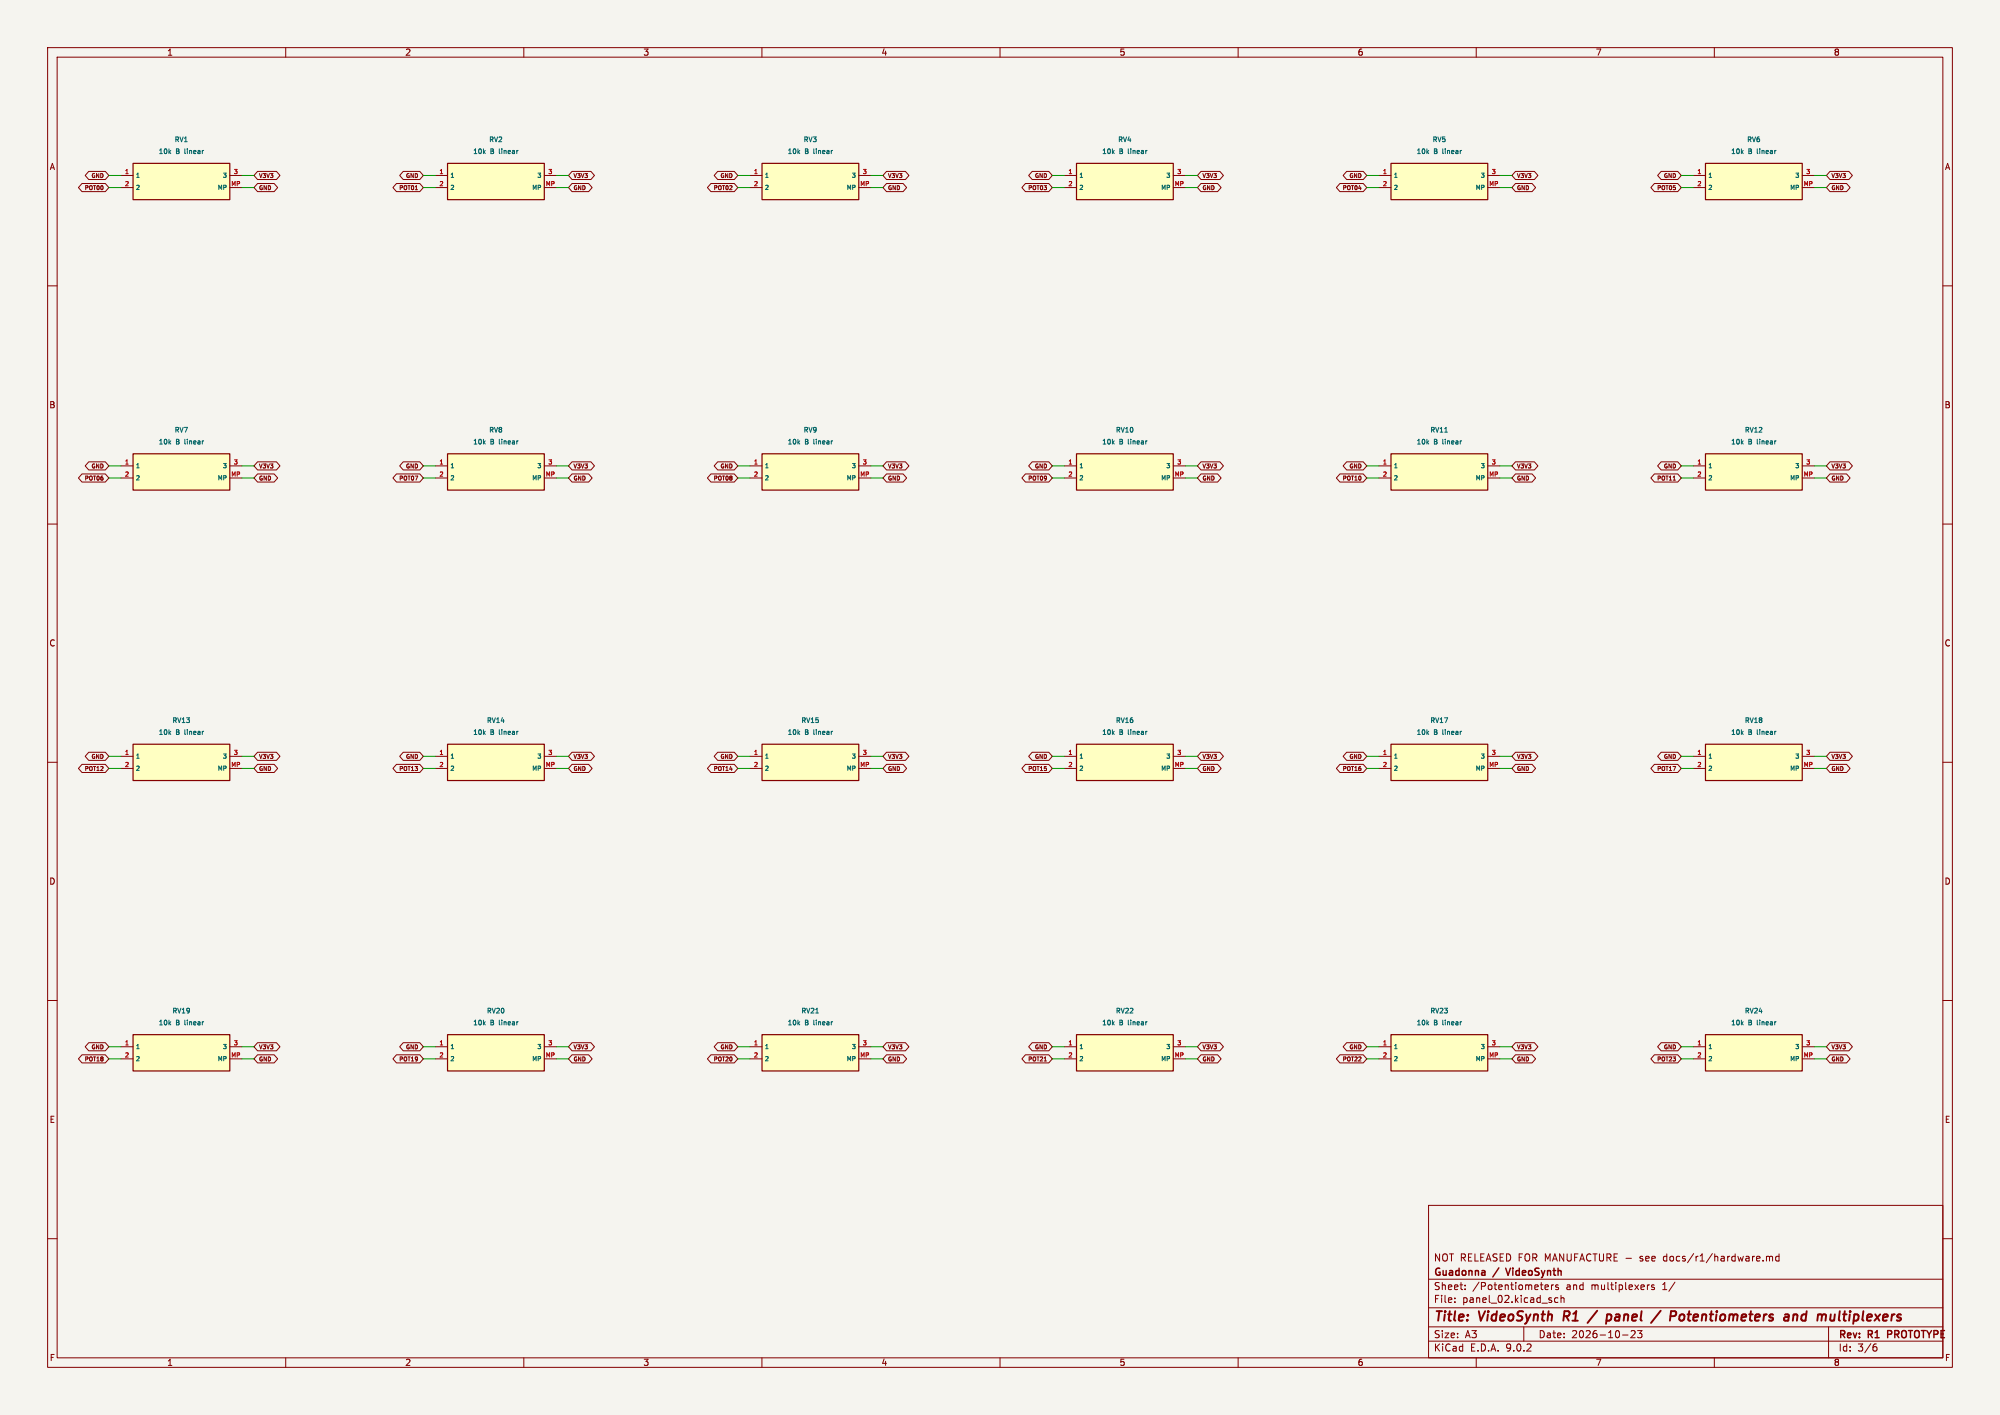
[picture p17: page 3]

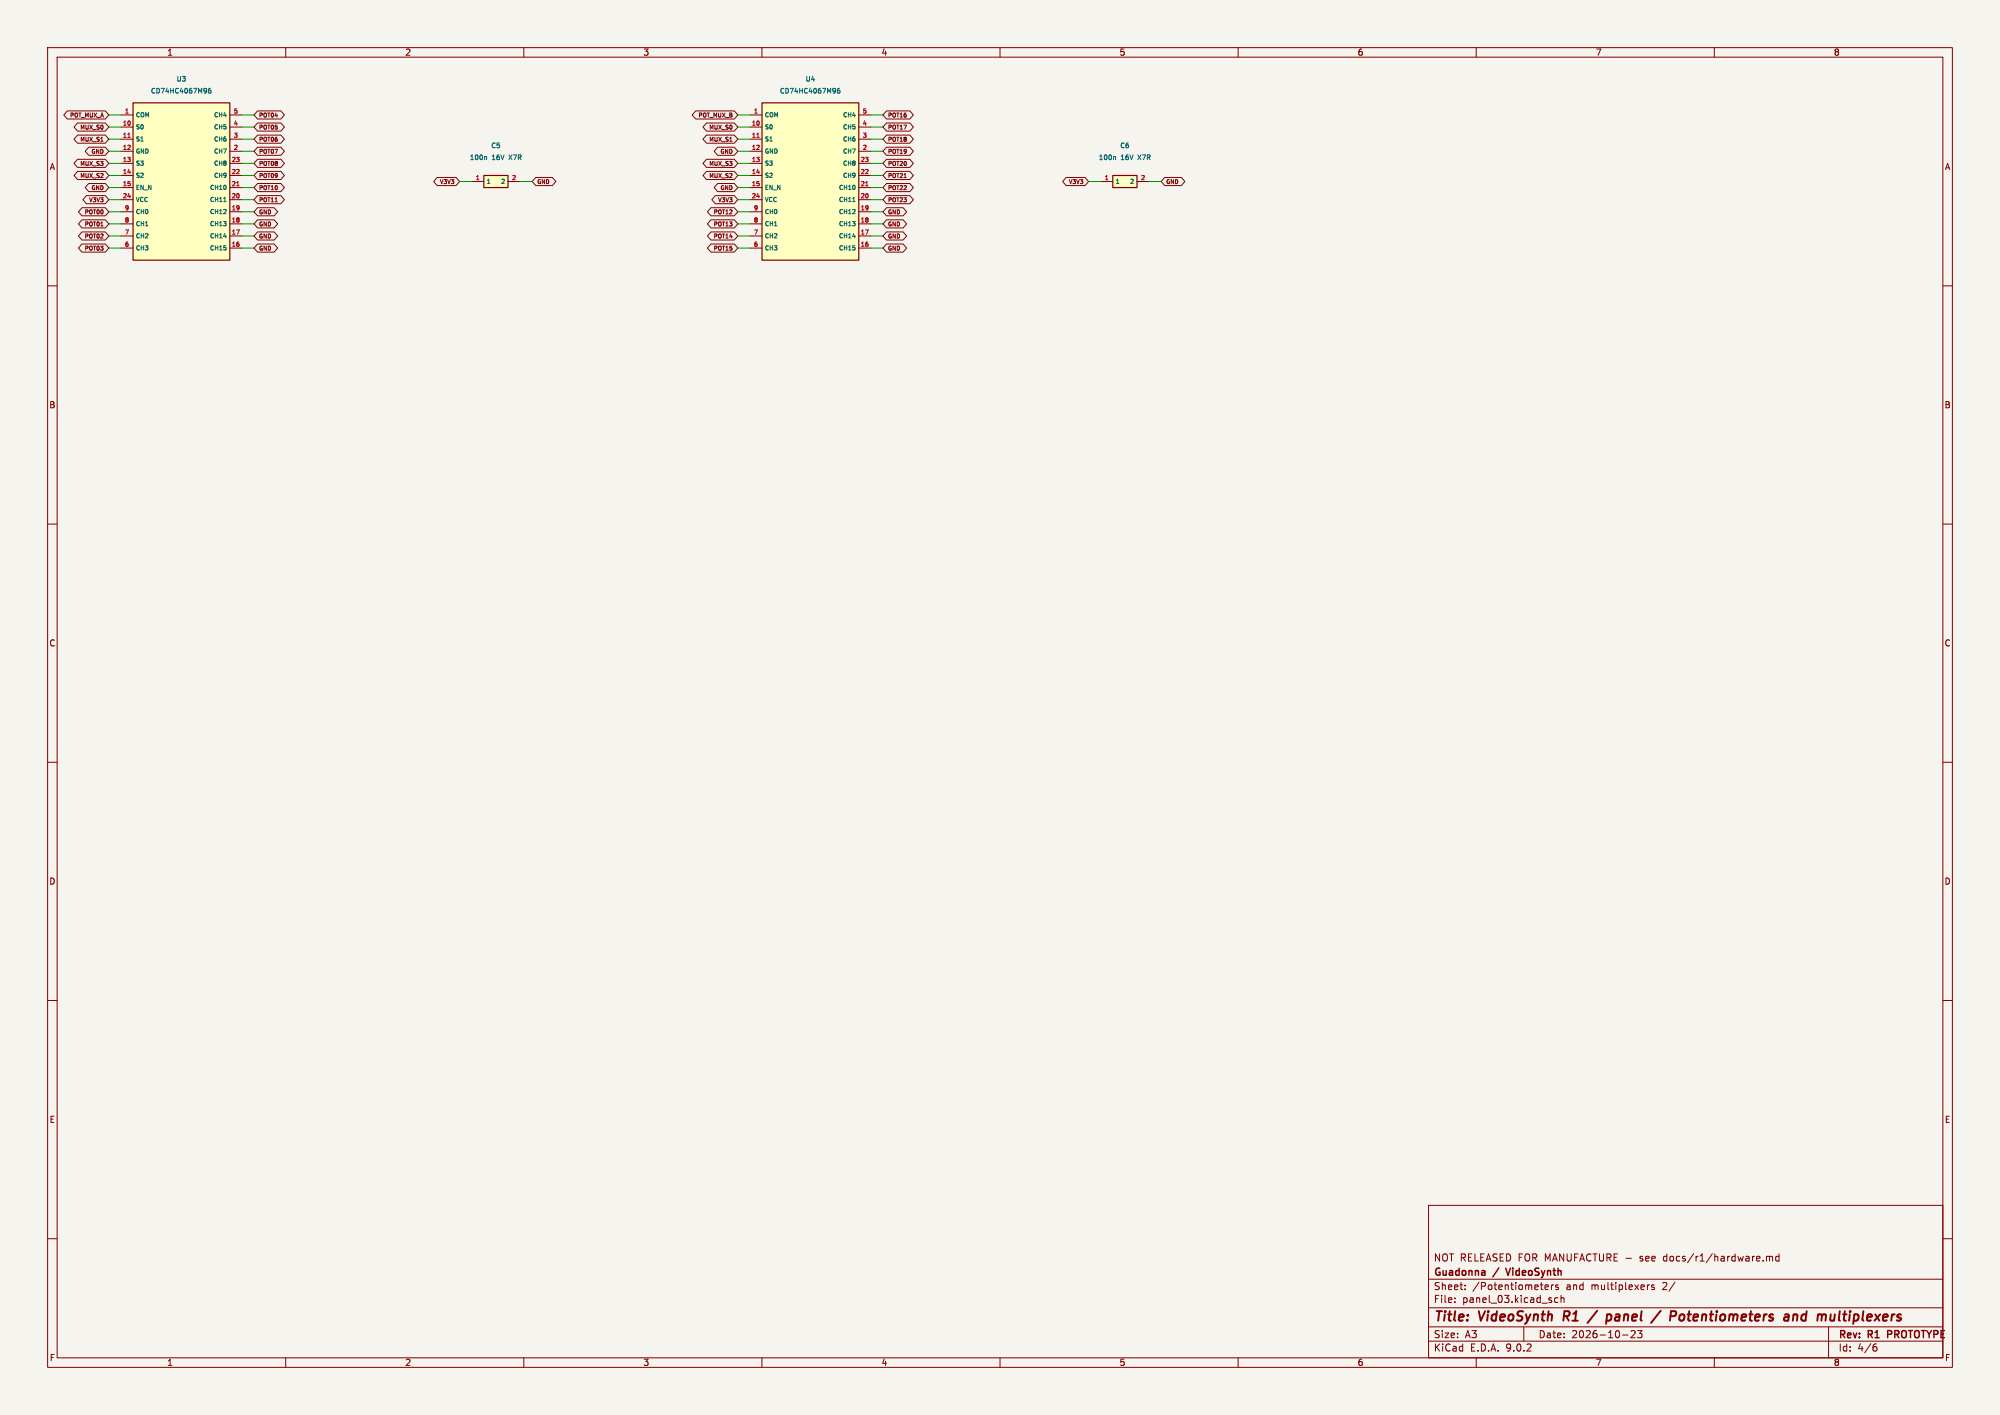
[picture p18: page 4]

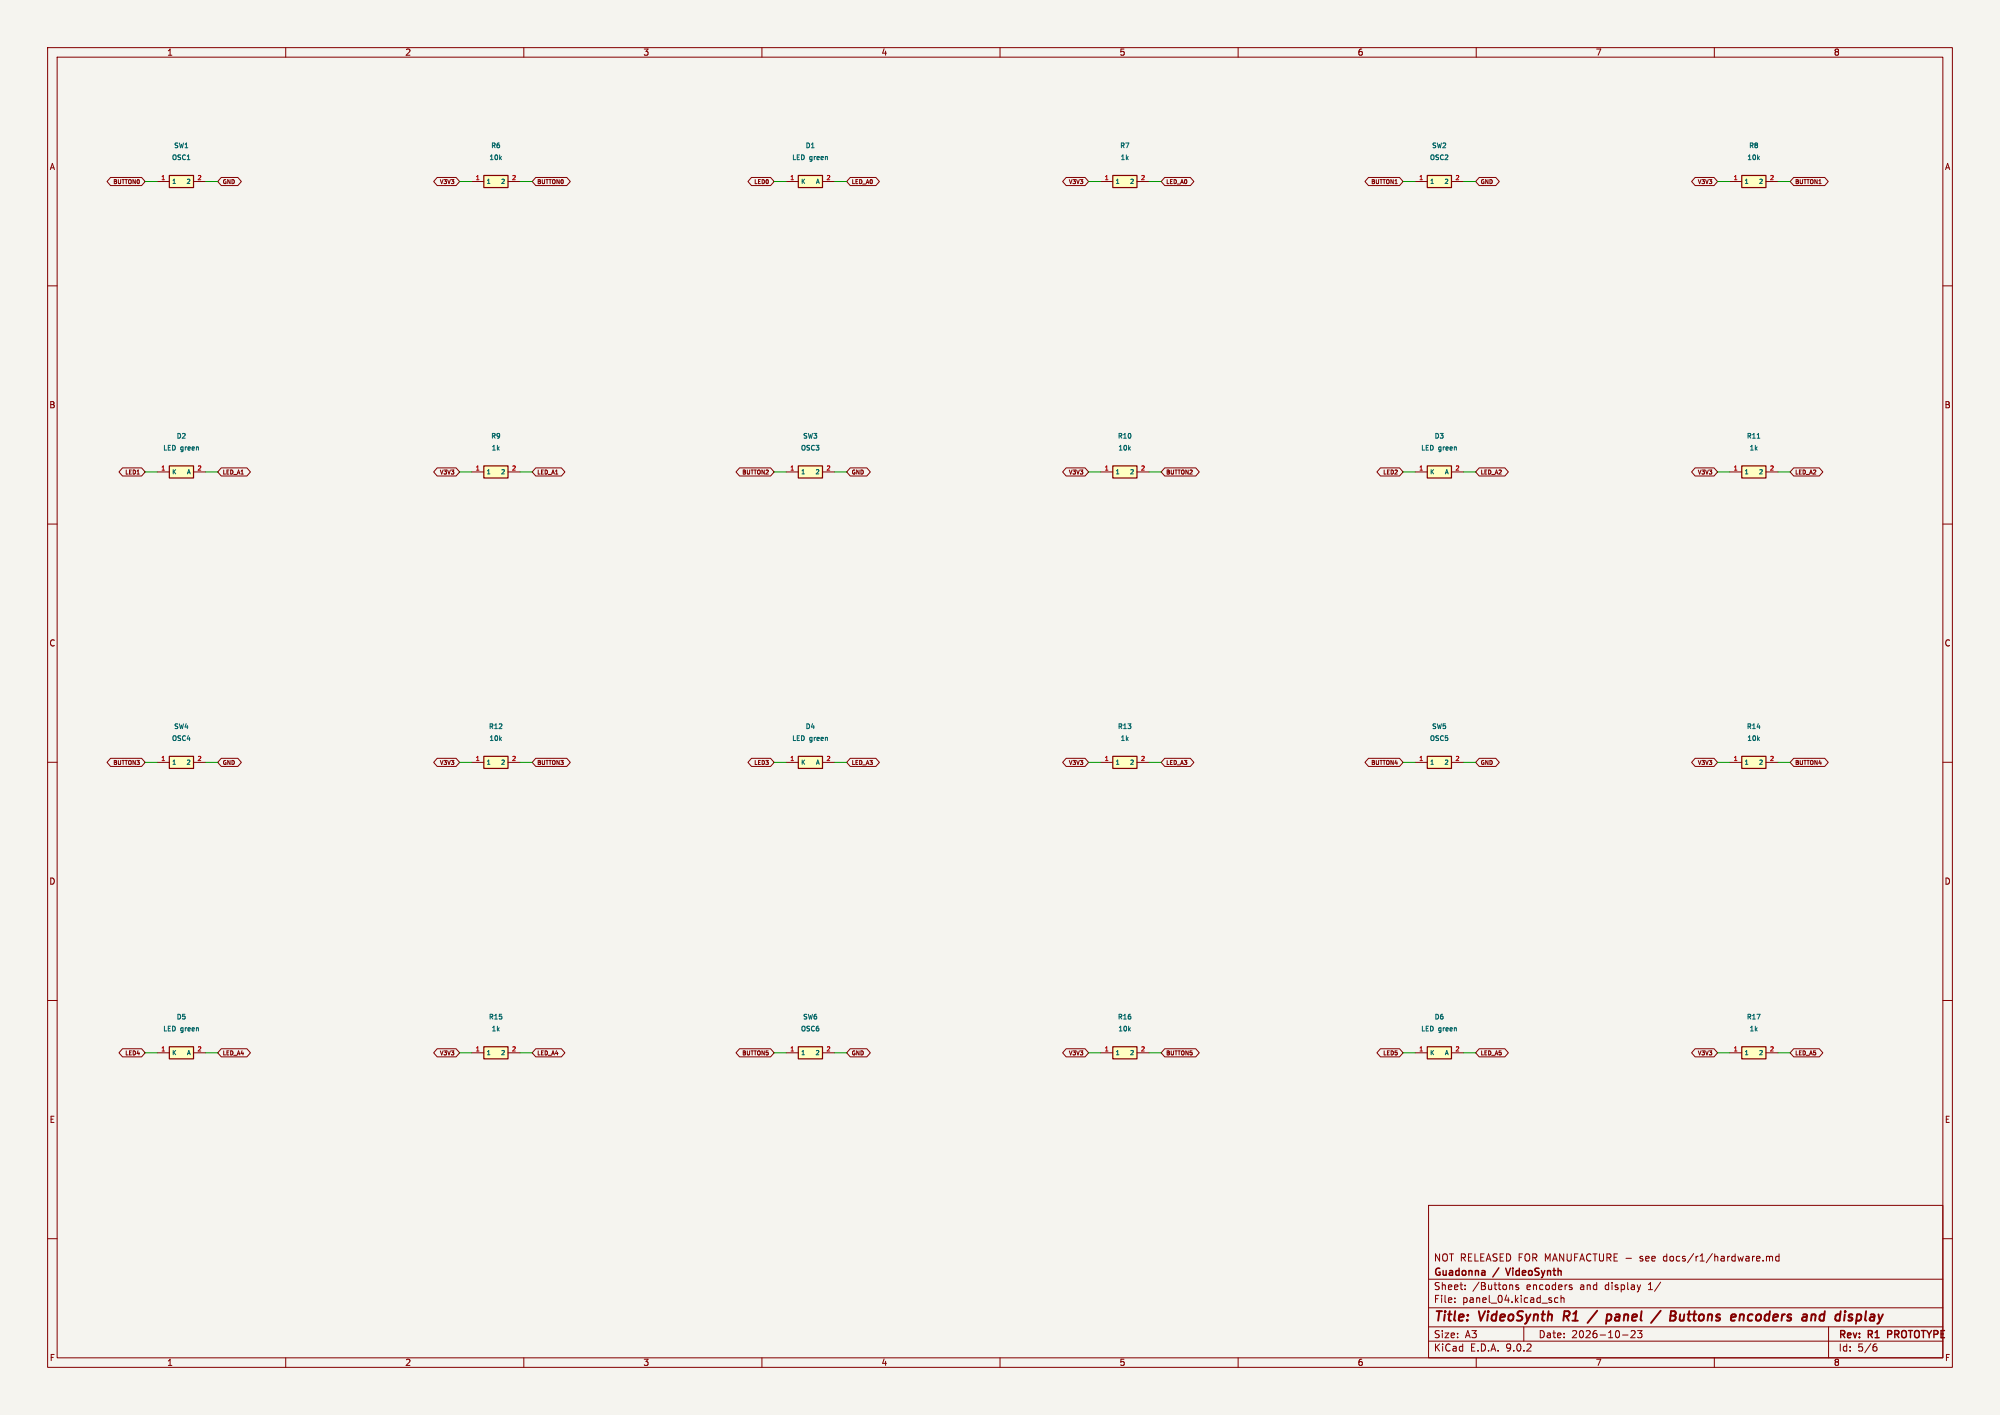
[picture p19: page 5]

Id: 5/6 Title: VideoSynth R1 / panel / Buttons encoders and display

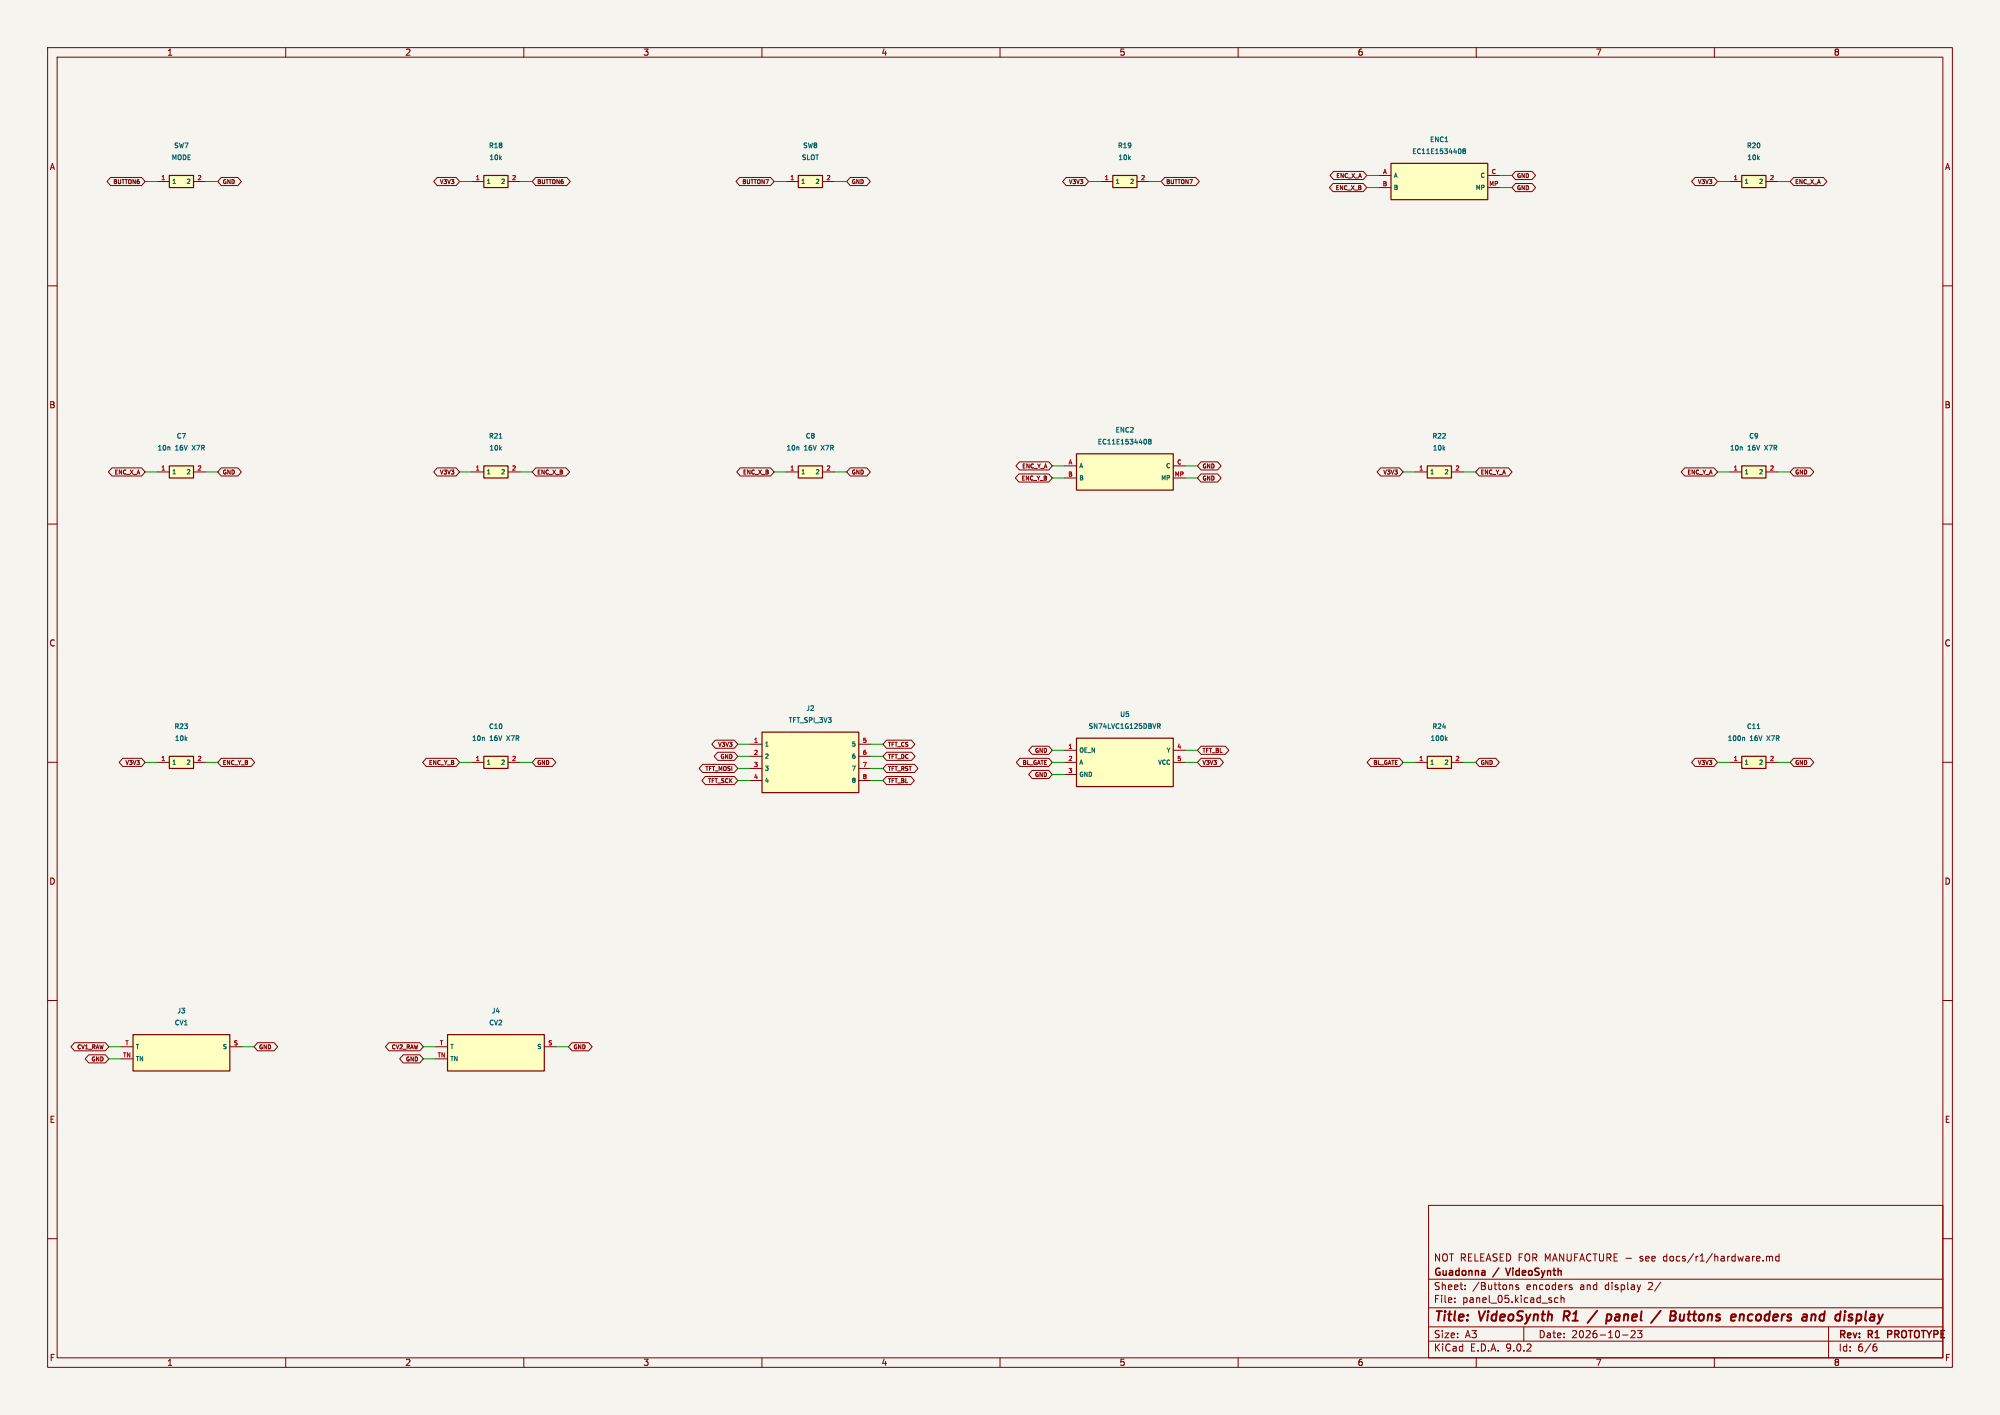
[picture p20: page 6]

Id: 6/6 Title: VideoSynth R1 / panel / Buttons encoders and display
