Guadonna/VideoSynth/hardware/kicad/panel/videosynth_panel.kicad_pcb

## KiCad design hardware/kicad/panel/videosynth_panel.kicad_pcb (2026-10-23)

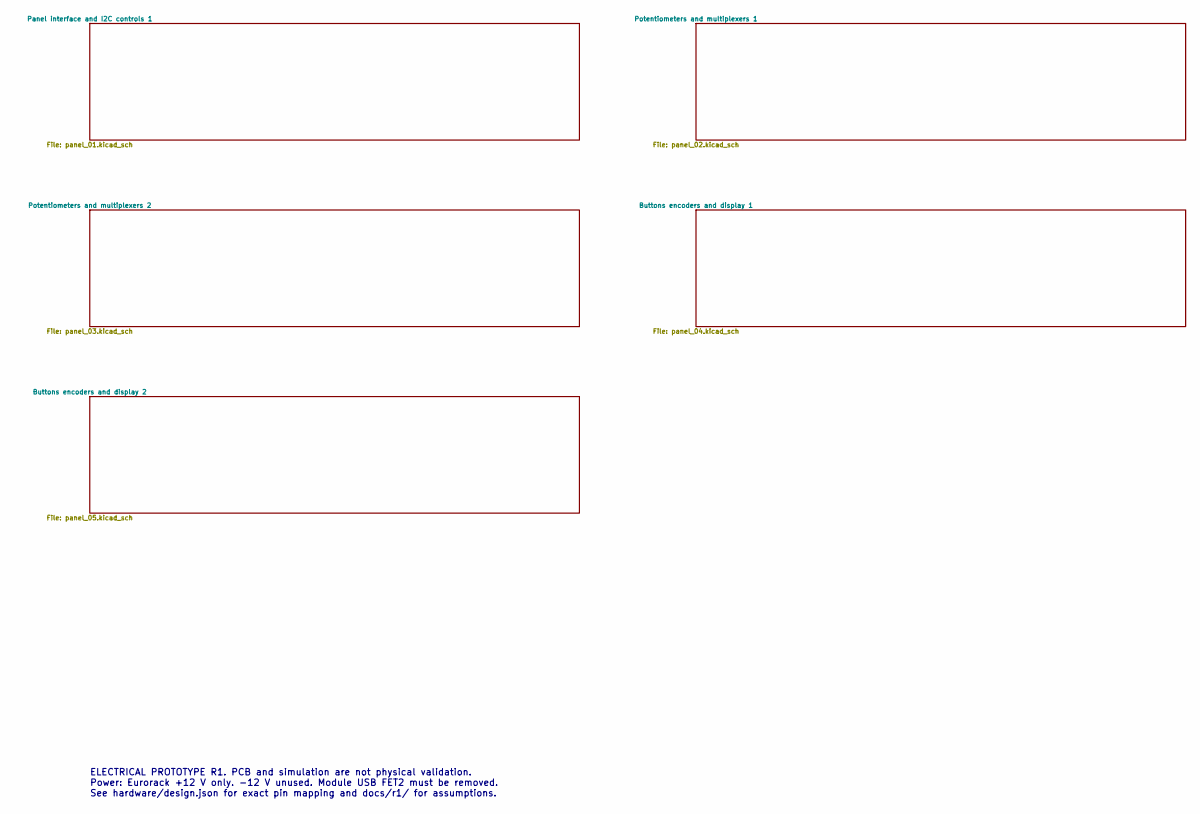
[picture p21: schematic videosynth_panel.kicad_sch, VideoSynth R1 - panel]

Notes on the sheet:
ELECTRICAL PROTOTYPE R1. PCB and simulation are not physical validation. Power: Eurorack +12 V only. -12 V unused. Module USB FET2 must be removed. See hardware/design.json for exact pin mapping and docs/r1/ for assumptions.

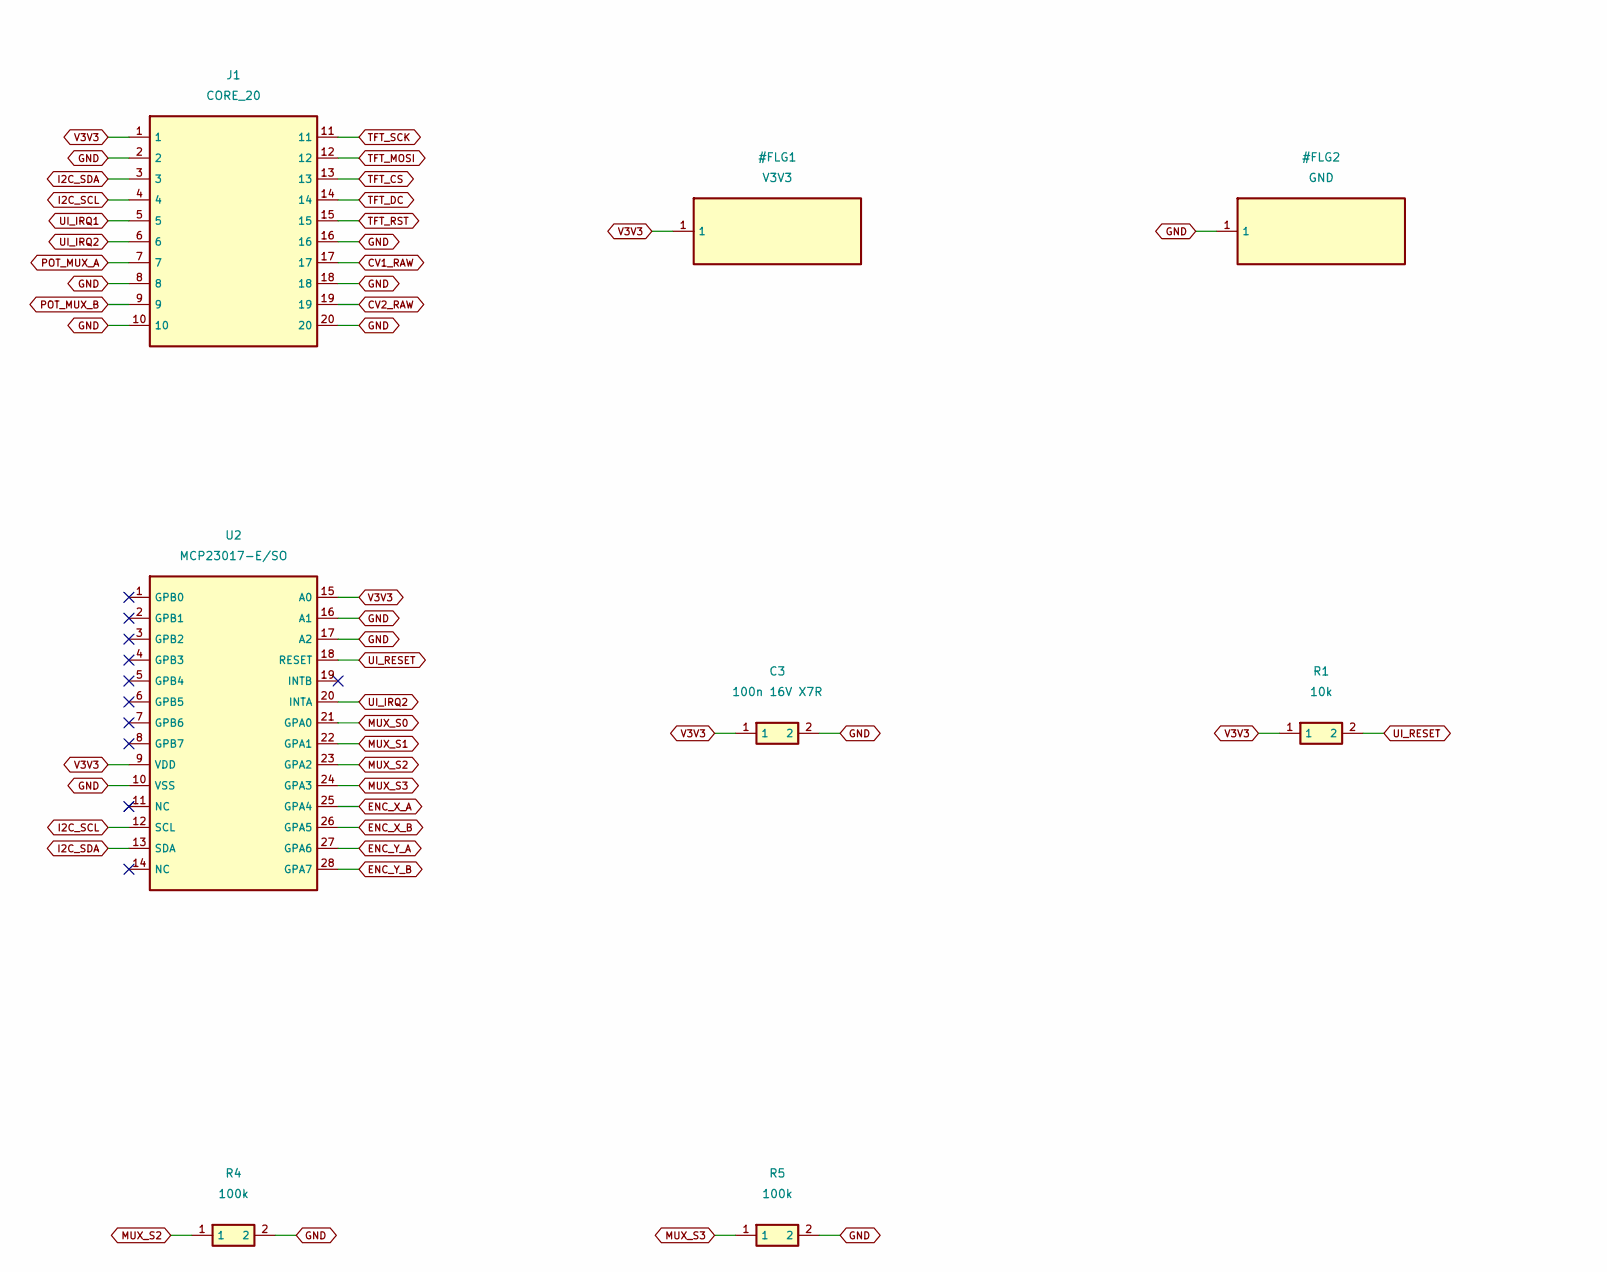
[picture p22: schematic panel_01.kicad_sch, VideoSynth R1 / panel / Panel interface and I2C controls, part in row 1, column 1]

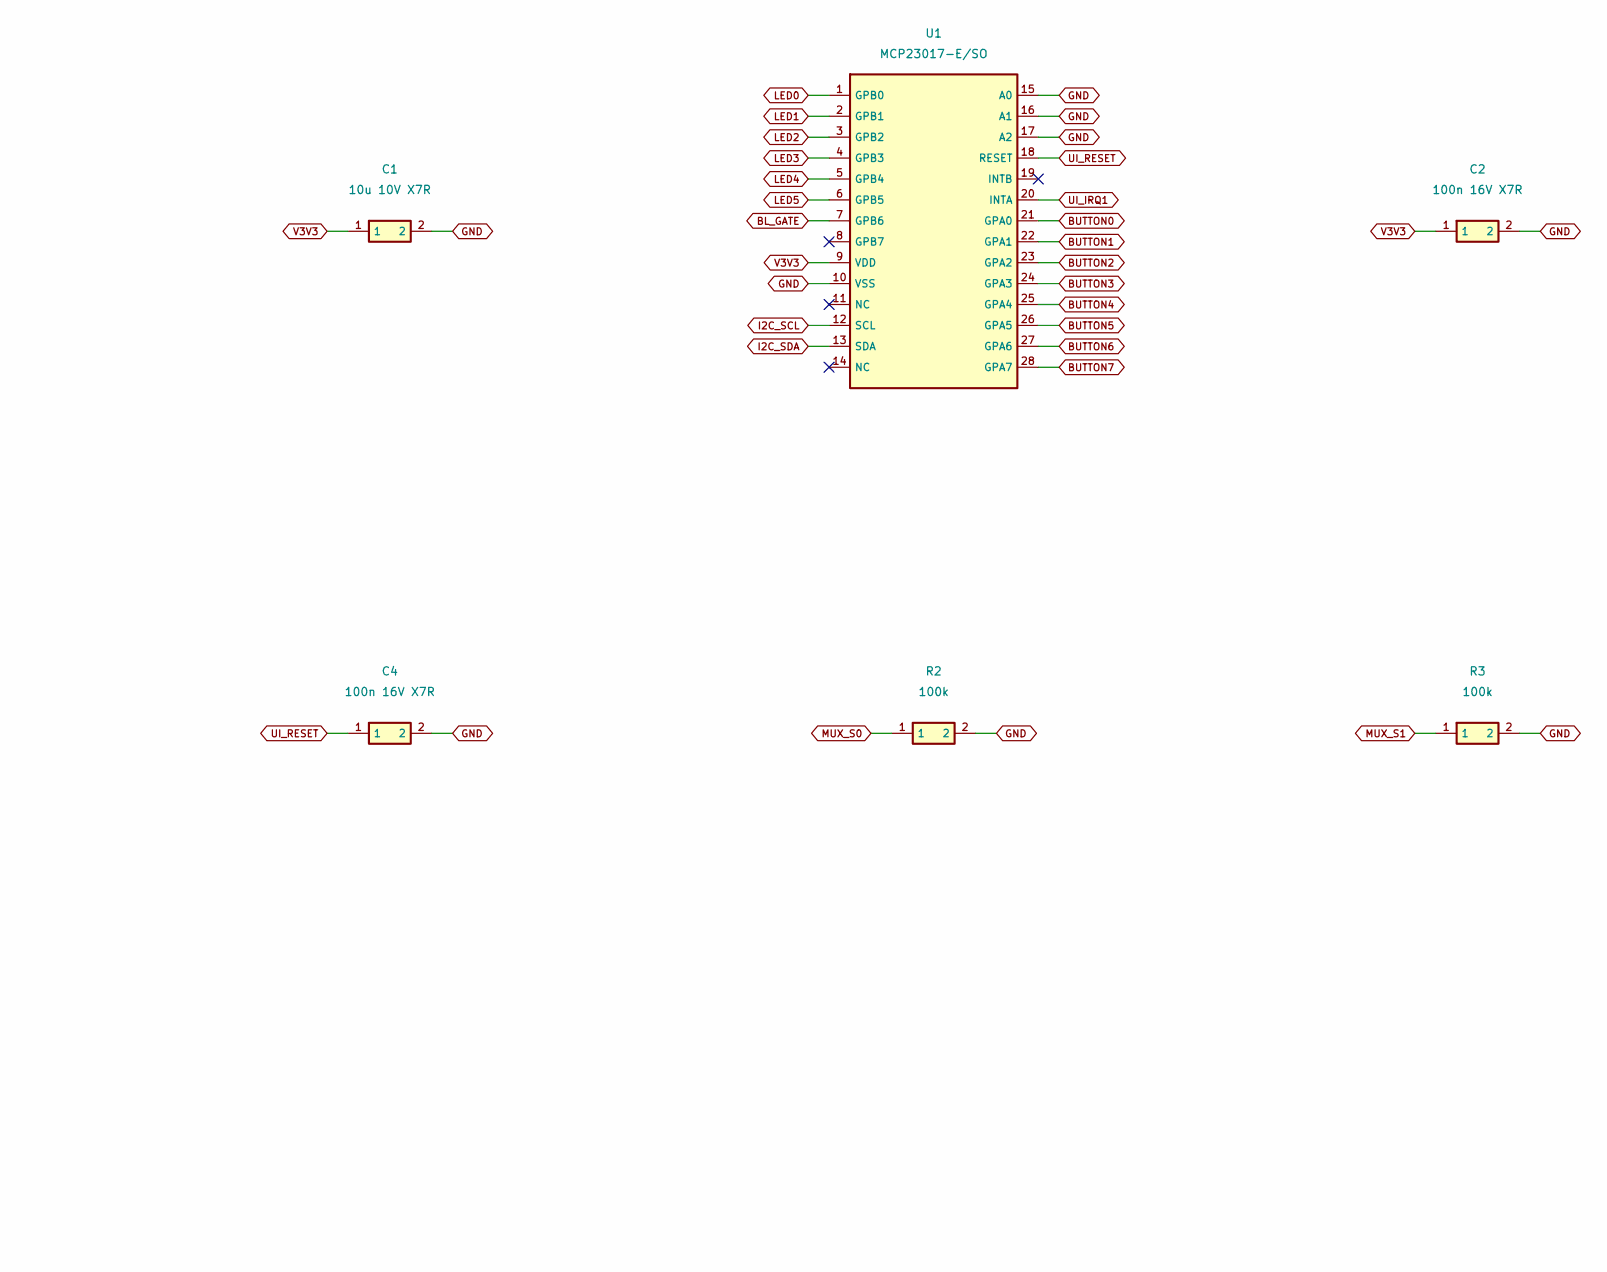
[picture p23: schematic panel_01.kicad_sch, VideoSynth R1 / panel / Panel interface and I2C controls, part in row 1, column 2]

Parts:
C1: 10u 10V X7R; C_0805_2012Metric
C2, C3, C4: 100n 16V X7R; C_0805_2012Metric
J1: CORE_20; IDC-Header_2x10_P2.54mm_Vertical
R1: 10k; R_0805_2012Metric
R2, R3, R4, R5: 100k; R_0805_2012Metric
U1, U2: MCP23017-E/SO; SOIC-28W_7.5x17.9mm_P1.27mm

Connections:
BL_GATE: U1.7 (GPB6); also elsewhere on the board
BUTTON0: U1.21 (GPA0); also elsewhere on the board
BUTTON1: U1.22 (GPA1); also elsewhere on the board
BUTTON2: U1.23 (GPA2); also elsewhere on the board
BUTTON3: U1.24 (GPA3); also elsewhere on the board
BUTTON4: U1.25 (GPA4); also elsewhere on the board
BUTTON5: U1.26 (GPA5); also elsewhere on the board
BUTTON6: U1.27 (GPA6); also elsewhere on the board
BUTTON7: U1.28 (GPA7); also elsewhere on the board
CV1_RAW: J1.17; also elsewhere on the board
CV2_RAW: J1.19; also elsewhere on the board
ENC_X_A: U2.25 (GPA4); also elsewhere on the board
ENC_X_B: U2.26 (GPA5); also elsewhere on the board
ENC_Y_A: U2.27 (GPA6); also elsewhere on the board
ENC_Y_B: U2.28 (GPA7); also elsewhere on the board
GND: C1.2, C2.2, C3.2, C4.2, J1.2, J1.8, J1.10, J1.16, J1.18, J1.20, R2.2, R3.2, R4.2, R5.2, U1.10 (VSS), U1.15 (A0), U1.16 (A1), U1.17 (A2), U2.10 (VSS), U2.16 (A1), U2.17 (A2); also elsewhere on the board
I2C_SCL: J1.4, U1.12 (SCL), U2.12 (SCL)
I2C_SDA: J1.3, U1.13 (SDA), U2.13 (SDA)
LED0: U1.1 (GPB0); also elsewhere on the board
LED1: U1.2 (GPB1); also elsewhere on the board
LED2: U1.3 (GPB2); also elsewhere on the board
LED3: U1.4 (GPB3); also elsewhere on the board
LED4: U1.5 (GPB4); also elsewhere on the board
LED5: U1.6 (GPB5); also elsewhere on the board
MUX_S0: R2.1, U2.21 (GPA0); also elsewhere on the board
MUX_S1: R3.1, U2.22 (GPA1); also elsewhere on the board
MUX_S2: R4.1, U2.23 (GPA2); also elsewhere on the board
MUX_S3: R5.1, U2.24 (GPA3); also elsewhere on the board
POT_MUX_A: J1.7; also elsewhere on the board
POT_MUX_B: J1.9; also elsewhere on the board
TFT_CS: J1.13; also elsewhere on the board
TFT_DC: J1.14; also elsewhere on the board
TFT_MOSI: J1.12; also elsewhere on the board
TFT_RST: J1.15; also elsewhere on the board
TFT_SCK: J1.11; also elsewhere on the board
UI_IRQ1: J1.5, U1.20 (INTA)
UI_IRQ2: J1.6, U2.20 (INTA)
UI_RESET: C4.1, R1.2, U1.18 (RESET), U2.18 (RESET)
V3V3: C1.1, C2.1, C3.1, J1.1, R1.1, U1.9 (VDD), U2.9 (VDD), U2.15 (A0); also elsewhere on the board

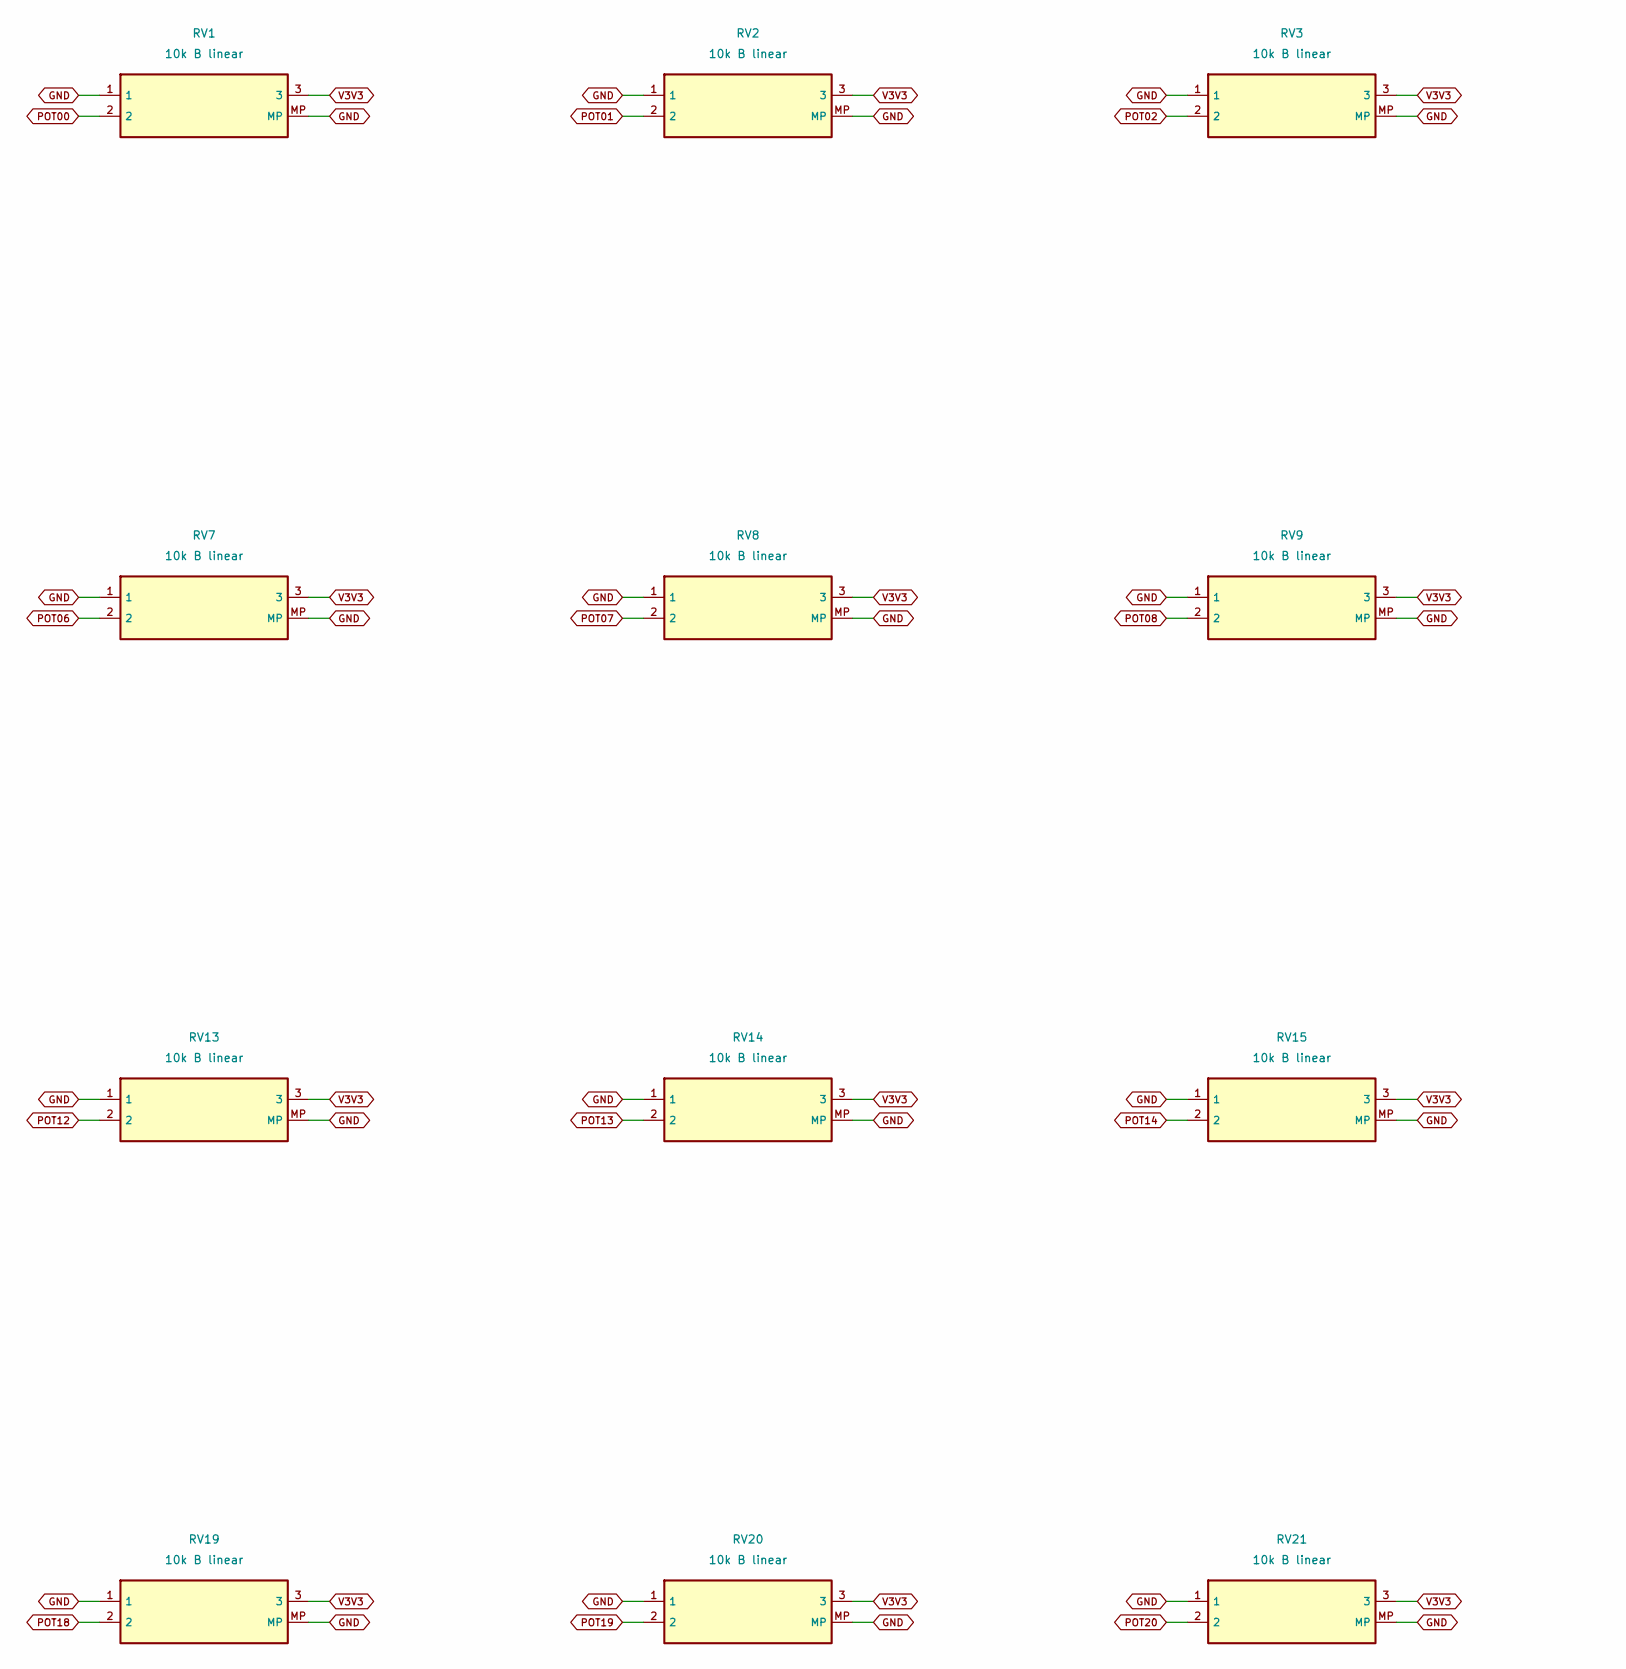
[picture p24: schematic panel_02.kicad_sch, VideoSynth R1 / panel / Potentiometers and multiplexers, part in row 1, column 1]

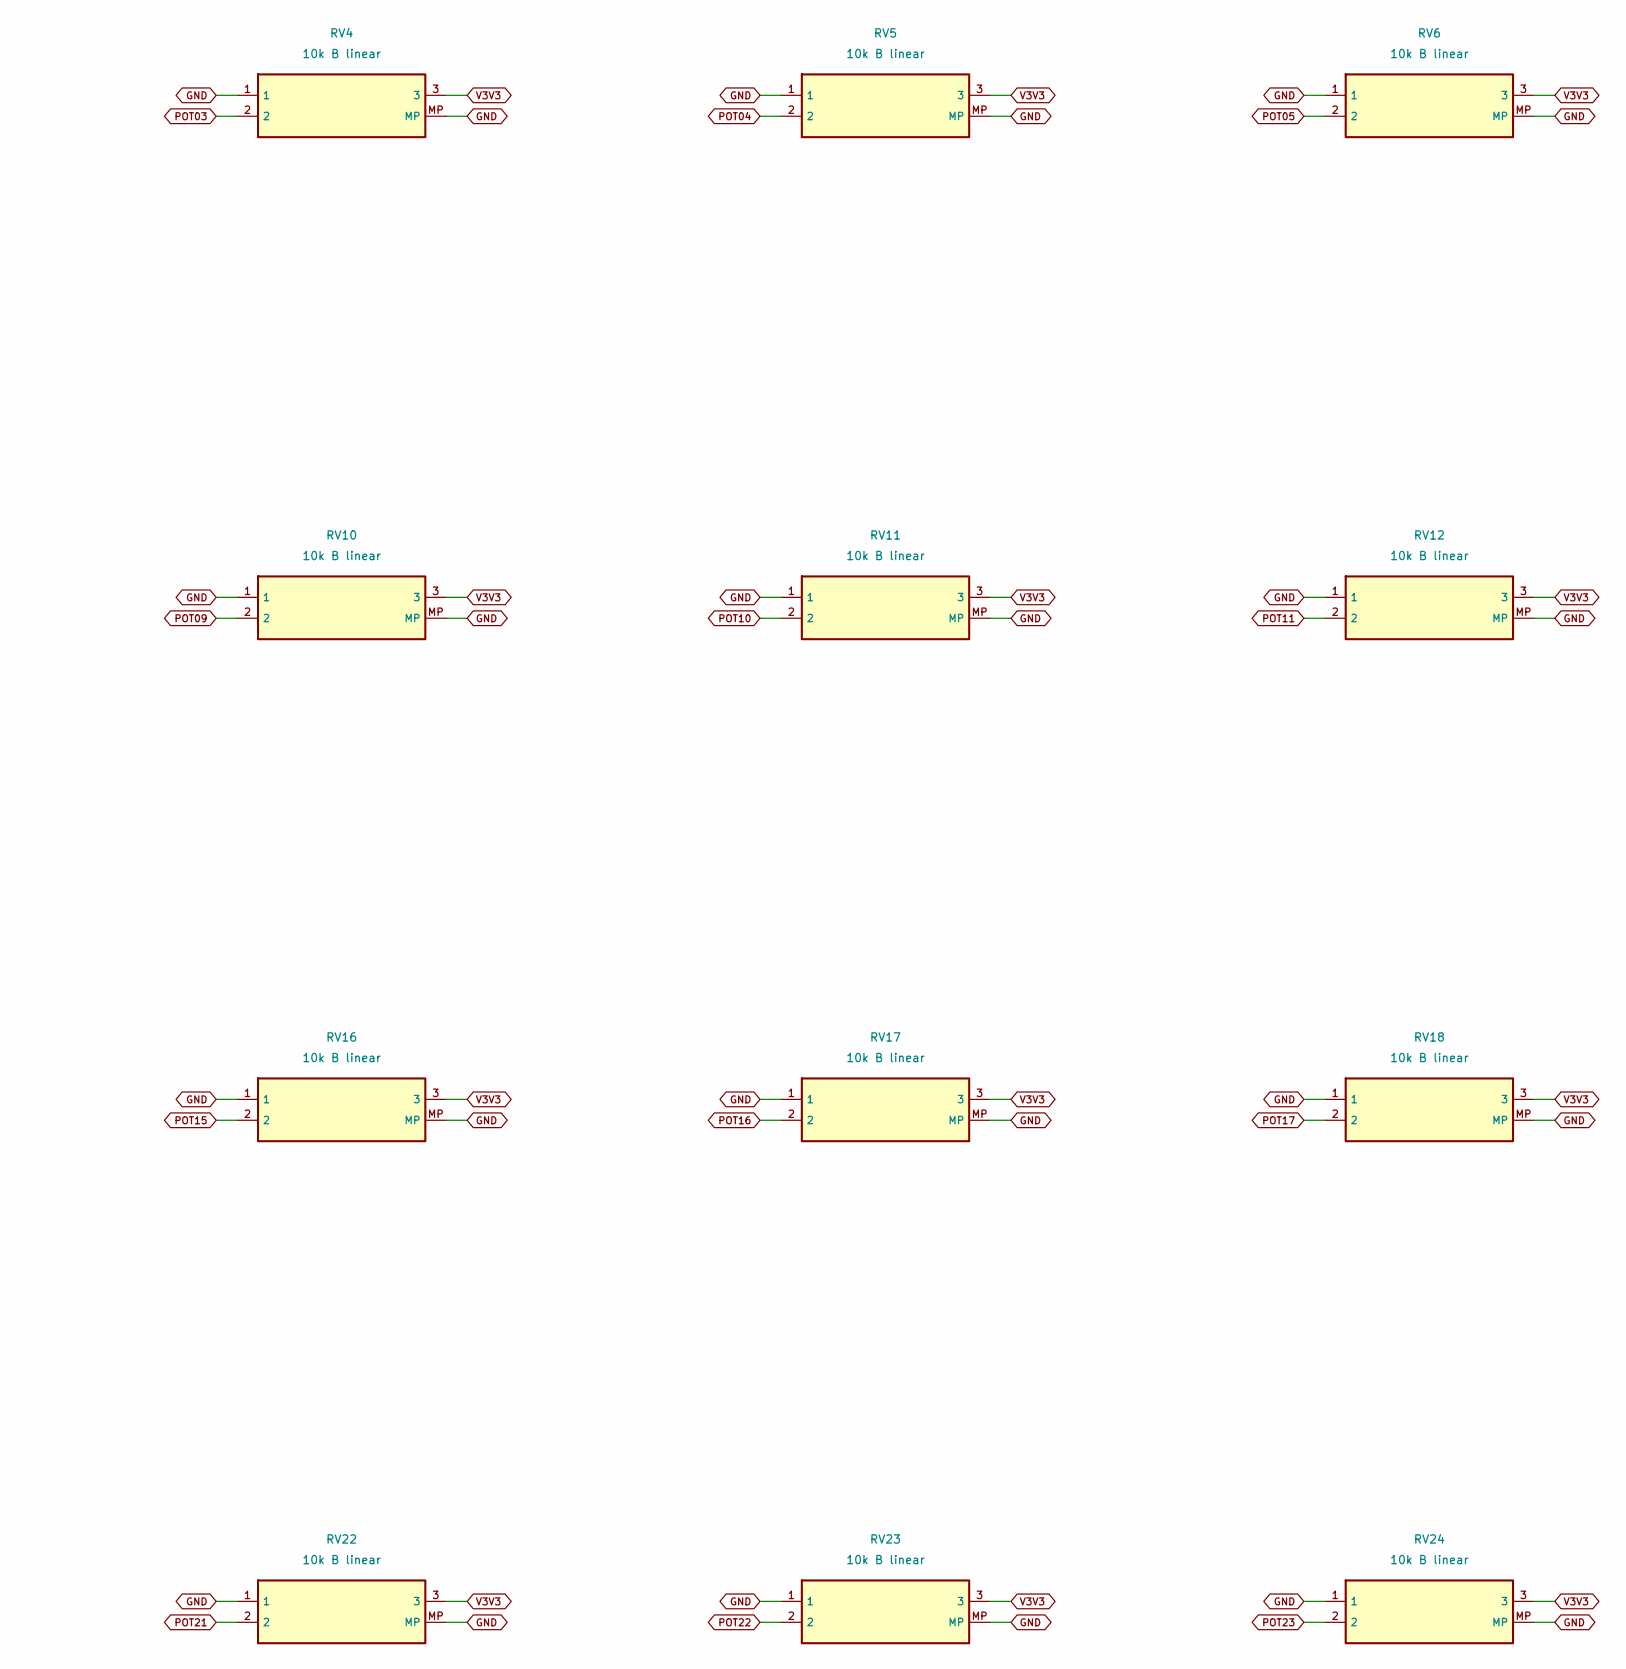
[picture p25: schematic panel_02.kicad_sch, VideoSynth R1 / panel / Potentiometers and multiplexers, part in row 1, column 2]

Parts:
RV1, RV2, RV3, RV4, RV5, RV6, RV7, RV8, RV9, RV10, RV11, RV12, RV13, RV14, RV15, RV16, RV17, RV18, RV19, RV20, RV21, RV22, RV23, RV24: 10k B linear; Potentiometer_Alps_RK09K_Single_Vertical

Connections:
GND: RV1.1, RV1.MP, RV2.1, RV2.MP, RV3.1, RV3.MP, RV4.1, RV4.MP, RV5.1, RV5.MP, RV6.1, RV6.MP, RV7.1, RV7.MP, RV8.1, RV8.MP, RV9.1, RV9.MP, RV10.1, RV10.MP, RV11.1, RV11.MP, RV12.1, RV12.MP, RV13.1, RV13.MP, RV14.1, RV14.MP, RV15.1, RV15.MP, RV16.1, RV16.MP, RV17.1, RV17.MP, RV18.1, RV18.MP, RV19.1, RV19.MP, RV20.1, RV20.MP, RV21.1, RV21.MP, RV22.1, RV22.MP, RV23.1, RV23.MP, RV24.1, RV24.MP; also elsewhere on the board
POT00: RV1.2; also elsewhere on the board
POT01: RV2.2; also elsewhere on the board
POT02: RV3.2; also elsewhere on the board
POT03: RV4.2; also elsewhere on the board
POT04: RV5.2; also elsewhere on the board
POT05: RV6.2; also elsewhere on the board
POT06: RV7.2; also elsewhere on the board
POT07: RV8.2; also elsewhere on the board
POT08: RV9.2; also elsewhere on the board
POT09: RV10.2; also elsewhere on the board
POT10: RV11.2; also elsewhere on the board
POT11: RV12.2; also elsewhere on the board
POT12: RV13.2; also elsewhere on the board
POT13: RV14.2; also elsewhere on the board
POT14: RV15.2; also elsewhere on the board
POT15: RV16.2; also elsewhere on the board
POT16: RV17.2; also elsewhere on the board
POT17: RV18.2; also elsewhere on the board
POT18: RV19.2; also elsewhere on the board
POT19: RV20.2; also elsewhere on the board
POT20: RV21.2; also elsewhere on the board
POT21: RV22.2; also elsewhere on the board
POT22: RV23.2; also elsewhere on the board
POT23: RV24.2; also elsewhere on the board
V3V3: RV1.3, RV2.3, RV3.3, RV4.3, RV5.3, RV6.3, RV7.3, RV8.3, RV9.3, RV10.3, RV11.3, RV12.3, RV13.3, RV14.3, RV15.3, RV16.3, RV17.3, RV18.3, RV19.3, RV20.3, RV21.3, RV22.3, RV23.3, RV24.3; also elsewhere on the board

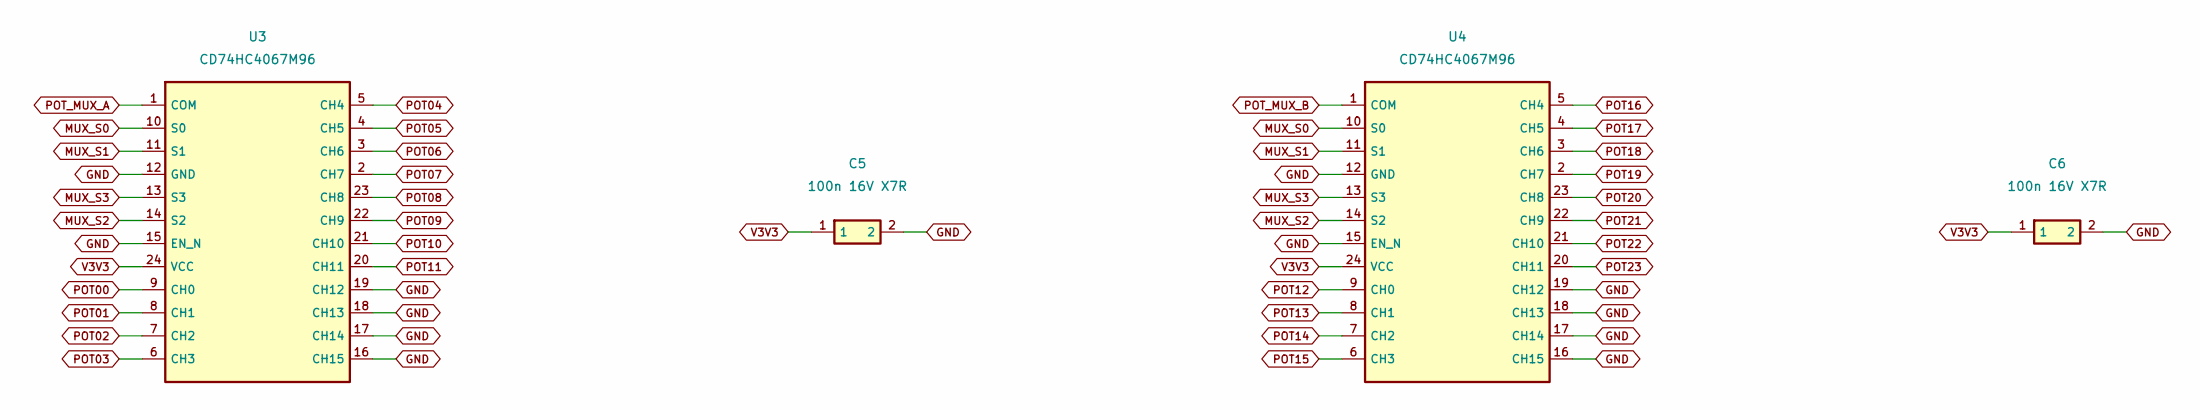
[picture p26: schematic panel_03.kicad_sch, VideoSynth R1 / panel / Potentiometers and multiplexers]

Parts:
C5, C6: 100n 16V X7R; C_0805_2012Metric
U3, U4: CD74HC4067M96; SOIC-24W_7.5x15.4mm_P1.27mm

Connections:
GND: C5.2, C6.2, U3.12 (GND), U3.15 (EN_N), U3.16 (CH15), U3.17 (CH14), U3.18 (CH13), U3.19 (CH12), U4.12 (GND), U4.15 (EN_N), U4.16 (CH15), U4.17 (CH14), U4.18 (CH13), U4.19 (CH12); also elsewhere on the board
MUX_S0: U3.10 (S0), U4.10 (S0); also elsewhere on the board
MUX_S1: U3.11 (S1), U4.11 (S1); also elsewhere on the board
MUX_S2: U3.14 (S2), U4.14 (S2); also elsewhere on the board
MUX_S3: U3.13 (S3), U4.13 (S3); also elsewhere on the board
POT00: U3.9 (CH0); also elsewhere on the board
POT01: U3.8 (CH1); also elsewhere on the board
POT02: U3.7 (CH2); also elsewhere on the board
POT03: U3.6 (CH3); also elsewhere on the board
POT04: U3.5 (CH4); also elsewhere on the board
POT05: U3.4 (CH5); also elsewhere on the board
POT06: U3.3 (CH6); also elsewhere on the board
POT07: U3.2 (CH7); also elsewhere on the board
POT08: U3.23 (CH8); also elsewhere on the board
POT09: U3.22 (CH9); also elsewhere on the board
POT10: U3.21 (CH10); also elsewhere on the board
POT11: U3.20 (CH11); also elsewhere on the board
POT12: U4.9 (CH0); also elsewhere on the board
POT13: U4.8 (CH1); also elsewhere on the board
POT14: U4.7 (CH2); also elsewhere on the board
POT15: U4.6 (CH3); also elsewhere on the board
POT16: U4.5 (CH4); also elsewhere on the board
POT17: U4.4 (CH5); also elsewhere on the board
POT18: U4.3 (CH6); also elsewhere on the board
POT19: U4.2 (CH7); also elsewhere on the board
POT20: U4.23 (CH8); also elsewhere on the board
POT21: U4.22 (CH9); also elsewhere on the board
POT22: U4.21 (CH10); also elsewhere on the board
POT23: U4.20 (CH11); also elsewhere on the board
POT_MUX_A: U3.1 (COM); also elsewhere on the board
POT_MUX_B: U4.1 (COM); also elsewhere on the board
V3V3: C5.1, C6.1, U3.24 (VCC), U4.24 (VCC); also elsewhere on the board

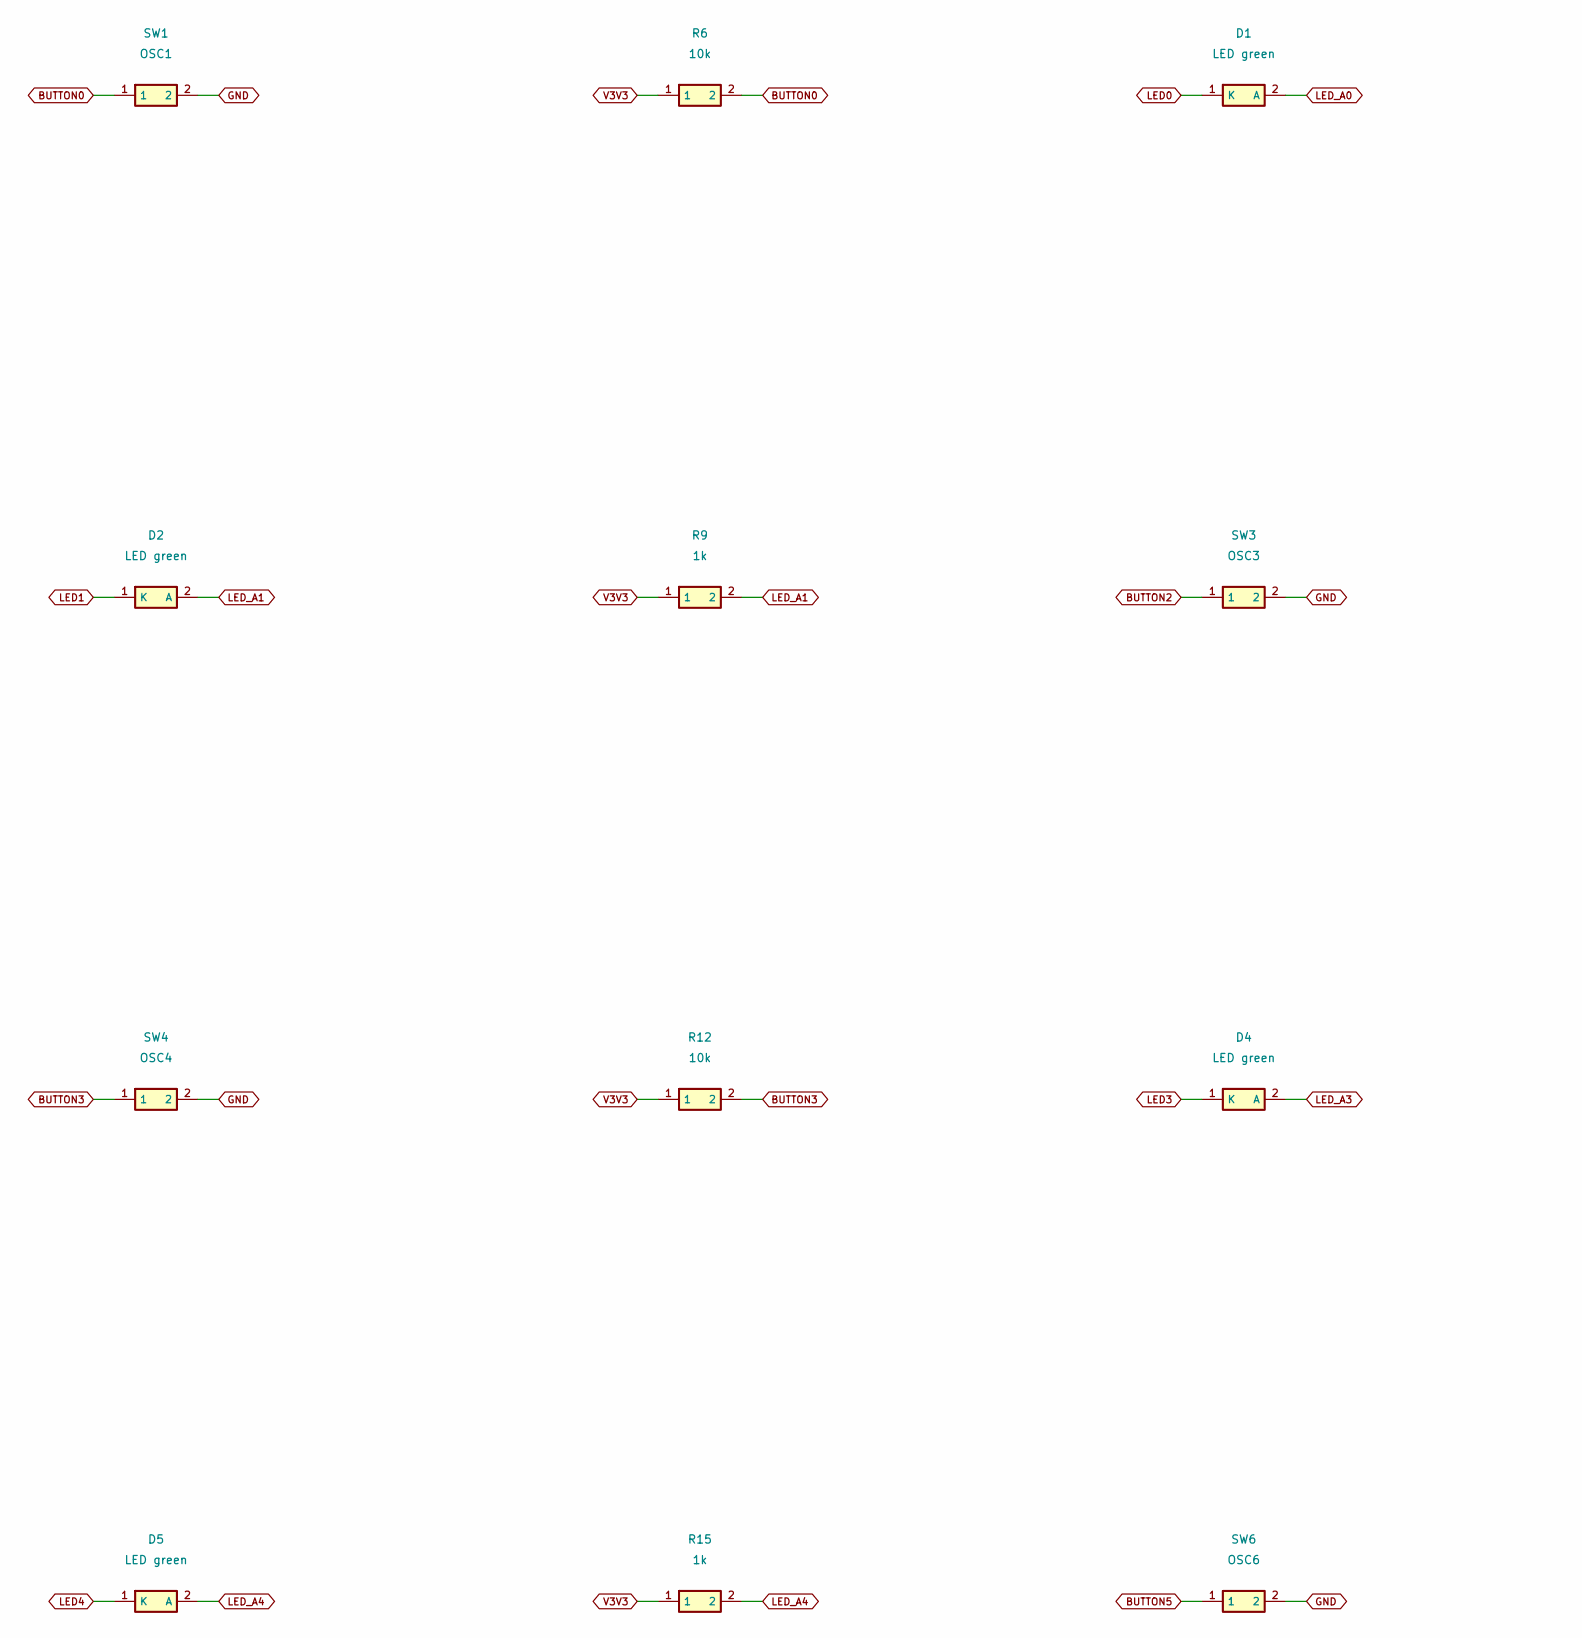
[picture p27: schematic panel_04.kicad_sch, VideoSynth R1 / panel / Buttons encoders and display, part in row 1, column 1]

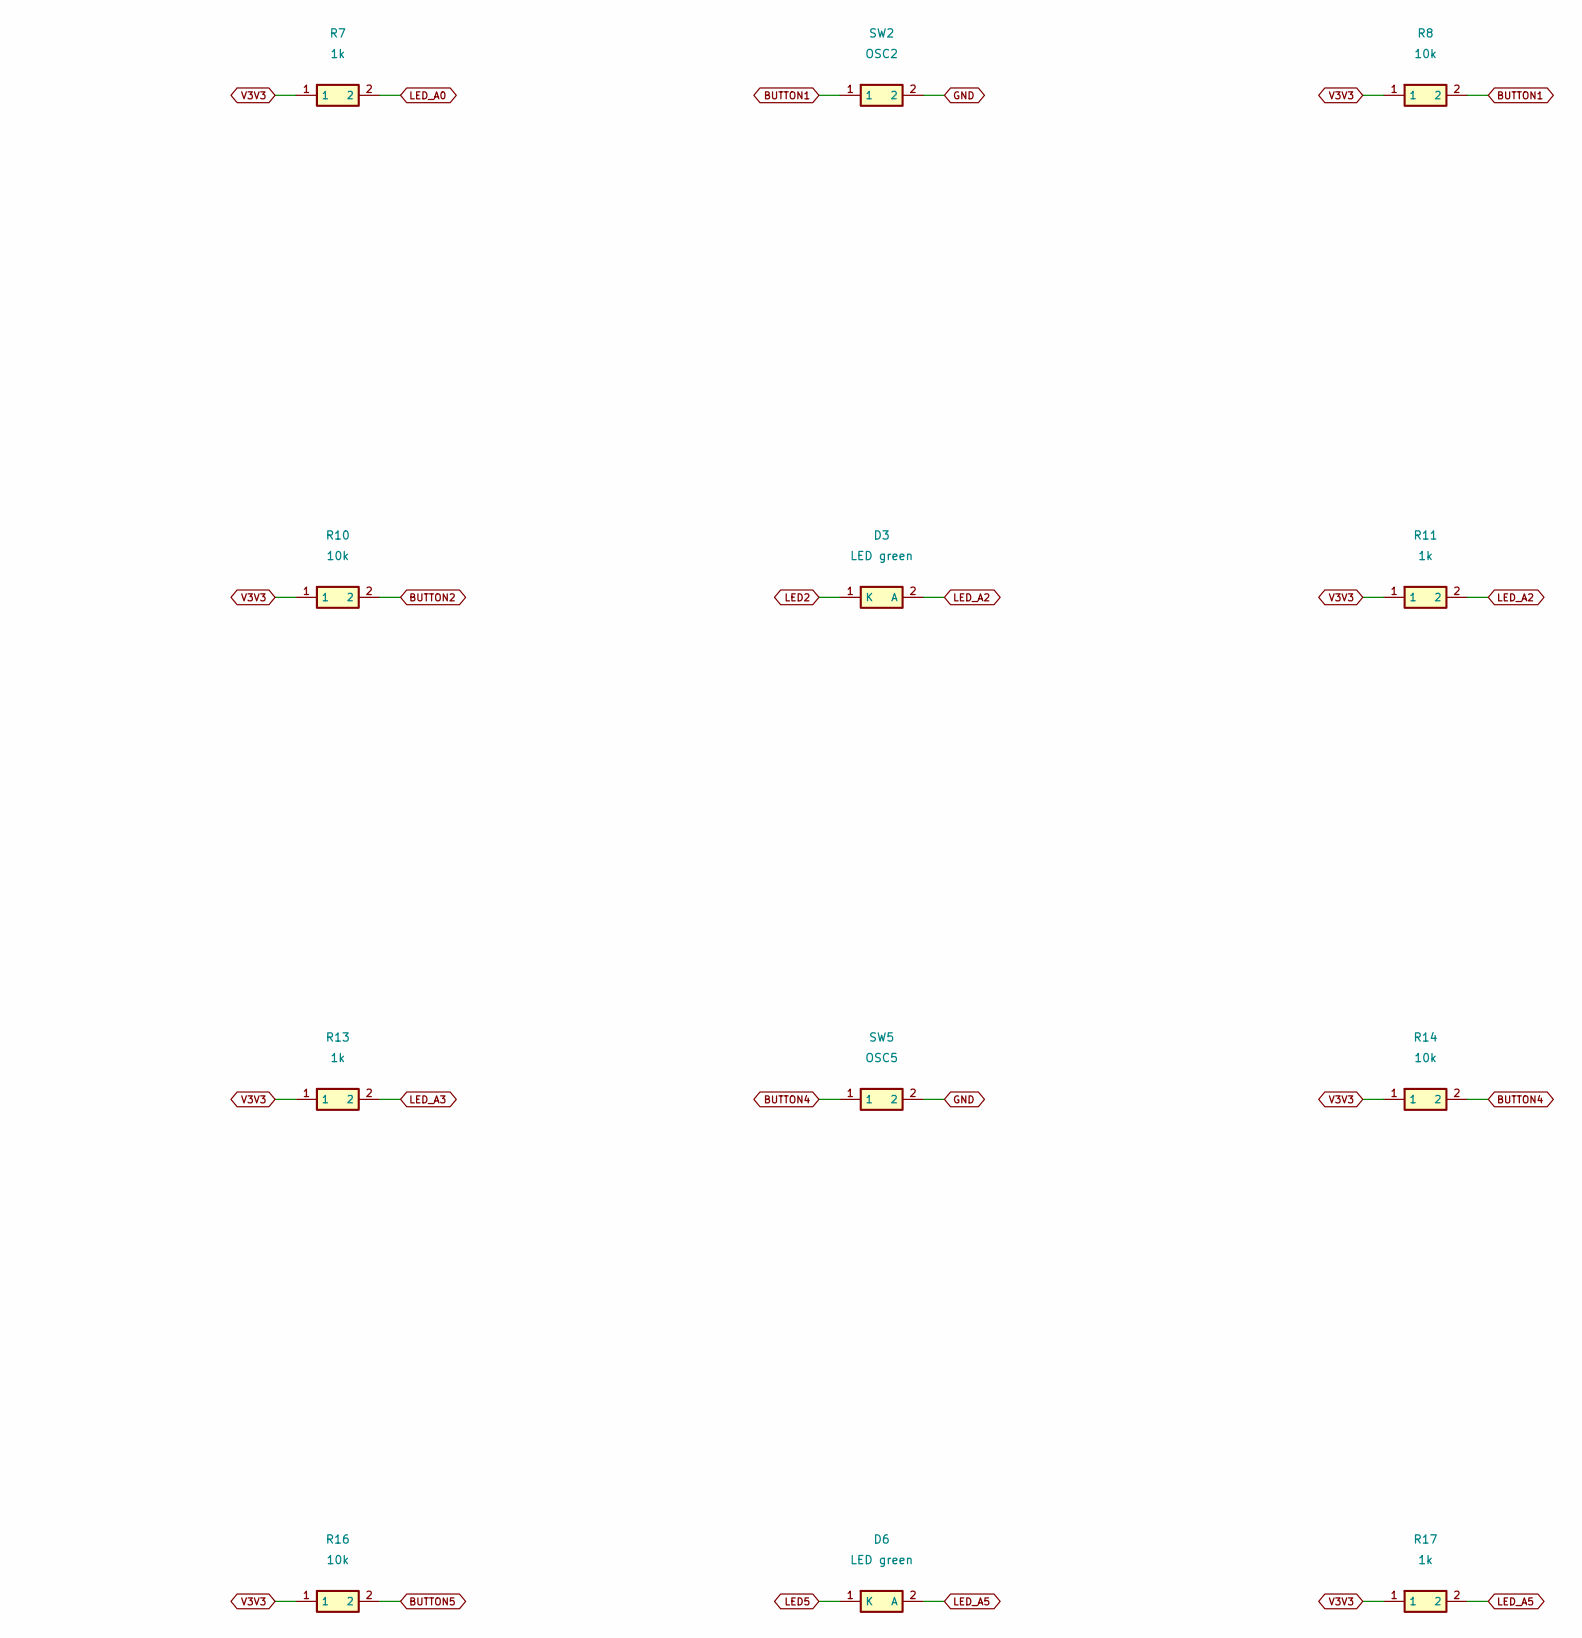
[picture p28: schematic panel_04.kicad_sch, VideoSynth R1 / panel / Buttons encoders and display, part in row 1, column 2]

Parts:
D1, D2, D3, D4, D5, D6: LED green; LED_0603_1608Metric
R6, R8, R10, R12, R14, R16: 10k; R_0805_2012Metric
R7, R9, R11, R13, R15, R17: 1k; R_0805_2012Metric
SW1: OSC1; SW_PUSH_6mm
SW2: OSC2; SW_PUSH_6mm
SW3: OSC3; SW_PUSH_6mm
SW4: OSC4; SW_PUSH_6mm
SW5: OSC5; SW_PUSH_6mm
SW6: OSC6; SW_PUSH_6mm

Connections:
BUTTON0: R6.2, SW1.1; also elsewhere on the board
BUTTON1: R8.2, SW2.1; also elsewhere on the board
BUTTON2: R10.2, SW3.1; also elsewhere on the board
BUTTON3: R12.2, SW4.1; also elsewhere on the board
BUTTON4: R14.2, SW5.1; also elsewhere on the board
BUTTON5: R16.2, SW6.1; also elsewhere on the board
GND: SW1.2, SW2.2, SW3.2, SW4.2, SW5.2, SW6.2; also elsewhere on the board
LED0: D1.1 (K); also elsewhere on the board
LED1: D2.1 (K); also elsewhere on the board
LED2: D3.1 (K); also elsewhere on the board
LED3: D4.1 (K); also elsewhere on the board
LED4: D5.1 (K); also elsewhere on the board
LED5: D6.1 (K); also elsewhere on the board
LED_A0: D1.2 (A), R7.2
LED_A1: D2.2 (A), R9.2
LED_A2: D3.2 (A), R11.2
LED_A3: D4.2 (A), R13.2
LED_A4: D5.2 (A), R15.2
LED_A5: D6.2 (A), R17.2
V3V3: R6.1, R7.1, R8.1, R9.1, R10.1, R11.1, R12.1, R13.1, R14.1, R15.1, R16.1, R17.1; also elsewhere on the board
