Guadonna/VideoSynth/hardware/kicad/panel/videosynth_panel.kicad_pcb

## KiCad design hardware/kicad/panel/videosynth_panel.kicad_pcb (continued)

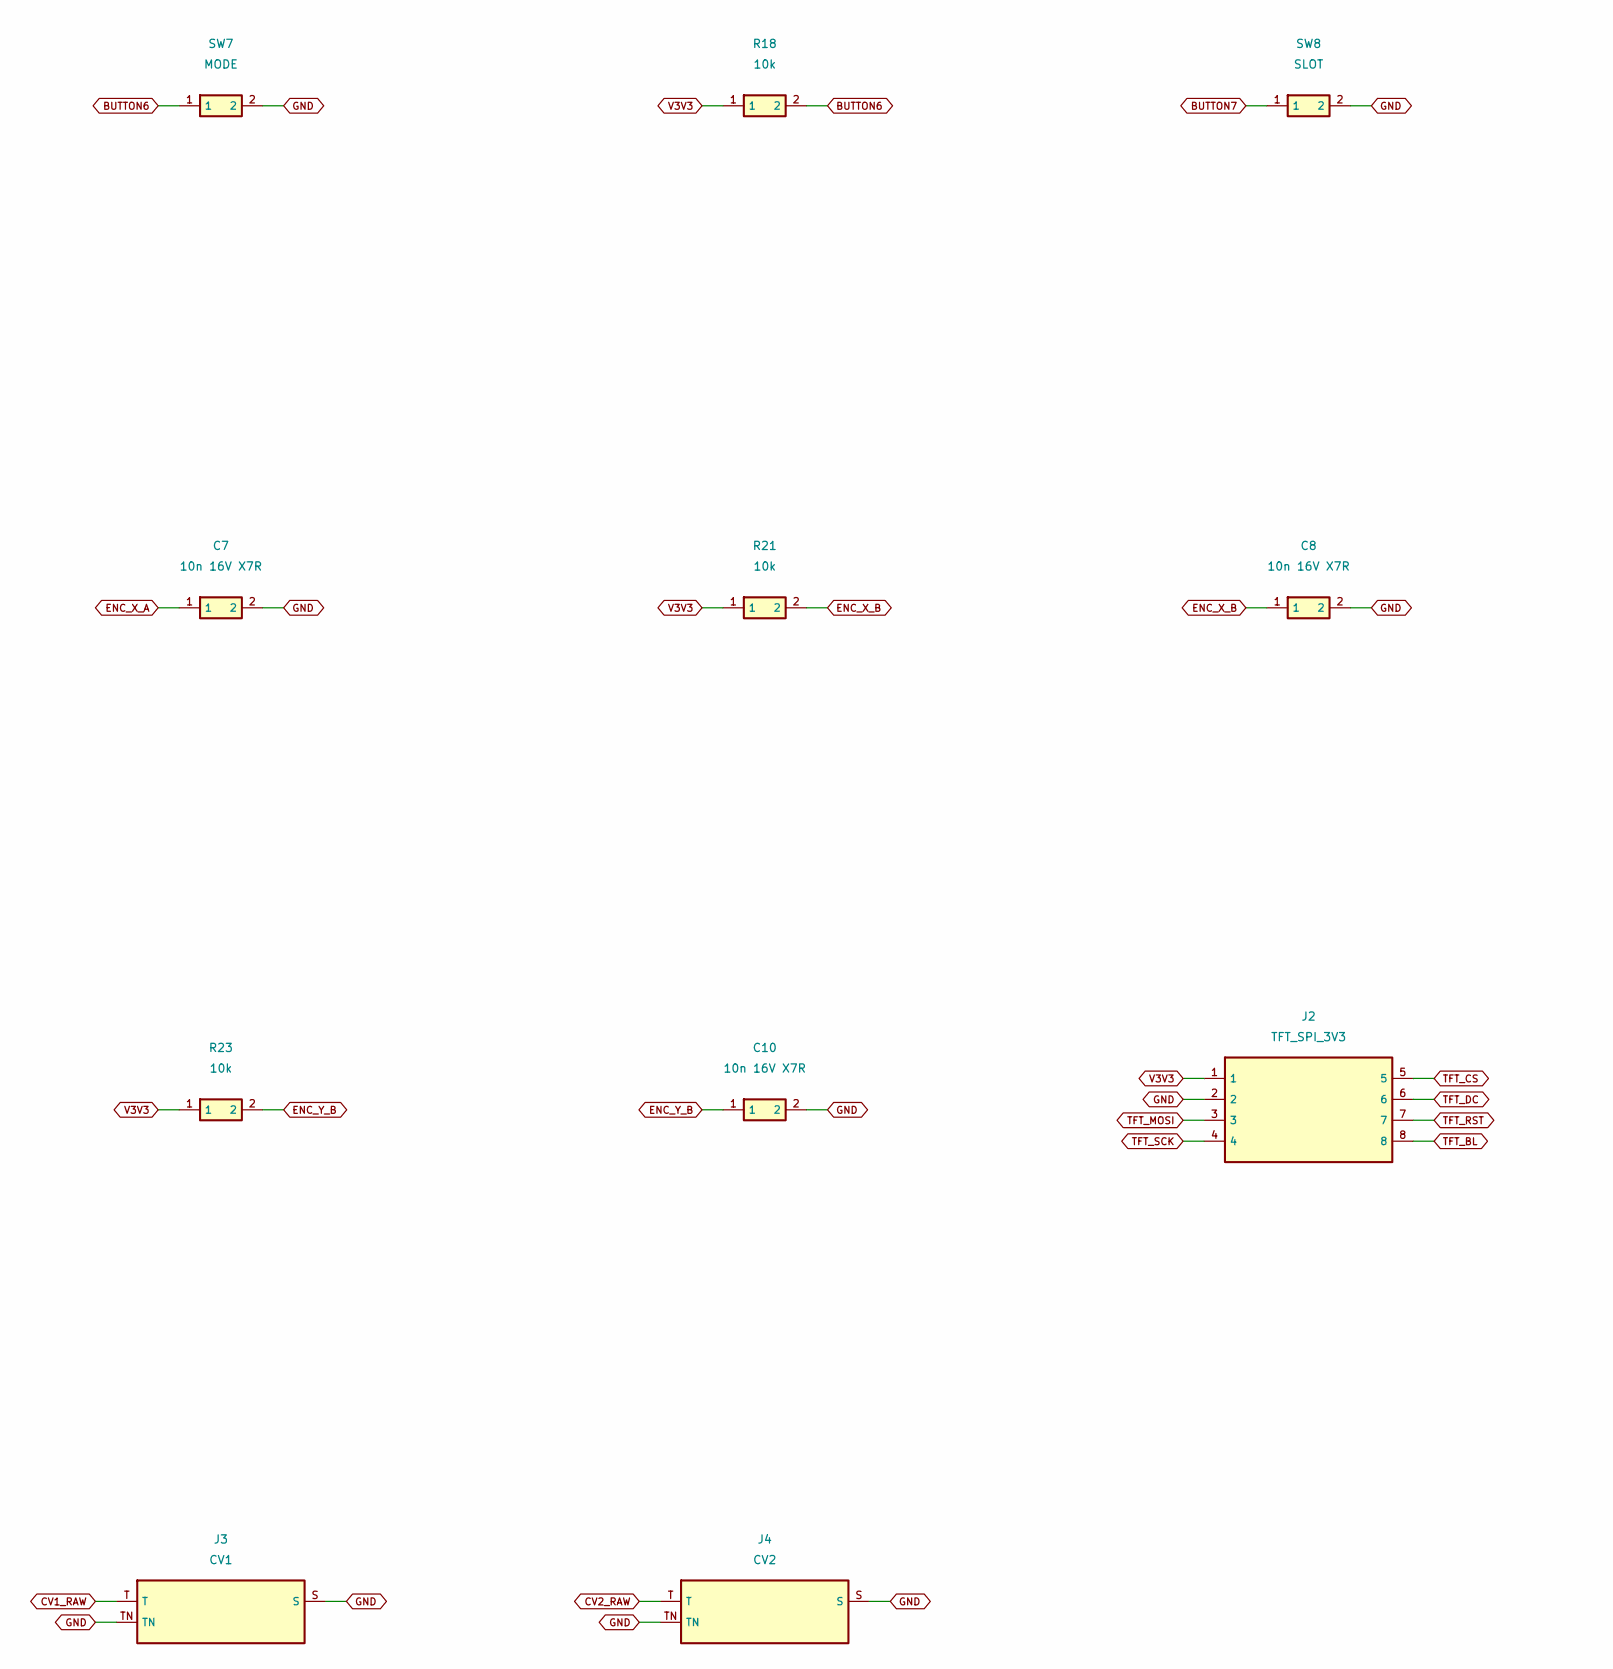
[picture p29: schematic panel_05.kicad_sch, VideoSynth R1 / panel / Buttons encoders and display, part in row 1, column 1]

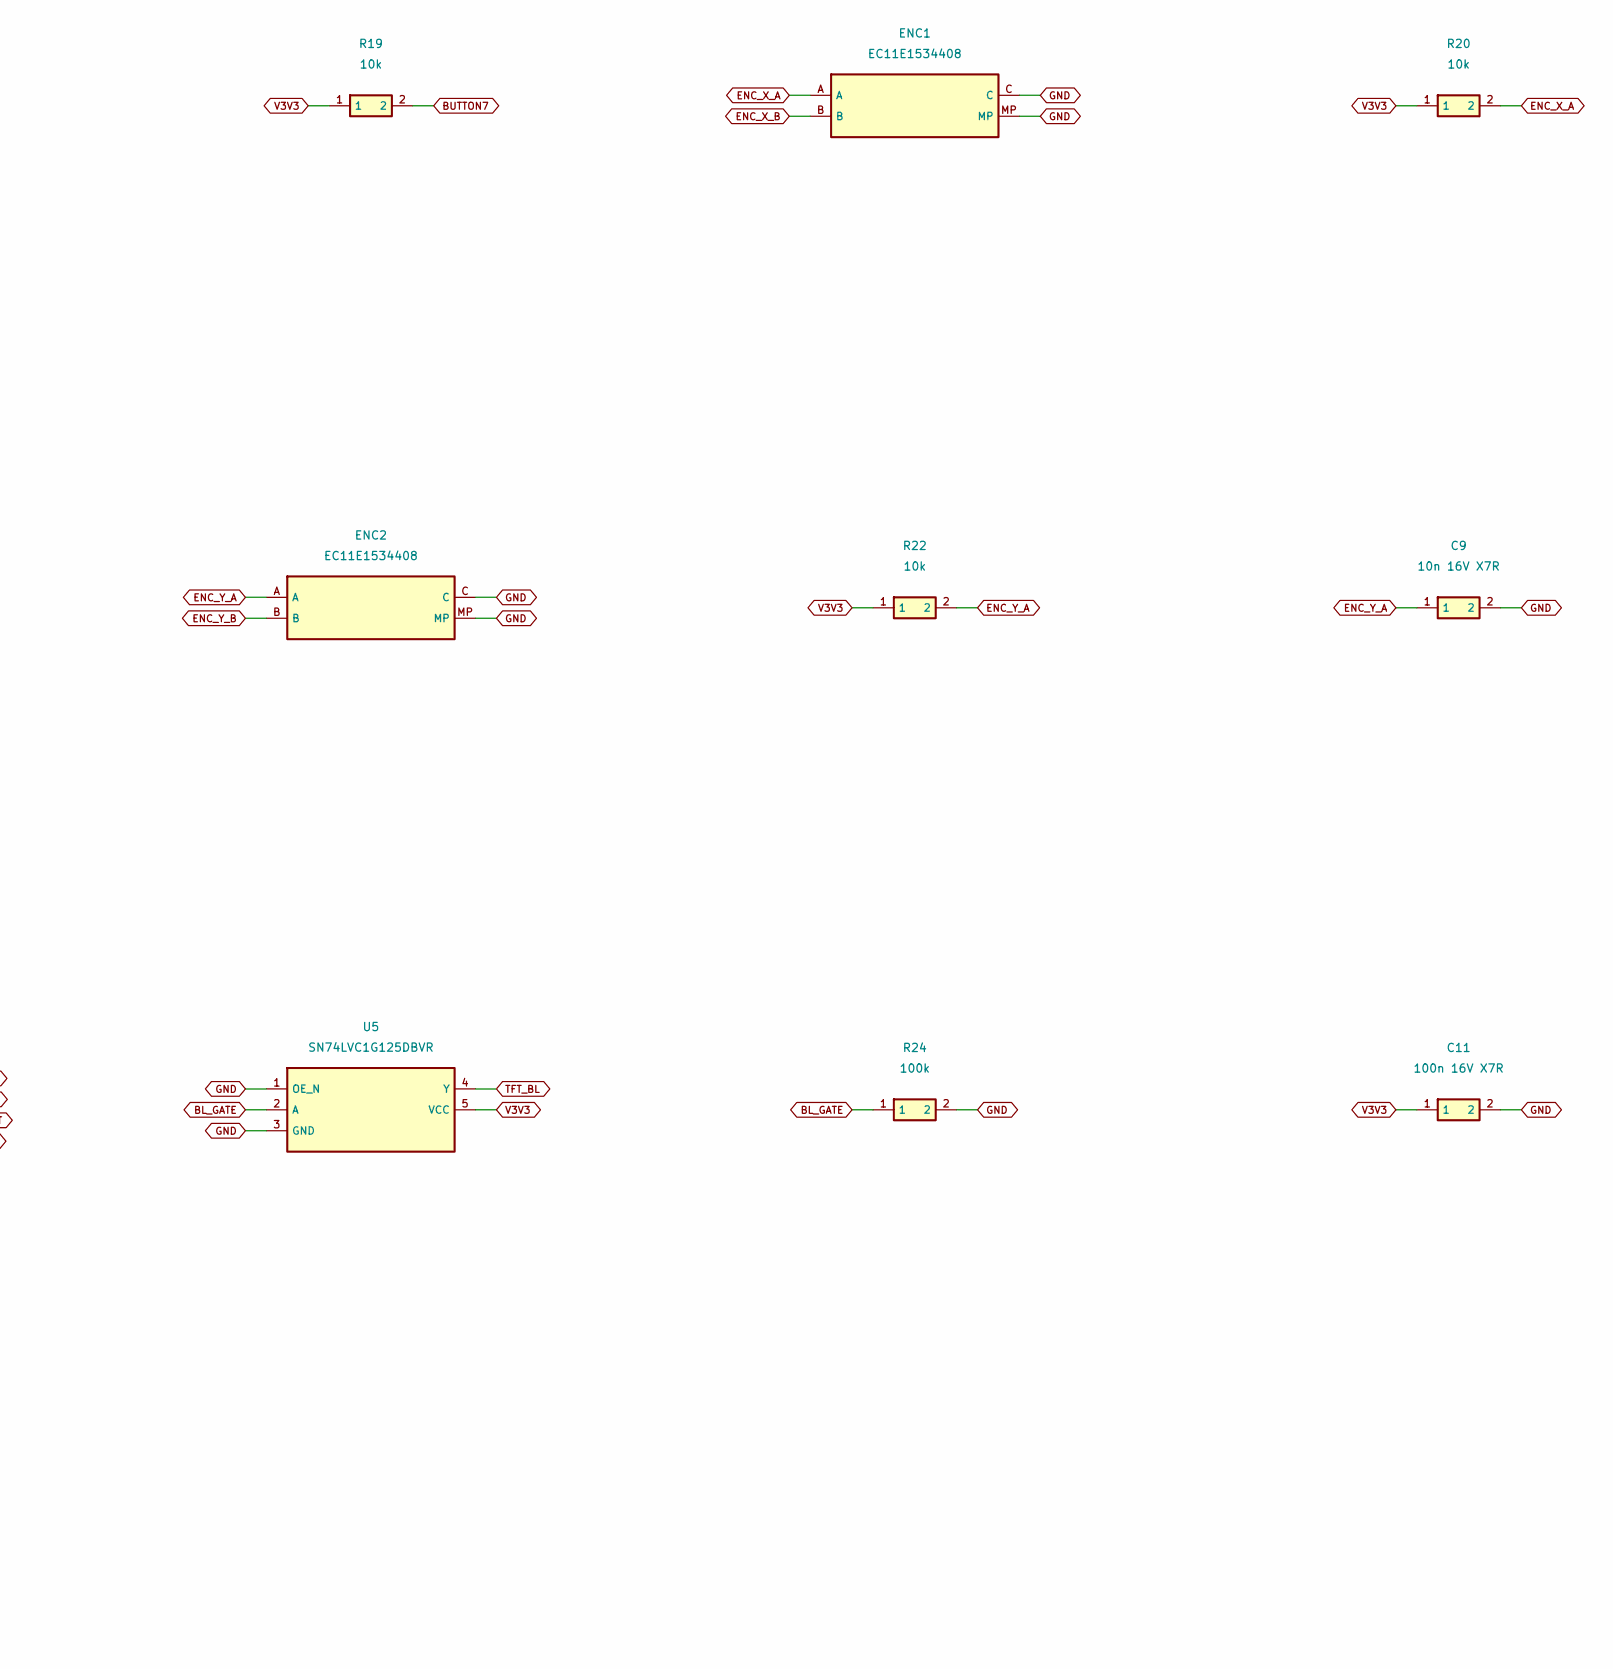
[picture p30: schematic panel_05.kicad_sch, VideoSynth R1 / panel / Buttons encoders and display, part in row 1, column 2]

Parts:
C7, C8, C9, C10: 10n 16V X7R; C_0805_2012Metric
C11: 100n 16V X7R; C_0805_2012Metric
ENC1, ENC2: EC11E1534408; RotaryEncoder_Alps_EC11E_Vertical_H20mm
J2: TFT_SPI_3V3; PinHeader_1x08_P2.54mm_Vertical
J3: CV1; Jack_3.5mm_QingPu_WQP-PJ398SM_Vertical_CircularHoles
J4: CV2; Jack_3.5mm_QingPu_WQP-PJ398SM_Vertical_CircularHoles
R18, R19, R20, R21, R22, R23: 10k; R_0805_2012Metric
R24: 100k; R_0805_2012Metric
SW7: MODE; SW_PUSH_6mm
SW8: SLOT; SW_PUSH_6mm
U5: SN74LVC1G125DBVR; SOT-23-5

Connections:
BL_GATE: R24.1, U5.2 (A); also elsewhere on the board
BUTTON6: R18.2, SW7.1; also elsewhere on the board
BUTTON7: R19.2, SW8.1; also elsewhere on the board
CV1_RAW: J3.T; also elsewhere on the board
CV2_RAW: J4.T; also elsewhere on the board
ENC_X_A: C7.1, ENC1.A, R20.2; also elsewhere on the board
ENC_X_B: C8.1, ENC1.B, R21.2; also elsewhere on the board
ENC_Y_A: C9.1, ENC2.A, R22.2; also elsewhere on the board
ENC_Y_B: C10.1, ENC2.B, R23.2; also elsewhere on the board
GND: C7.2, C8.2, C9.2, C10.2, C11.2, ENC1.C, ENC1.MP, ENC2.C, ENC2.MP, J2.2, J3.S, J3.TN, J4.S, J4.TN, R24.2, SW7.2, SW8.2, U5.1 (OE_N), U5.3 (GND); also elsewhere on the board
TFT_BL: J2.8, U5.4 (Y)
TFT_CS: J2.5; also elsewhere on the board
TFT_DC: J2.6; also elsewhere on the board
TFT_MOSI: J2.3; also elsewhere on the board
TFT_RST: J2.7; also elsewhere on the board
TFT_SCK: J2.4; also elsewhere on the board
V3V3: C11.1, J2.1, R18.1, R19.1, R20.1, R21.1, R22.1, R23.1, U5.5 (VCC); also elsewhere on the board

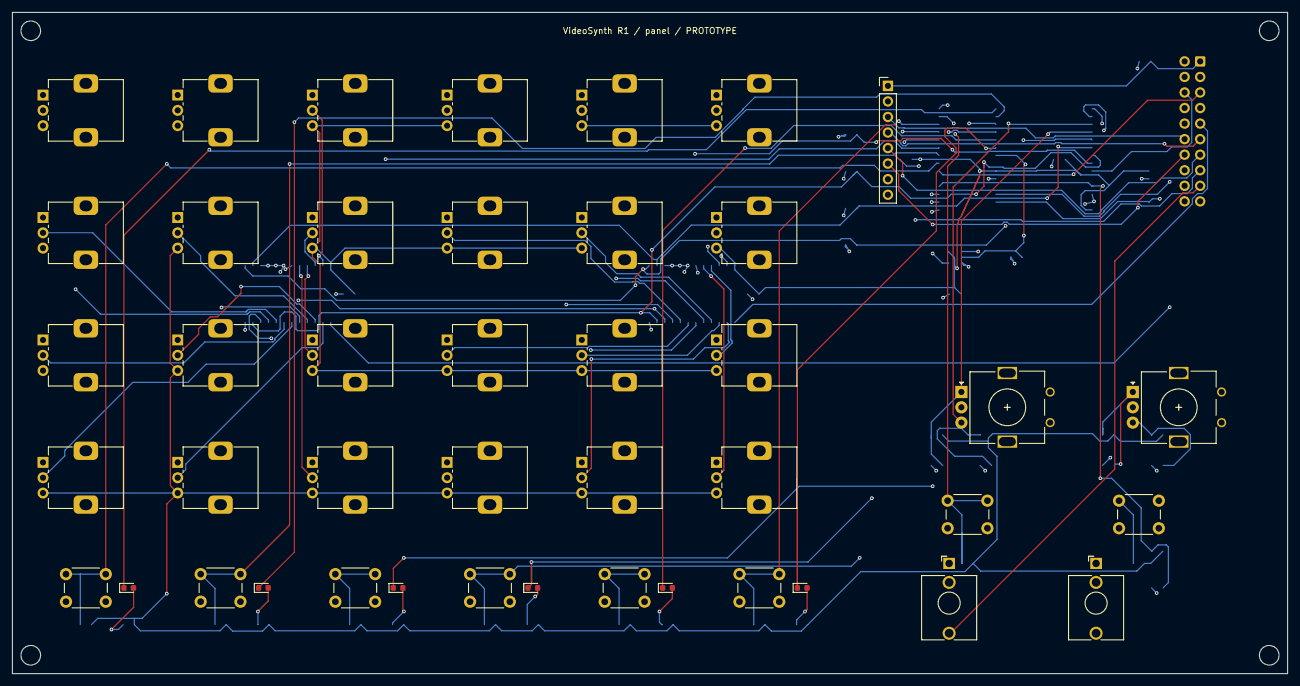
[picture p31: board videosynth_panel.kicad_pcb from above]

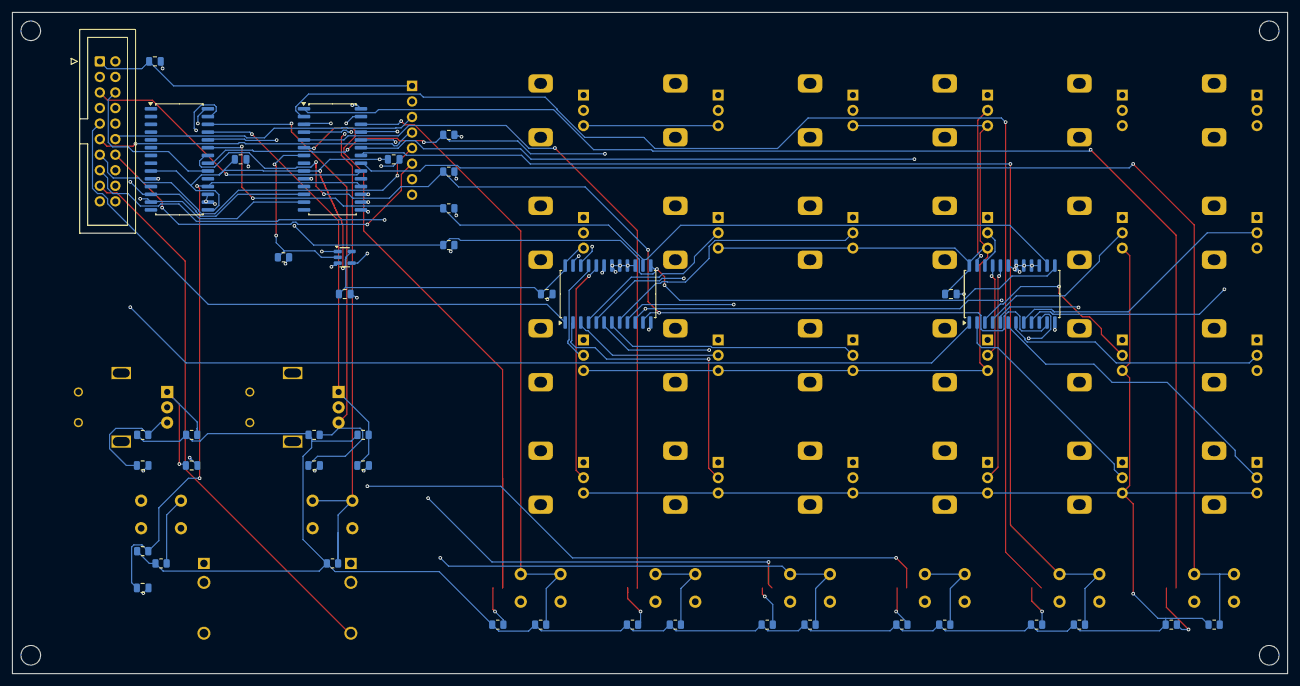
[picture p32: board videosynth_panel.kicad_pcb from below]

Board: 4 copper layers, 208.3 x 108.0 mm, 88 parts (41 on the bottom side), 70 nets.

Other parts of the board:
H1, H2, H3, H4: MountingHole_3.2mm_M3
