Guadonna/VideoSynth/hardware/kicad/core/videosynth_core.kicad_pcb

## KiCad design hardware/kicad/core/videosynth_core.kicad_pcb (2026-10-23)

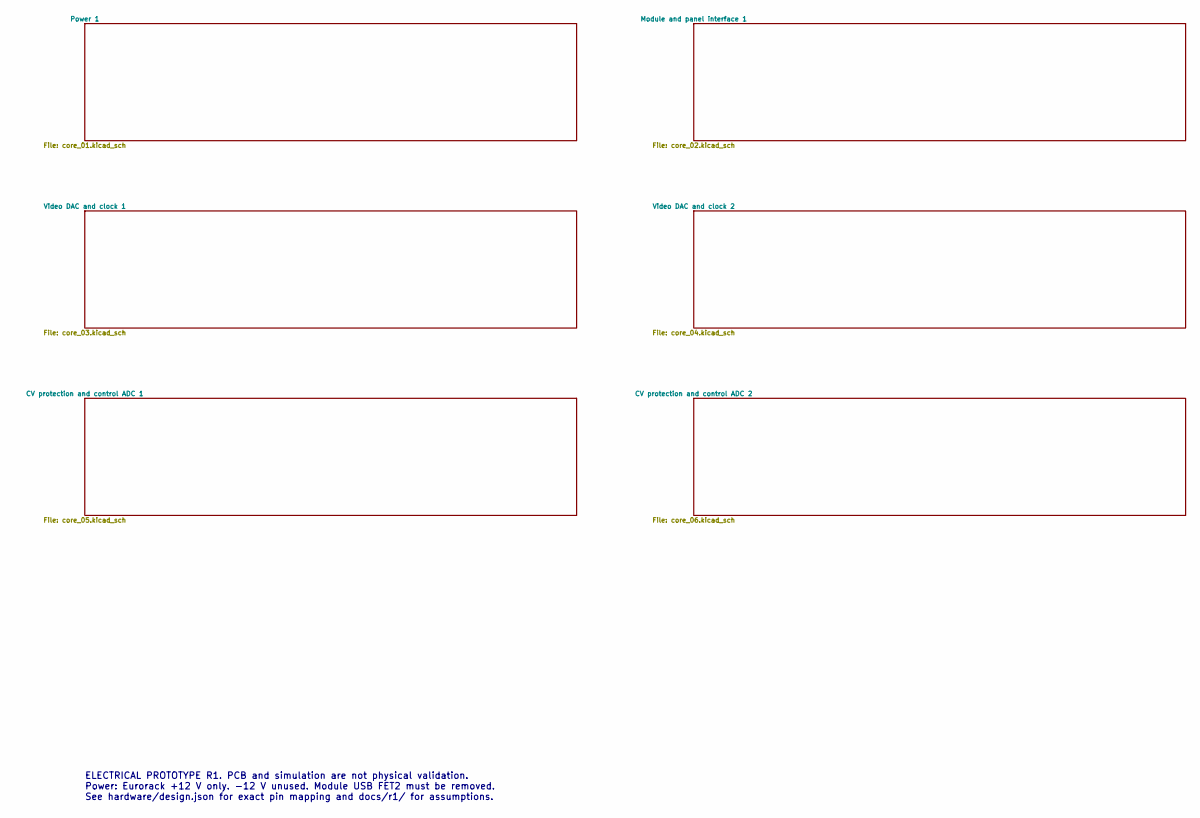
[picture p33: schematic videosynth_core.kicad_sch, VideoSynth R1 - core]

Notes on the sheet:
ELECTRICAL PROTOTYPE R1. PCB and simulation are not physical validation. Power: Eurorack +12 V only. -12 V unused. Module USB FET2 must be removed. See hardware/design.json for exact pin mapping and docs/r1/ for assumptions.

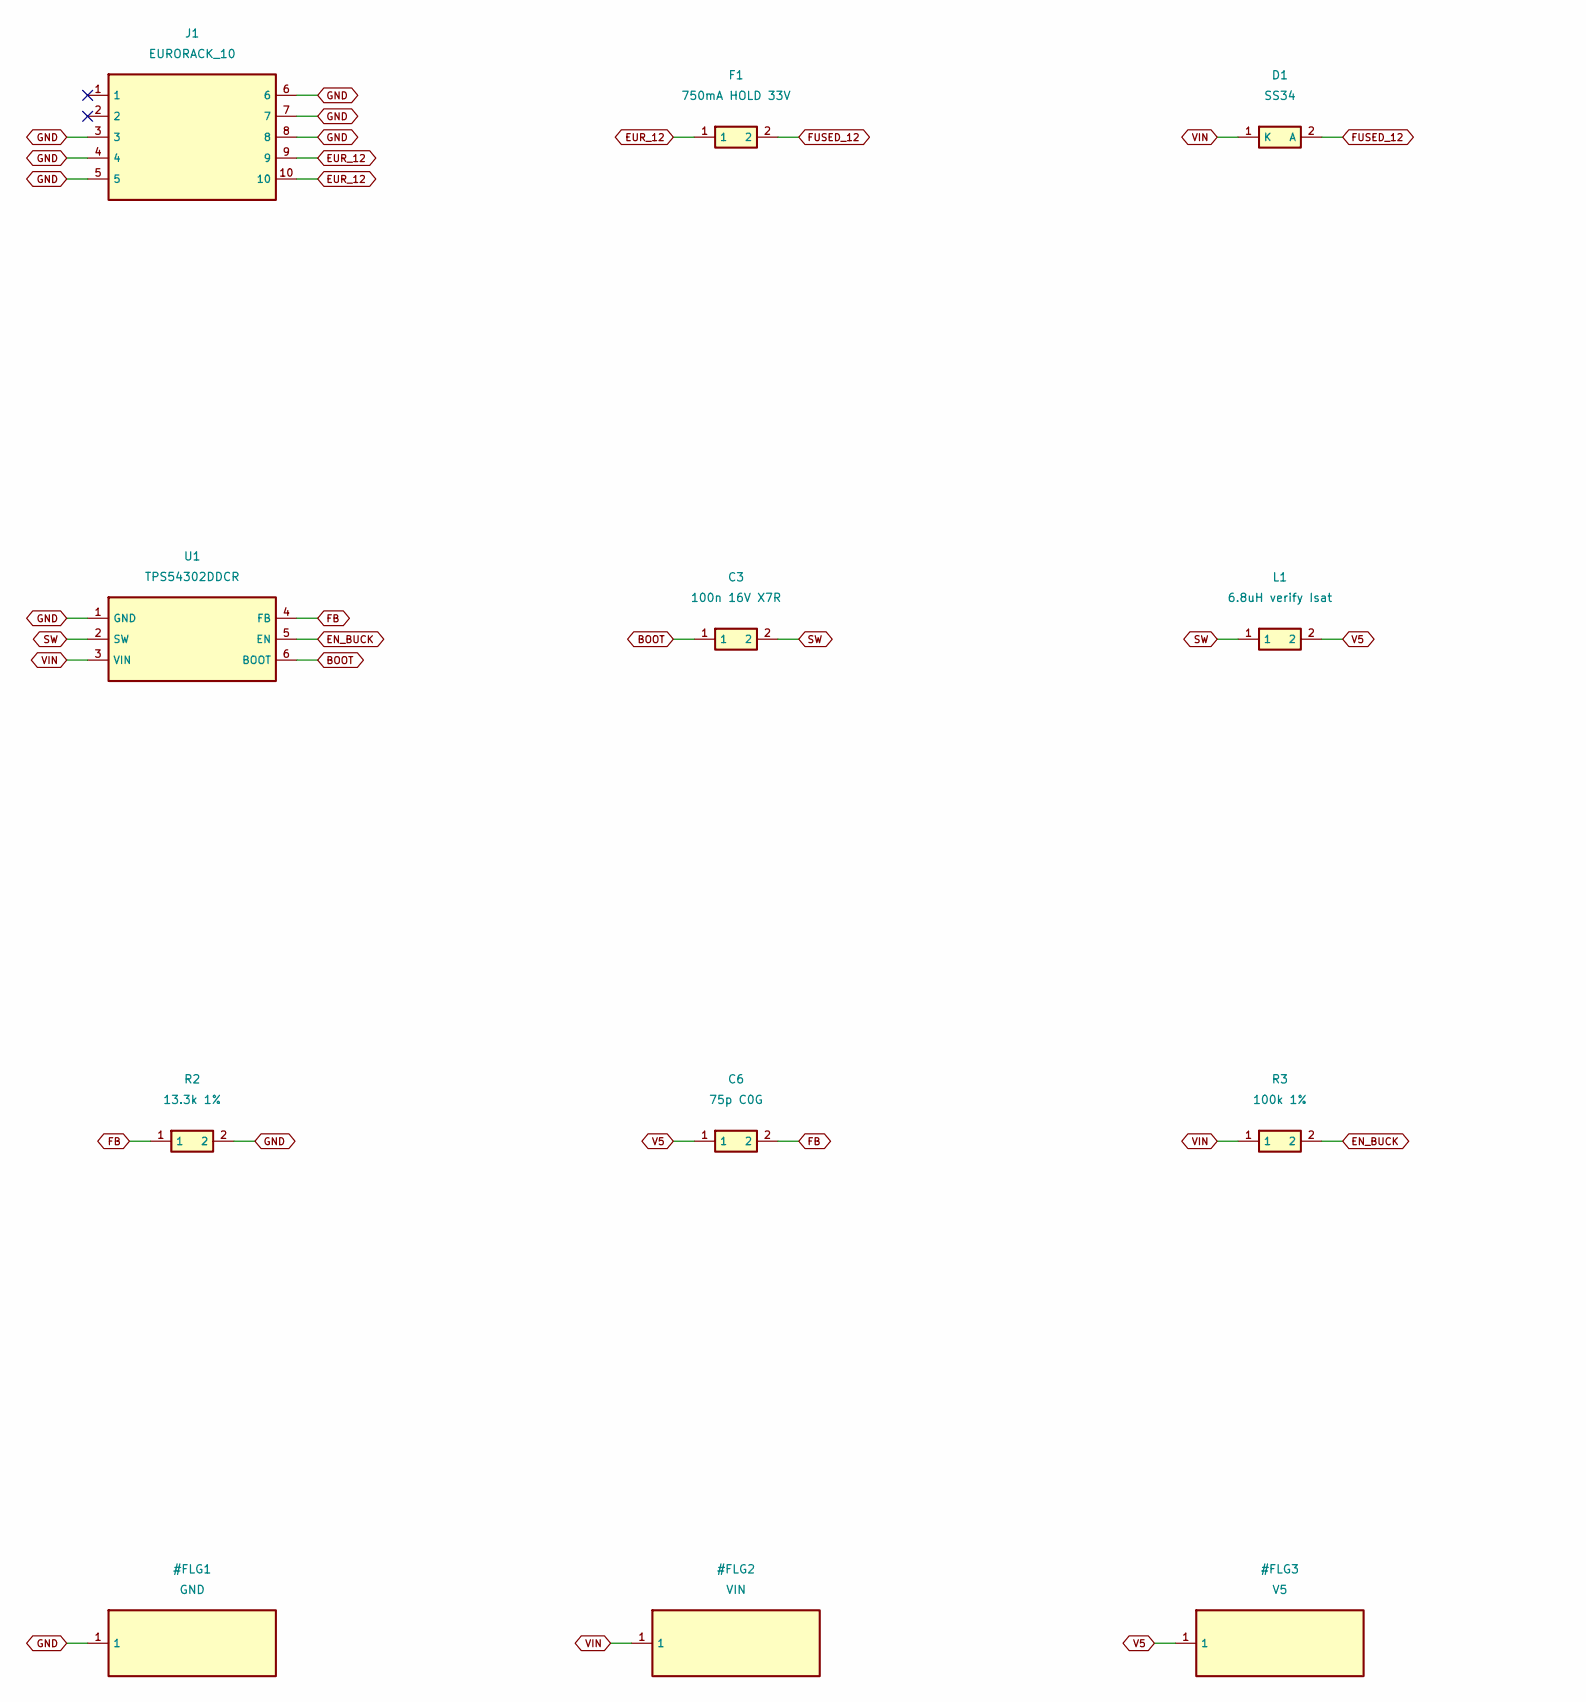
[picture p34: schematic core_01.kicad_sch, VideoSynth R1 / core / Power, part in row 1, column 1]

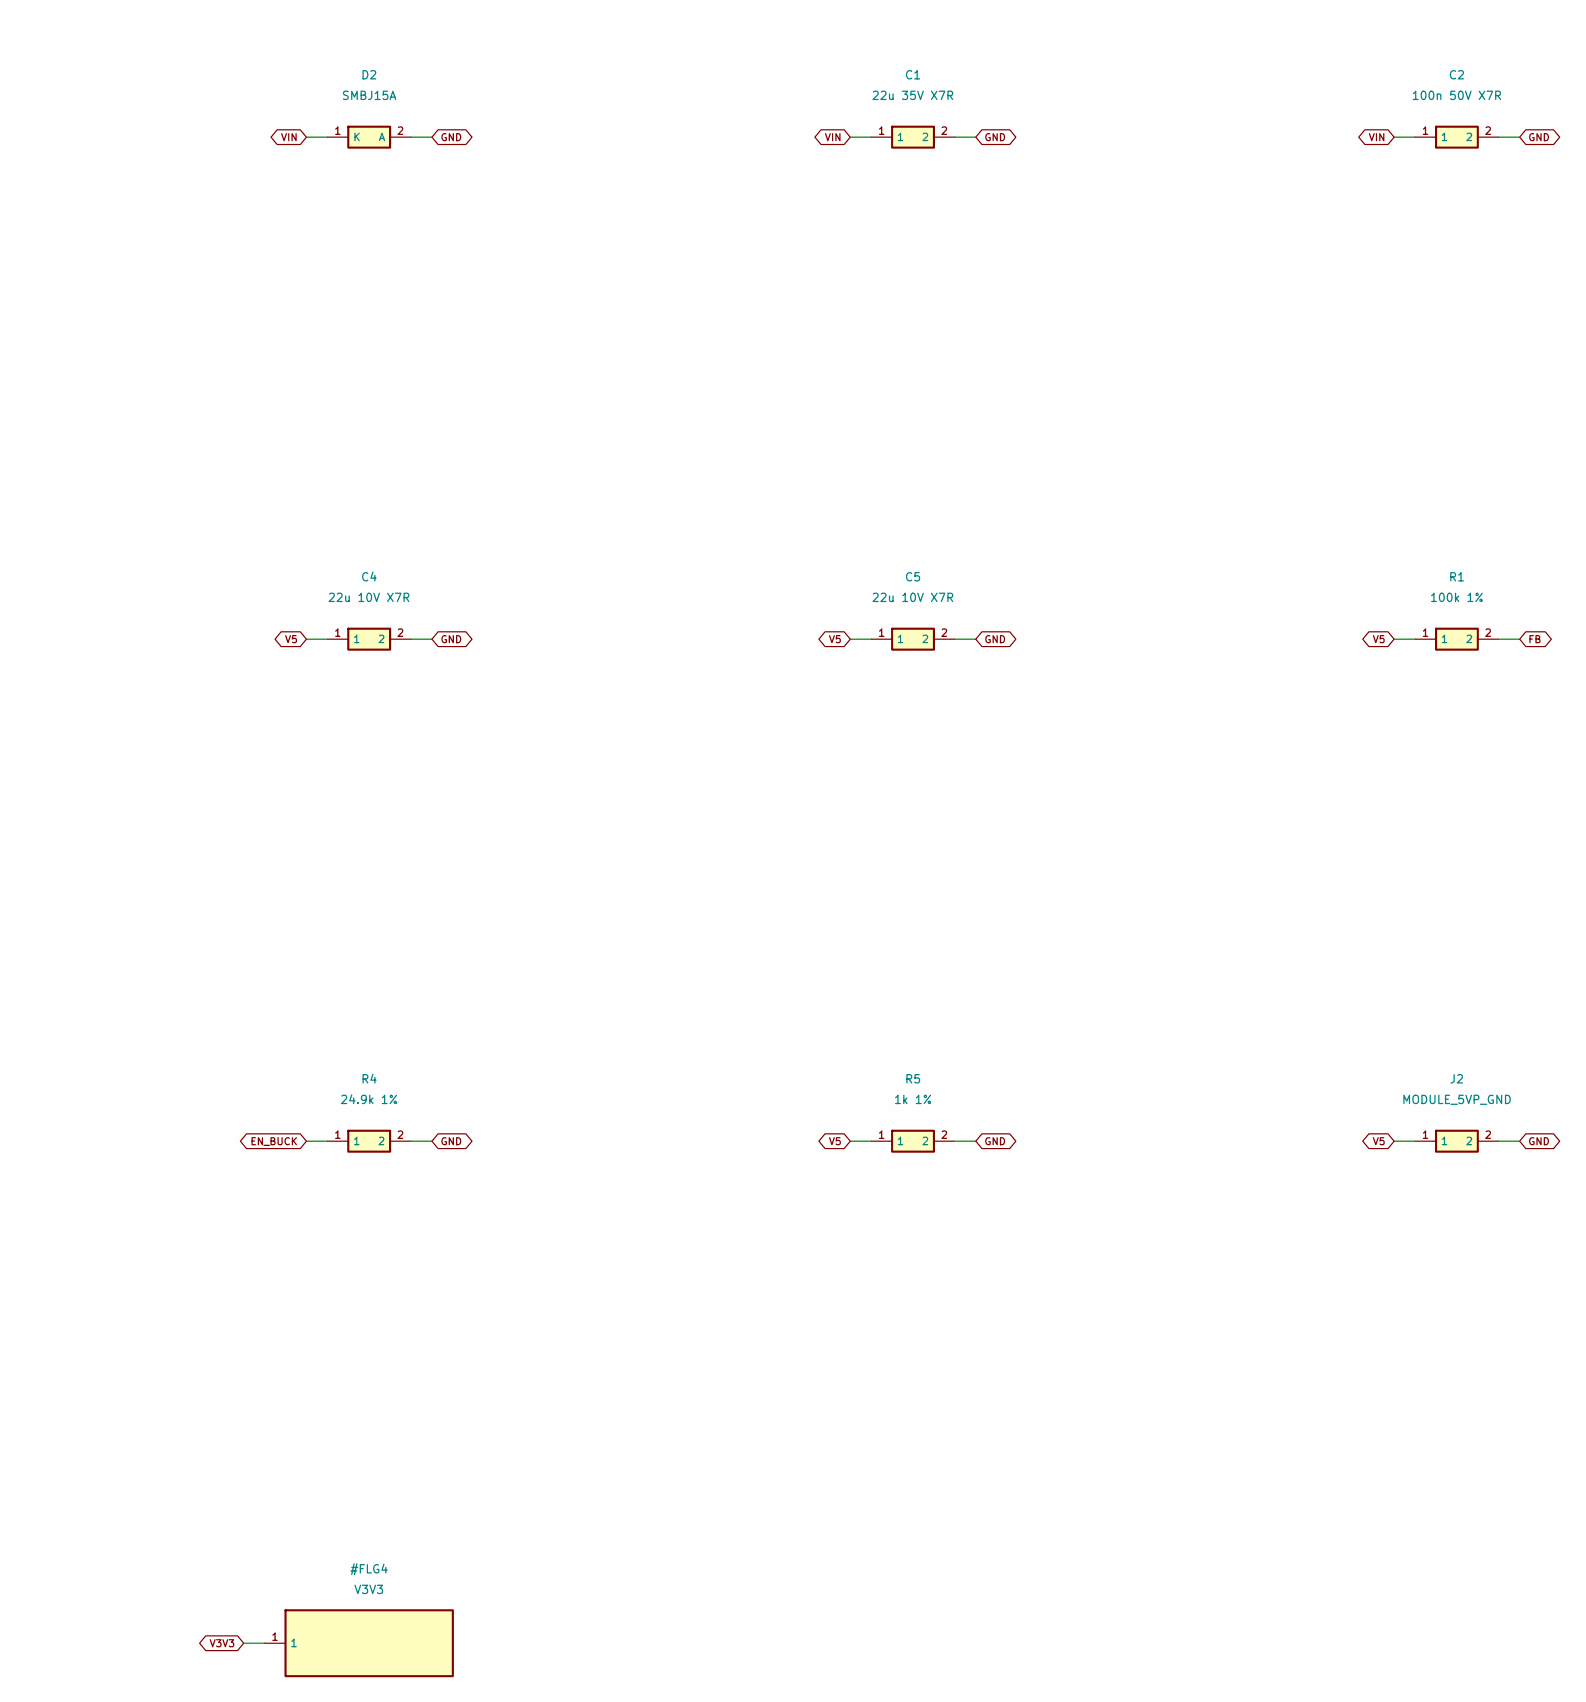
[picture p35: schematic core_01.kicad_sch, VideoSynth R1 / core / Power, part in row 1, column 2]

Parts:
C1: 22u 35V X7R; C_1210_3225Metric
C2: 100n 50V X7R; C_0805_2012Metric
C3: 100n 16V X7R; C_0805_2012Metric
C4, C5: 22u 10V X7R; C_0805_2012Metric
C6: 75p C0G; C_0805_2012Metric
D1: SS34; D_SMA
D2: SMBJ15A; D_SMB
F1: 750mA HOLD 33V; Fuse_1812_4532Metric
J1: EURORACK_10; IDC-Header_2x05_P2.54mm_Vertical
J2: MODULE_5VP_GND; PinHeader_1x02_P2.54mm_Vertical
L1: 6.8uH verify Isat; L_Bourns_SRP7028A_7.3x6.6mm
R1, R3: 100k 1%; R_0805_2012Metric
R2: 13.3k 1%; R_0805_2012Metric
R4: 24.9k 1%; R_0805_2012Metric
R5: 1k 1%; R_0805_2012Metric
U1: TPS54302DDCR; SOT-23-6

Connections:
BOOT: C3.1, U1.6 (BOOT)
EN_BUCK: R3.2, R4.1, U1.5 (EN)
EUR_12: F1.1, J1.9, J1.10
FB: C6.2, R1.2, R2.1, U1.4 (FB)
FUSED_12: D1.2 (A), F1.2
GND: C1.2, C2.2, C4.2, C5.2, D2.2 (A), J1.3, J1.4, J1.5, J1.6, J1.7, J1.8, J2.2, R2.2, R4.2, R5.2, U1.1 (GND); also elsewhere on the board
SW: C3.2, L1.1, U1.2 (SW)
V5: C4.1, C5.1, C6.1, J2.1, L1.2, R1.1, R5.1; also elsewhere on the board
VIN: C1.1, C2.1, D1.1 (K), D2.1 (K), R3.1, U1.3 (VIN)

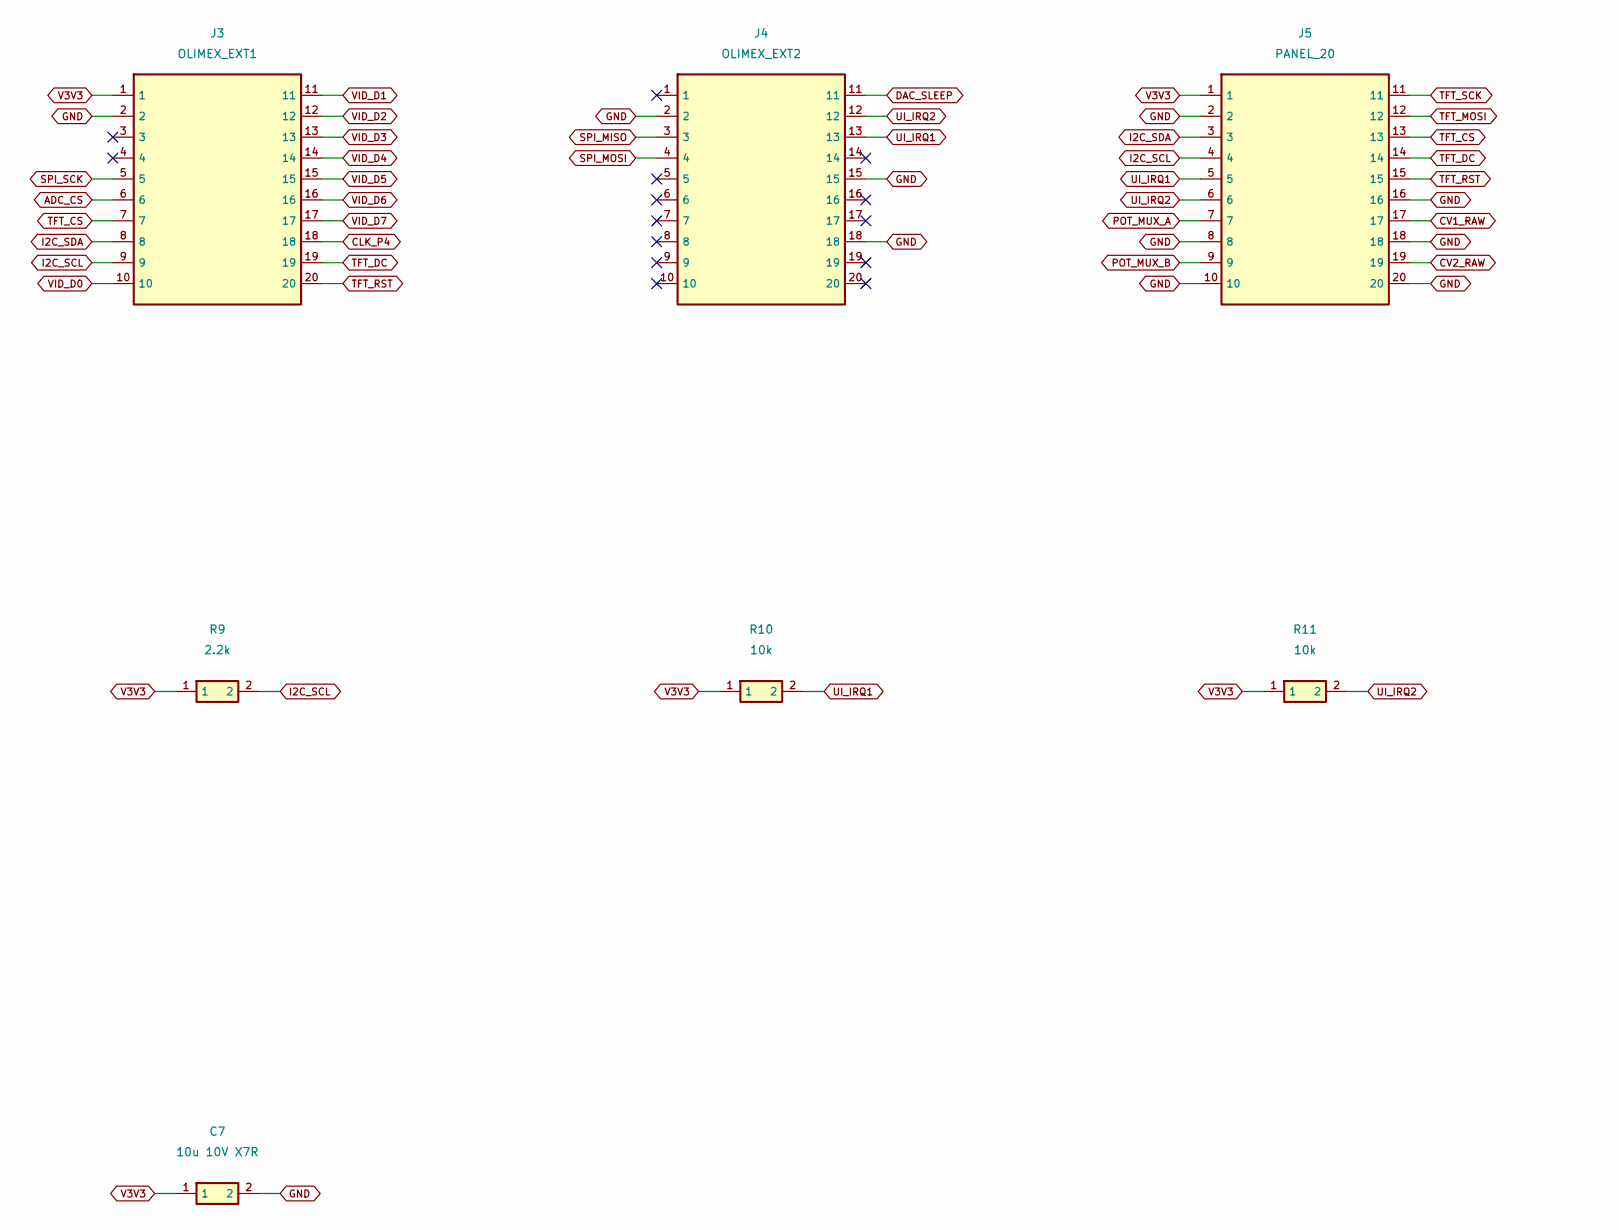
[picture p36: schematic core_02.kicad_sch, VideoSynth R1 / core / Module and panel interface, part in row 1, column 1]

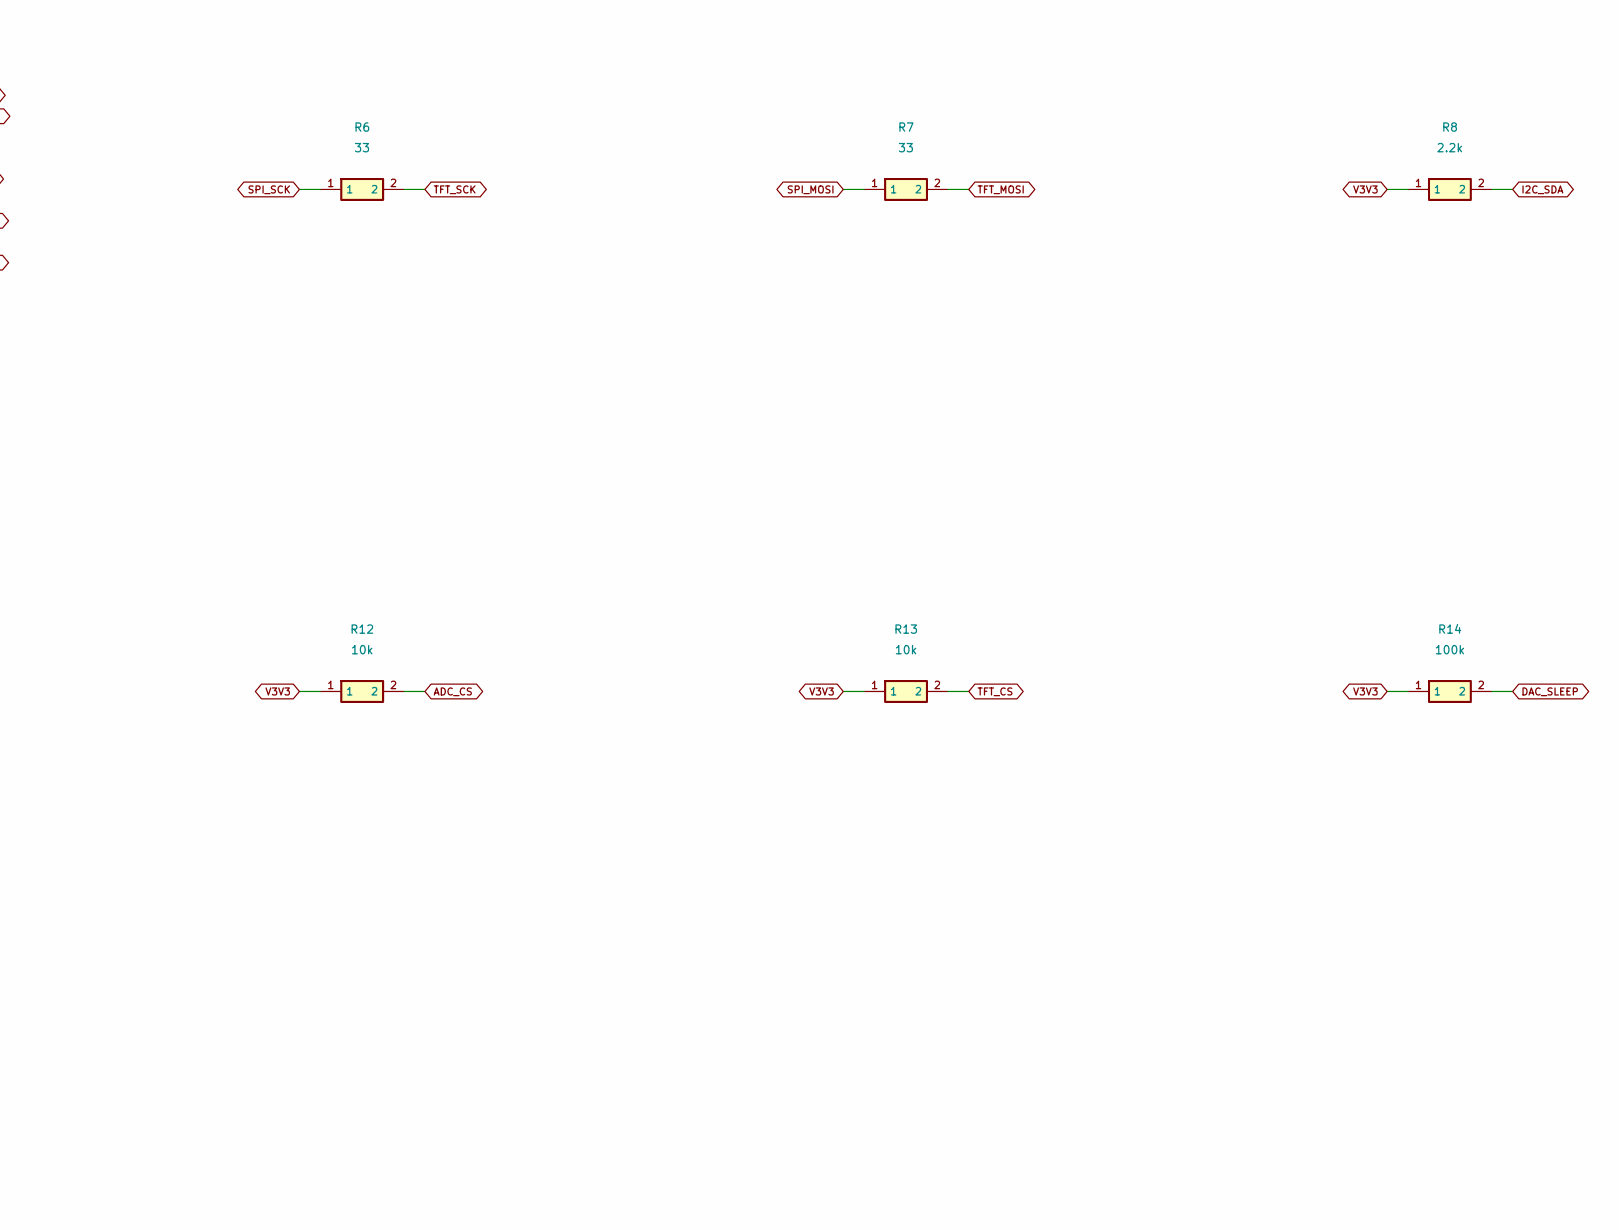
[picture p37: schematic core_02.kicad_sch, VideoSynth R1 / core / Module and panel interface, part in row 1, column 2]

Parts:
C7: 10u 10V X7R; C_0805_2012Metric
J3: OLIMEX_EXT1; PinSocket_1x20_P2.54mm_Vertical
J4: OLIMEX_EXT2; PinSocket_1x20_P2.54mm_Vertical
J5: PANEL_20; IDC-Header_2x10_P2.54mm_Vertical
R6, R7: 33; R_0805_2012Metric
R8, R9: 2.2k; R_0805_2012Metric
R10, R11, R12, R13: 10k; R_0805_2012Metric
R14: 100k; R_0805_2012Metric

Connections:
ADC_CS: J3.6, R12.2; also elsewhere on the board
CLK_P4: J3.18; also elsewhere on the board
CV1_RAW: J5.17; also elsewhere on the board
CV2_RAW: J5.19; also elsewhere on the board
DAC_SLEEP: J4.11, R14.2; also elsewhere on the board
GND: C7.2, J3.2, J4.2, J4.15, J4.18, J5.2, J5.8, J5.10, J5.16, J5.18, J5.20; also elsewhere on the board
I2C_SCL: J3.9, J5.4, R9.2
I2C_SDA: J3.8, J5.3, R8.2
POT_MUX_A: J5.7; also elsewhere on the board
POT_MUX_B: J5.9; also elsewhere on the board
SPI_MISO: J4.3; also elsewhere on the board
SPI_MOSI: J4.4, R7.1; also elsewhere on the board
SPI_SCK: J3.5, R6.1; also elsewhere on the board
TFT_CS: J3.7, J5.13, R13.2
TFT_DC: J3.19, J5.14
TFT_MOSI: J5.12, R7.2
TFT_RST: J3.20, J5.15
TFT_SCK: J5.11, R6.2
UI_IRQ1: J4.13, J5.5, R10.2
UI_IRQ2: J4.12, J5.6, R11.2
V3V3: C7.1, J3.1, J5.1, R8.1, R9.1, R10.1, R11.1, R12.1, R13.1, R14.1; also elsewhere on the board
VID_D0: J3.10; also elsewhere on the board
VID_D1: J3.11; also elsewhere on the board
VID_D2: J3.12; also elsewhere on the board
VID_D3: J3.13; also elsewhere on the board
VID_D4: J3.14; also elsewhere on the board
VID_D5: J3.15; also elsewhere on the board
VID_D6: J3.16; also elsewhere on the board
VID_D7: J3.17; also elsewhere on the board
