Guadonna/VideoSynth/hardware/kicad/core/videosynth_core.kicad_pcb

## KiCad design hardware/kicad/core/videosynth_core.kicad_pcb (continued)

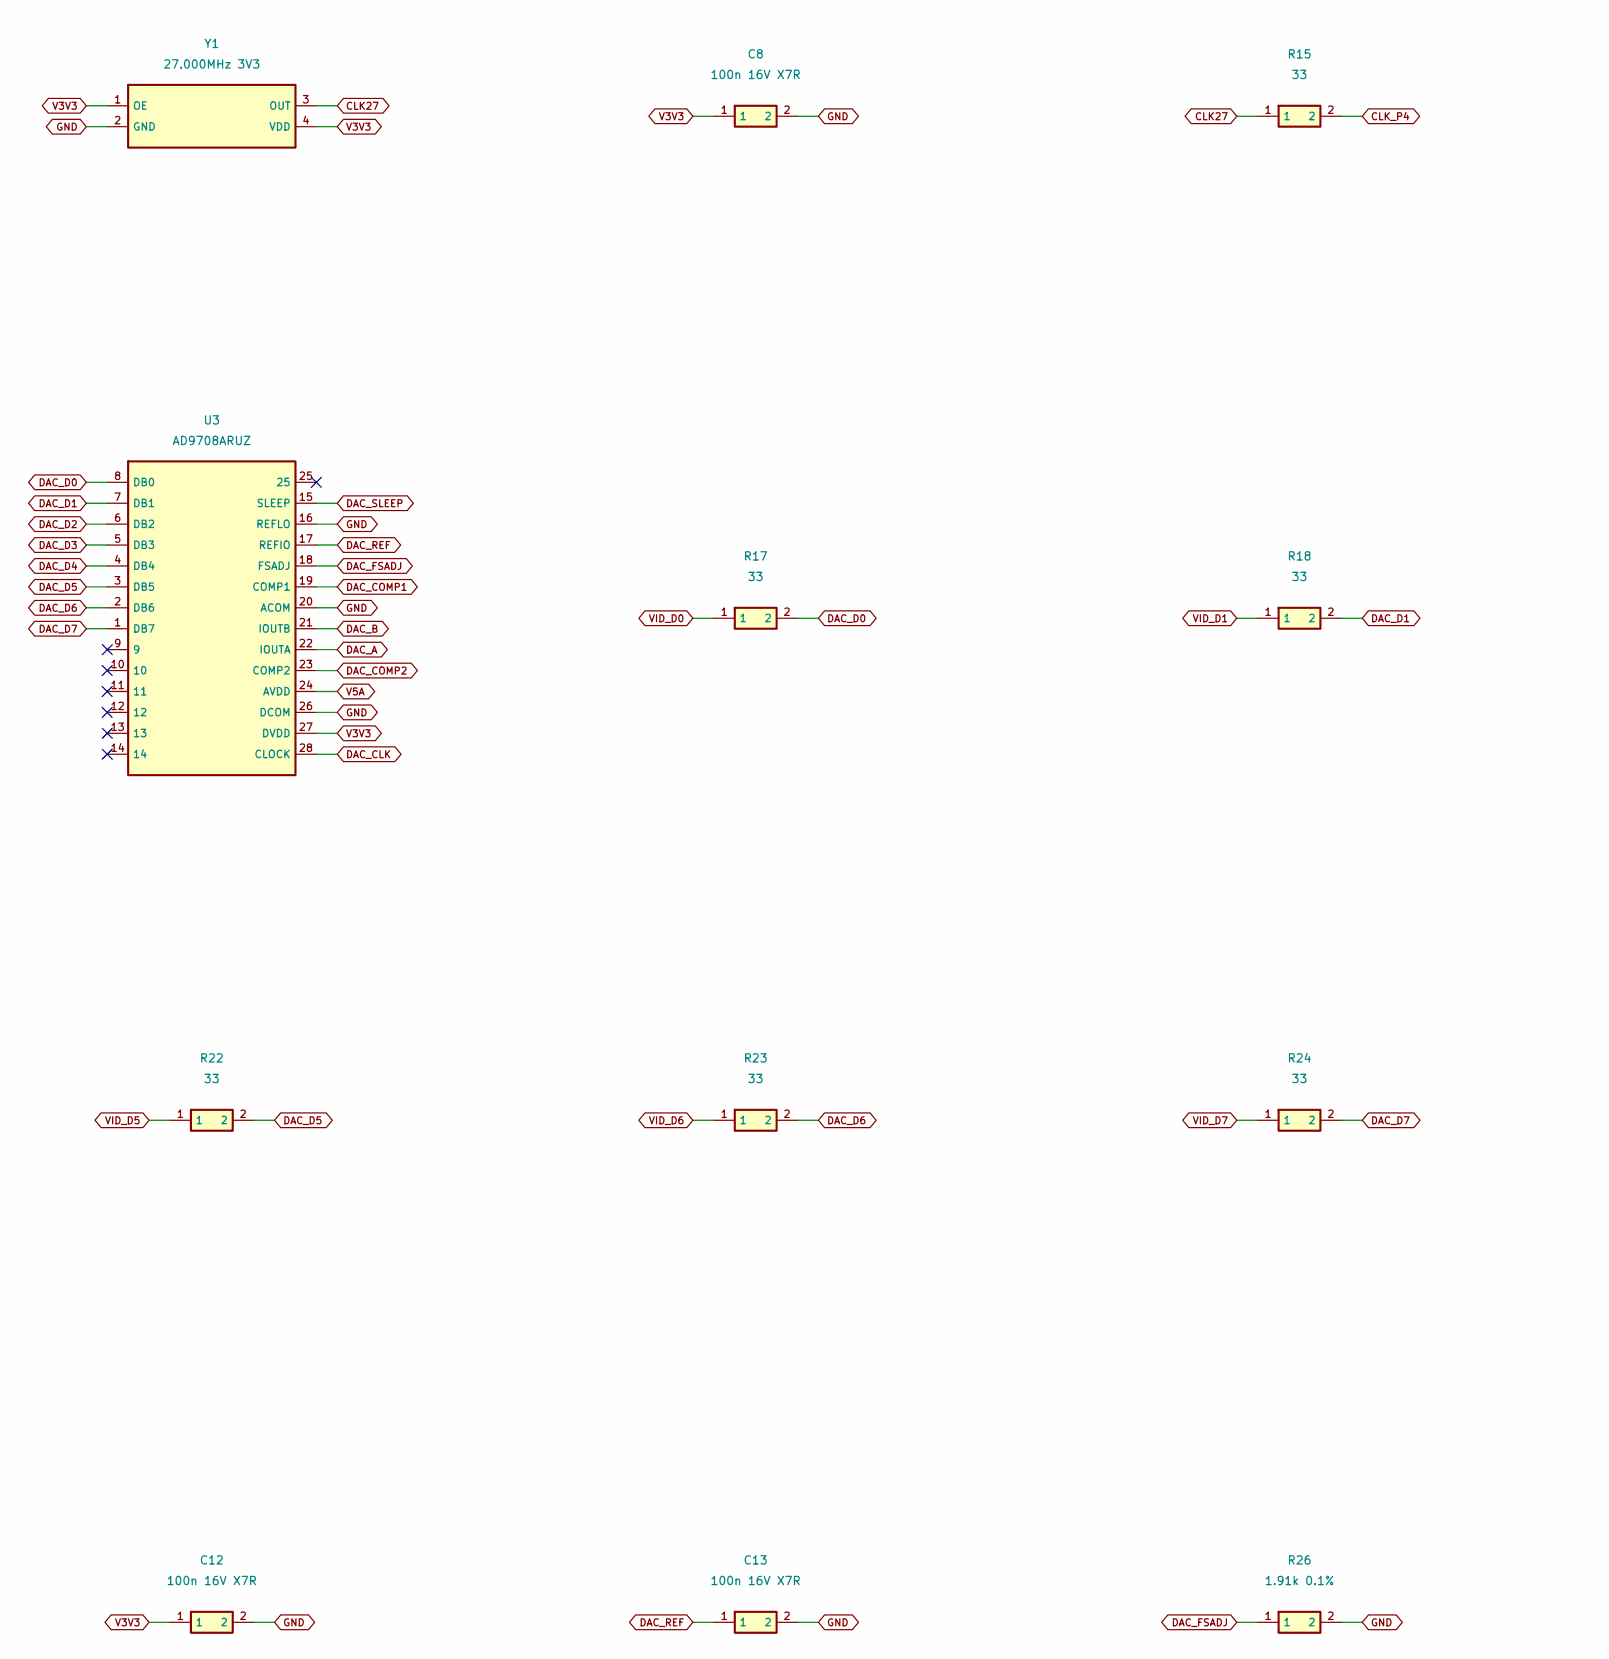
[picture p38: schematic core_03.kicad_sch, VideoSynth R1 / core / Video DAC and clock, part in row 1, column 1]

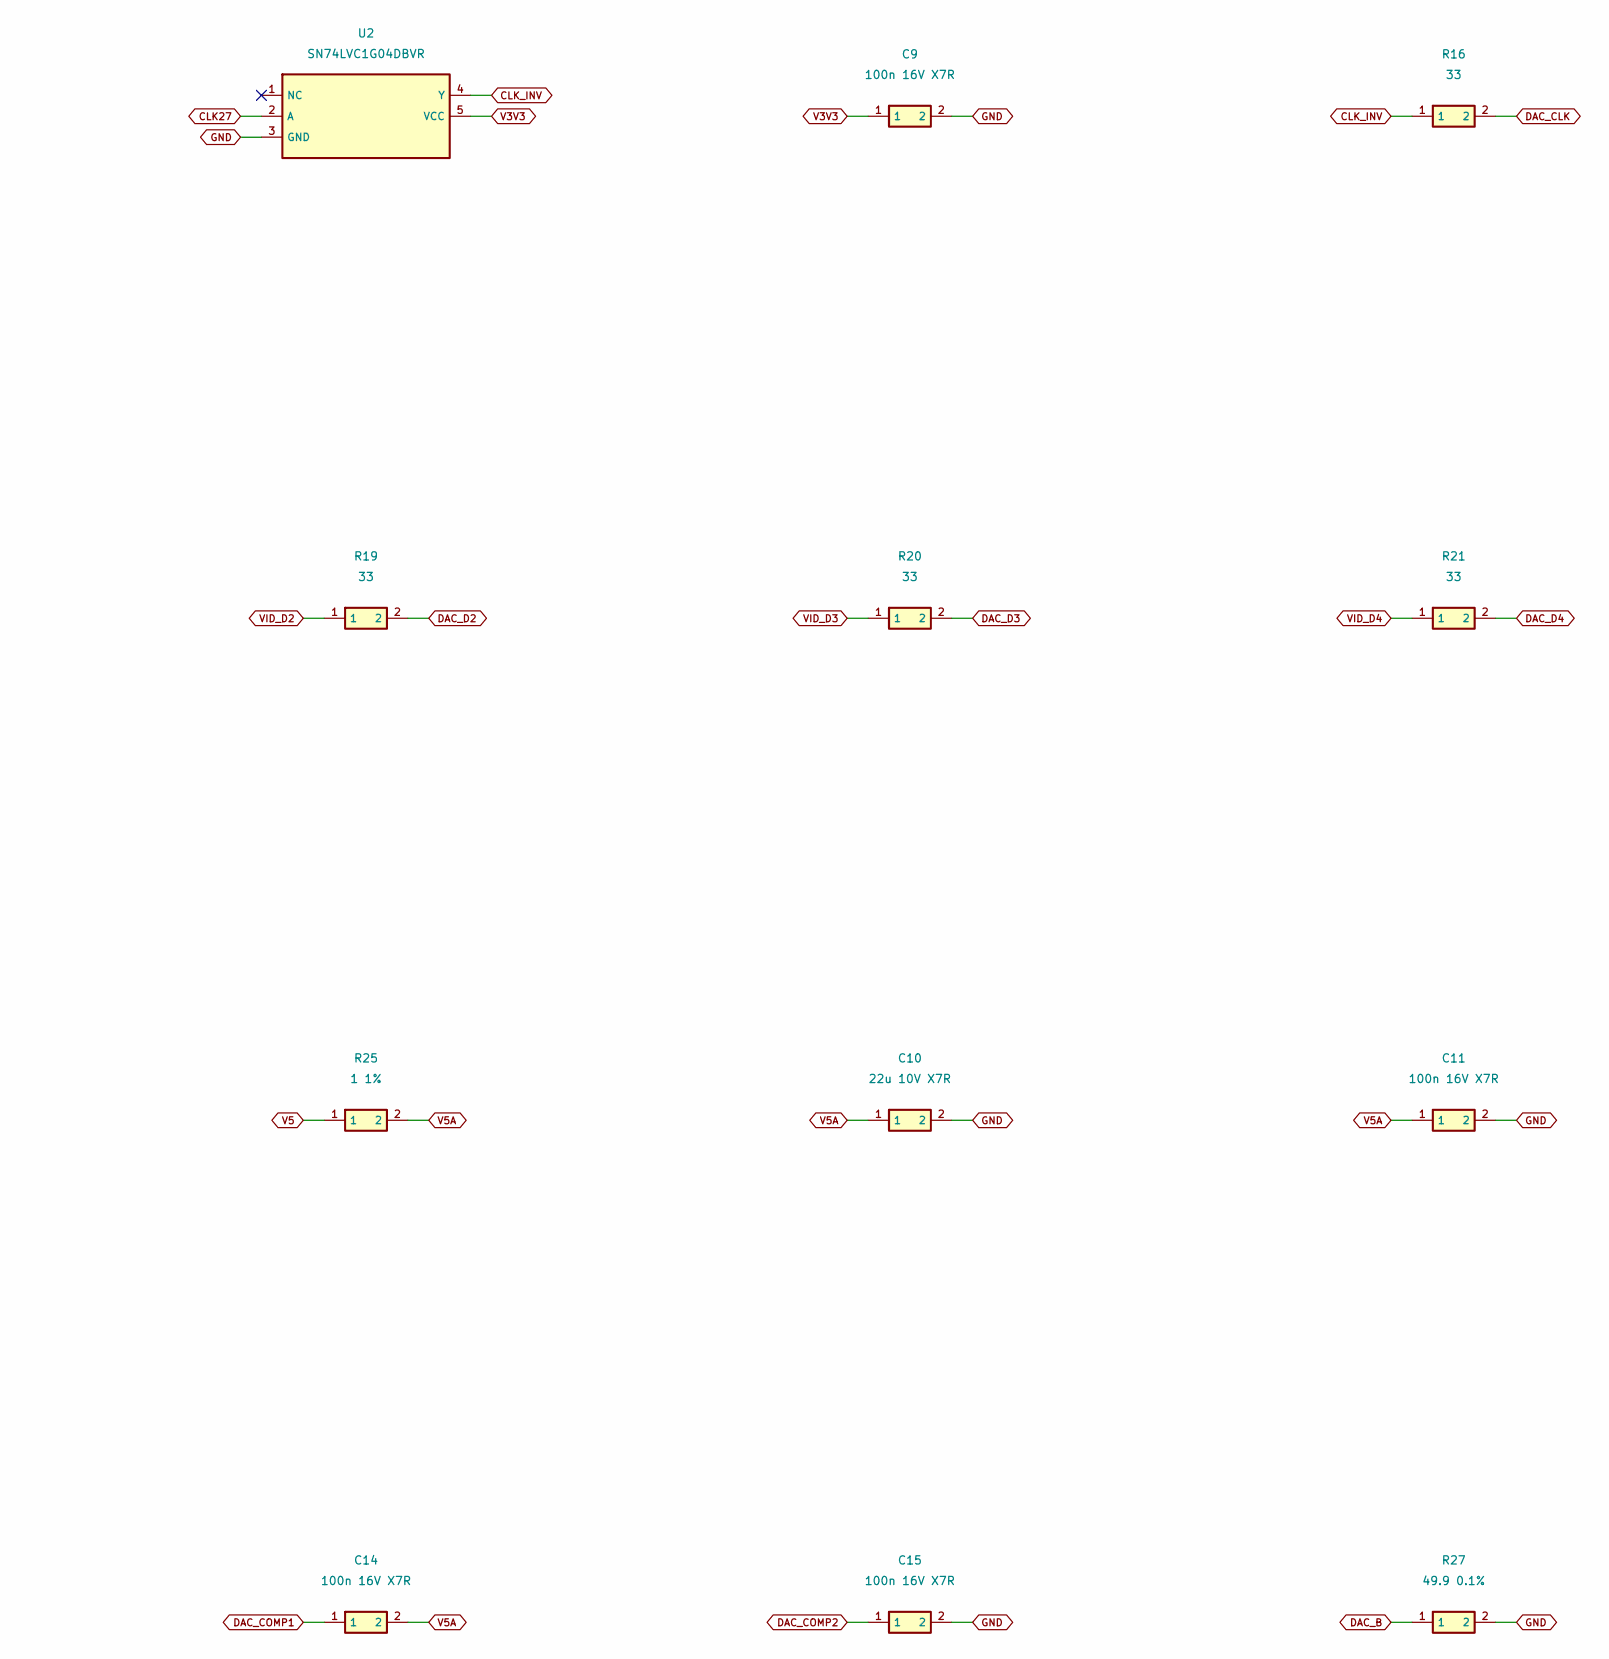
[picture p39: schematic core_03.kicad_sch, VideoSynth R1 / core / Video DAC and clock, part in row 1, column 2]

Parts:
C8, C9, C11, C12, C13, C14, C15: 100n 16V X7R; C_0805_2012Metric
C10: 22u 10V X7R; C_0805_2012Metric
R15, R16, R17, R18, R19, R20, R21, R22, R23, R24: 33; R_0805_2012Metric
R25: 1 1%; R_0805_2012Metric
R26: 1.91k 0.1%; R_0805_2012Metric
R27: 49.9 0.1%; R_0805_2012Metric
U2: SN74LVC1G04DBVR; SOT-23-5
U3: AD9708ARUZ; TSSOP-28_4.4x9.7mm_P0.65mm
Y1: 27.000MHz 3V3; Oscillator_SMD_Abracon_ASE-4Pin_3.2x2.5mm

Connections:
CLK27: R15.1, U2.2 (A), Y1.3 (OUT)
CLK_INV: R16.1, U2.4 (Y)
CLK_P4: R15.2; also elsewhere on the board
DAC_A: U3.22 (IOUTA); also elsewhere on the board
DAC_B: R27.1, U3.21 (IOUTB)
DAC_CLK: R16.2, U3.28 (CLOCK)
DAC_COMP1: C14.1, U3.19 (COMP1)
DAC_COMP2: C15.1, U3.23 (COMP2)
DAC_D0: R17.2, U3.8 (DB0)
DAC_D1: R18.2, U3.7 (DB1)
DAC_D2: R19.2, U3.6 (DB2)
DAC_D3: R20.2, U3.5 (DB3)
DAC_D4: R21.2, U3.4 (DB4)
DAC_D5: R22.2, U3.3 (DB5)
DAC_D6: R23.2, U3.2 (DB6)
DAC_D7: R24.2, U3.1 (DB7)
DAC_FSADJ: R26.1, U3.18 (FSADJ)
DAC_REF: C13.1, U3.17 (REFIO)
DAC_SLEEP: U3.15 (SLEEP); also elsewhere on the board
GND: C8.2, C9.2, C10.2, C11.2, C12.2, C13.2, C15.2, R26.2, R27.2, U2.3 (GND), U3.16 (REFLO), U3.20 (ACOM), U3.26 (DCOM), Y1.2 (GND); also elsewhere on the board
V3V3: C8.1, C9.1, C12.1, U2.5 (VCC), U3.27 (DVDD), Y1.1 (OE), Y1.4 (VDD); also elsewhere on the board
V5: R25.1; also elsewhere on the board
V5A: C10.1, C11.1, C14.2, R25.2, U3.24 (AVDD); also elsewhere on the board
VID_D0: R17.1; also elsewhere on the board
VID_D1: R18.1; also elsewhere on the board
VID_D2: R19.1; also elsewhere on the board
VID_D3: R20.1; also elsewhere on the board
VID_D4: R21.1; also elsewhere on the board
VID_D5: R22.1; also elsewhere on the board
VID_D6: R23.1; also elsewhere on the board
VID_D7: R24.1; also elsewhere on the board

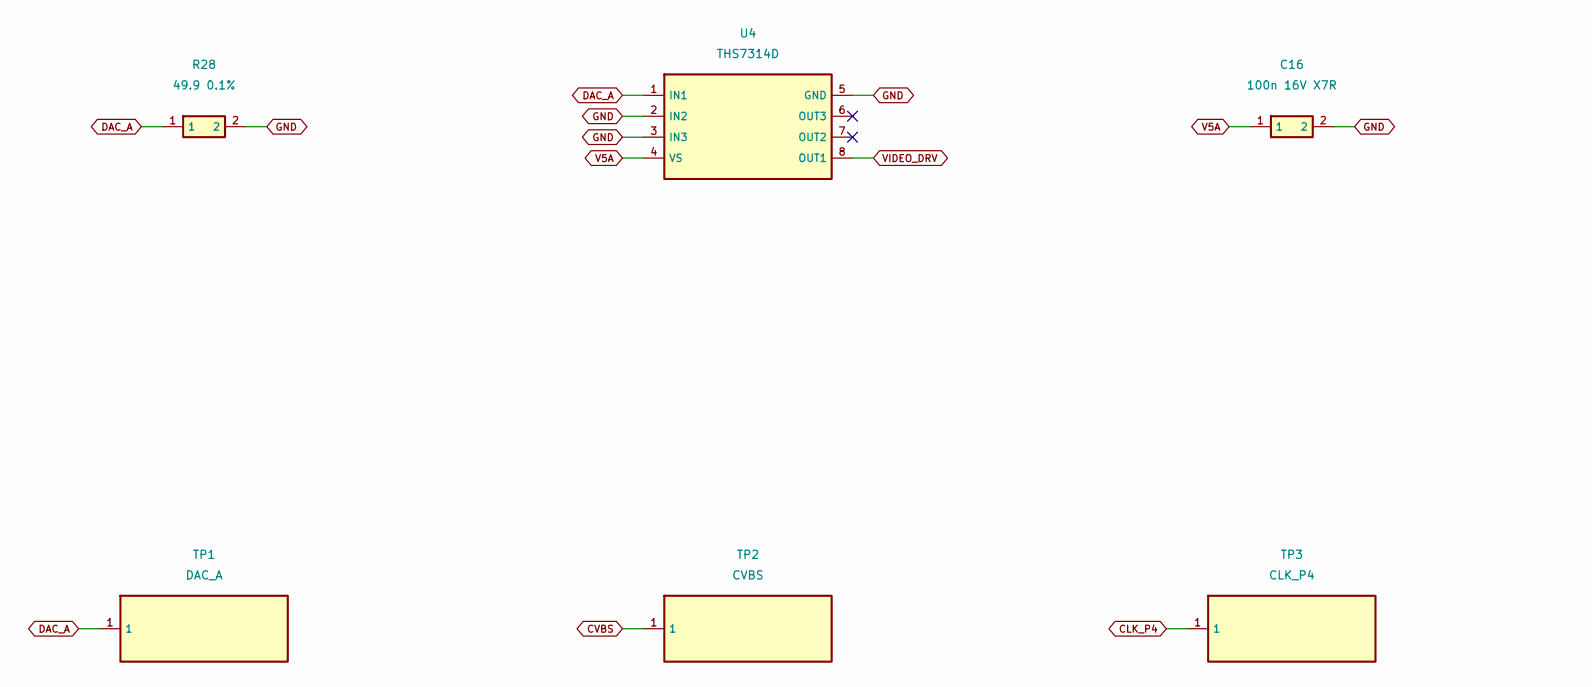
[picture p40: schematic core_04.kicad_sch, VideoSynth R1 / core / Video DAC and clock, part in row 1, column 1]

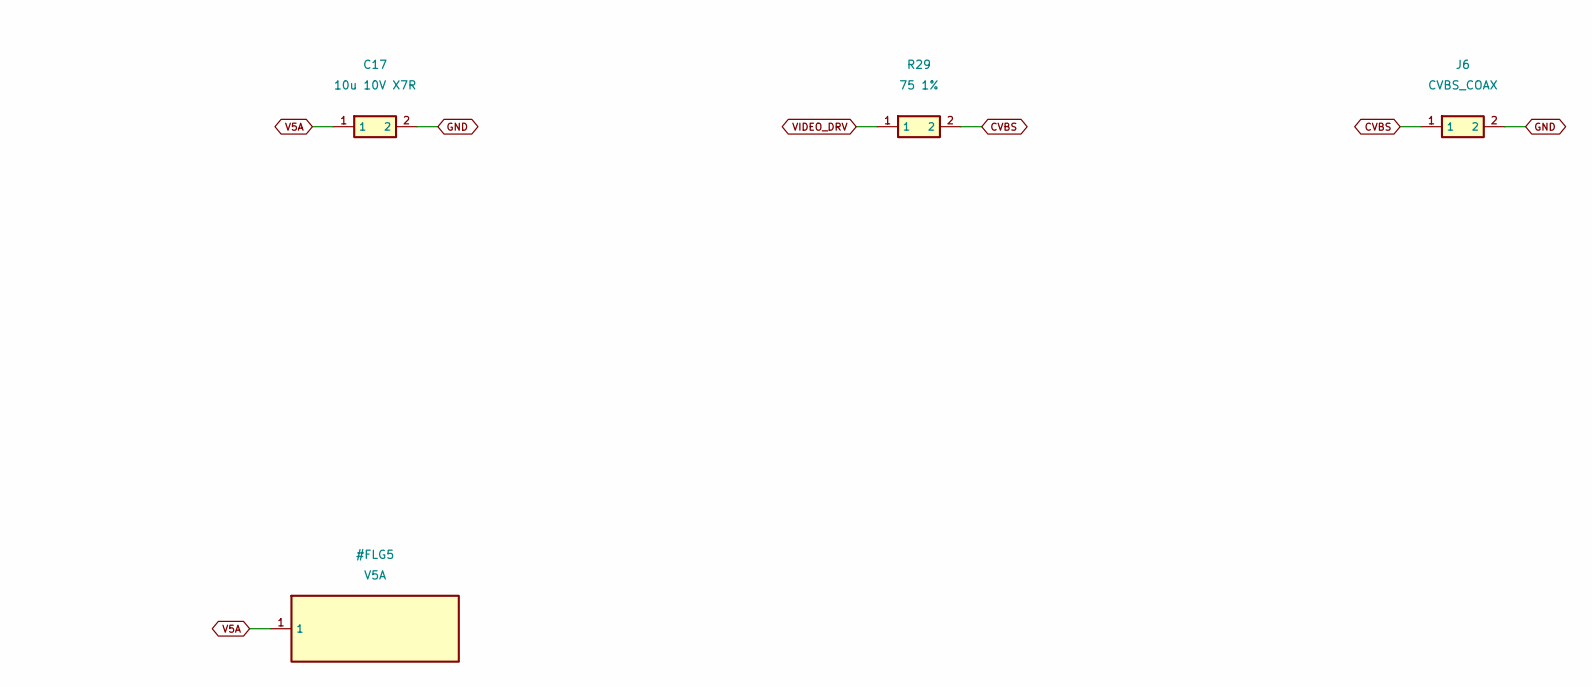
[picture p41: schematic core_04.kicad_sch, VideoSynth R1 / core / Video DAC and clock, part in row 1, column 2]

Parts:
C16: 100n 16V X7R; C_0805_2012Metric
C17: 10u 10V X7R; C_0805_2012Metric
J6: CVBS_COAX; PinHeader_1x02_P2.54mm_Vertical
R28: 49.9 0.1%; R_0805_2012Metric
R29: 75 1%; R_0805_2012Metric
TP1: DAC_A; TestPoint_Pad_D1.5mm
TP2: CVBS; TestPoint_Pad_D1.5mm
TP3: CLK_P4; TestPoint_Pad_D1.5mm
U4: THS7314D; SOIC-8_3.9x4.9mm_P1.27mm

Connections:
CLK_P4: TP3.1; also elsewhere on the board
CVBS: J6.1, R29.2, TP2.1
DAC_A: R28.1, TP1.1, U4.1 (IN1); also elsewhere on the board
GND: C16.2, C17.2, J6.2, R28.2, U4.2 (IN2), U4.3 (IN3), U4.5 (GND); also elsewhere on the board
V5A: C16.1, C17.1, U4.4 (VS); also elsewhere on the board
VIDEO_DRV: R29.1, U4.8 (OUT1)

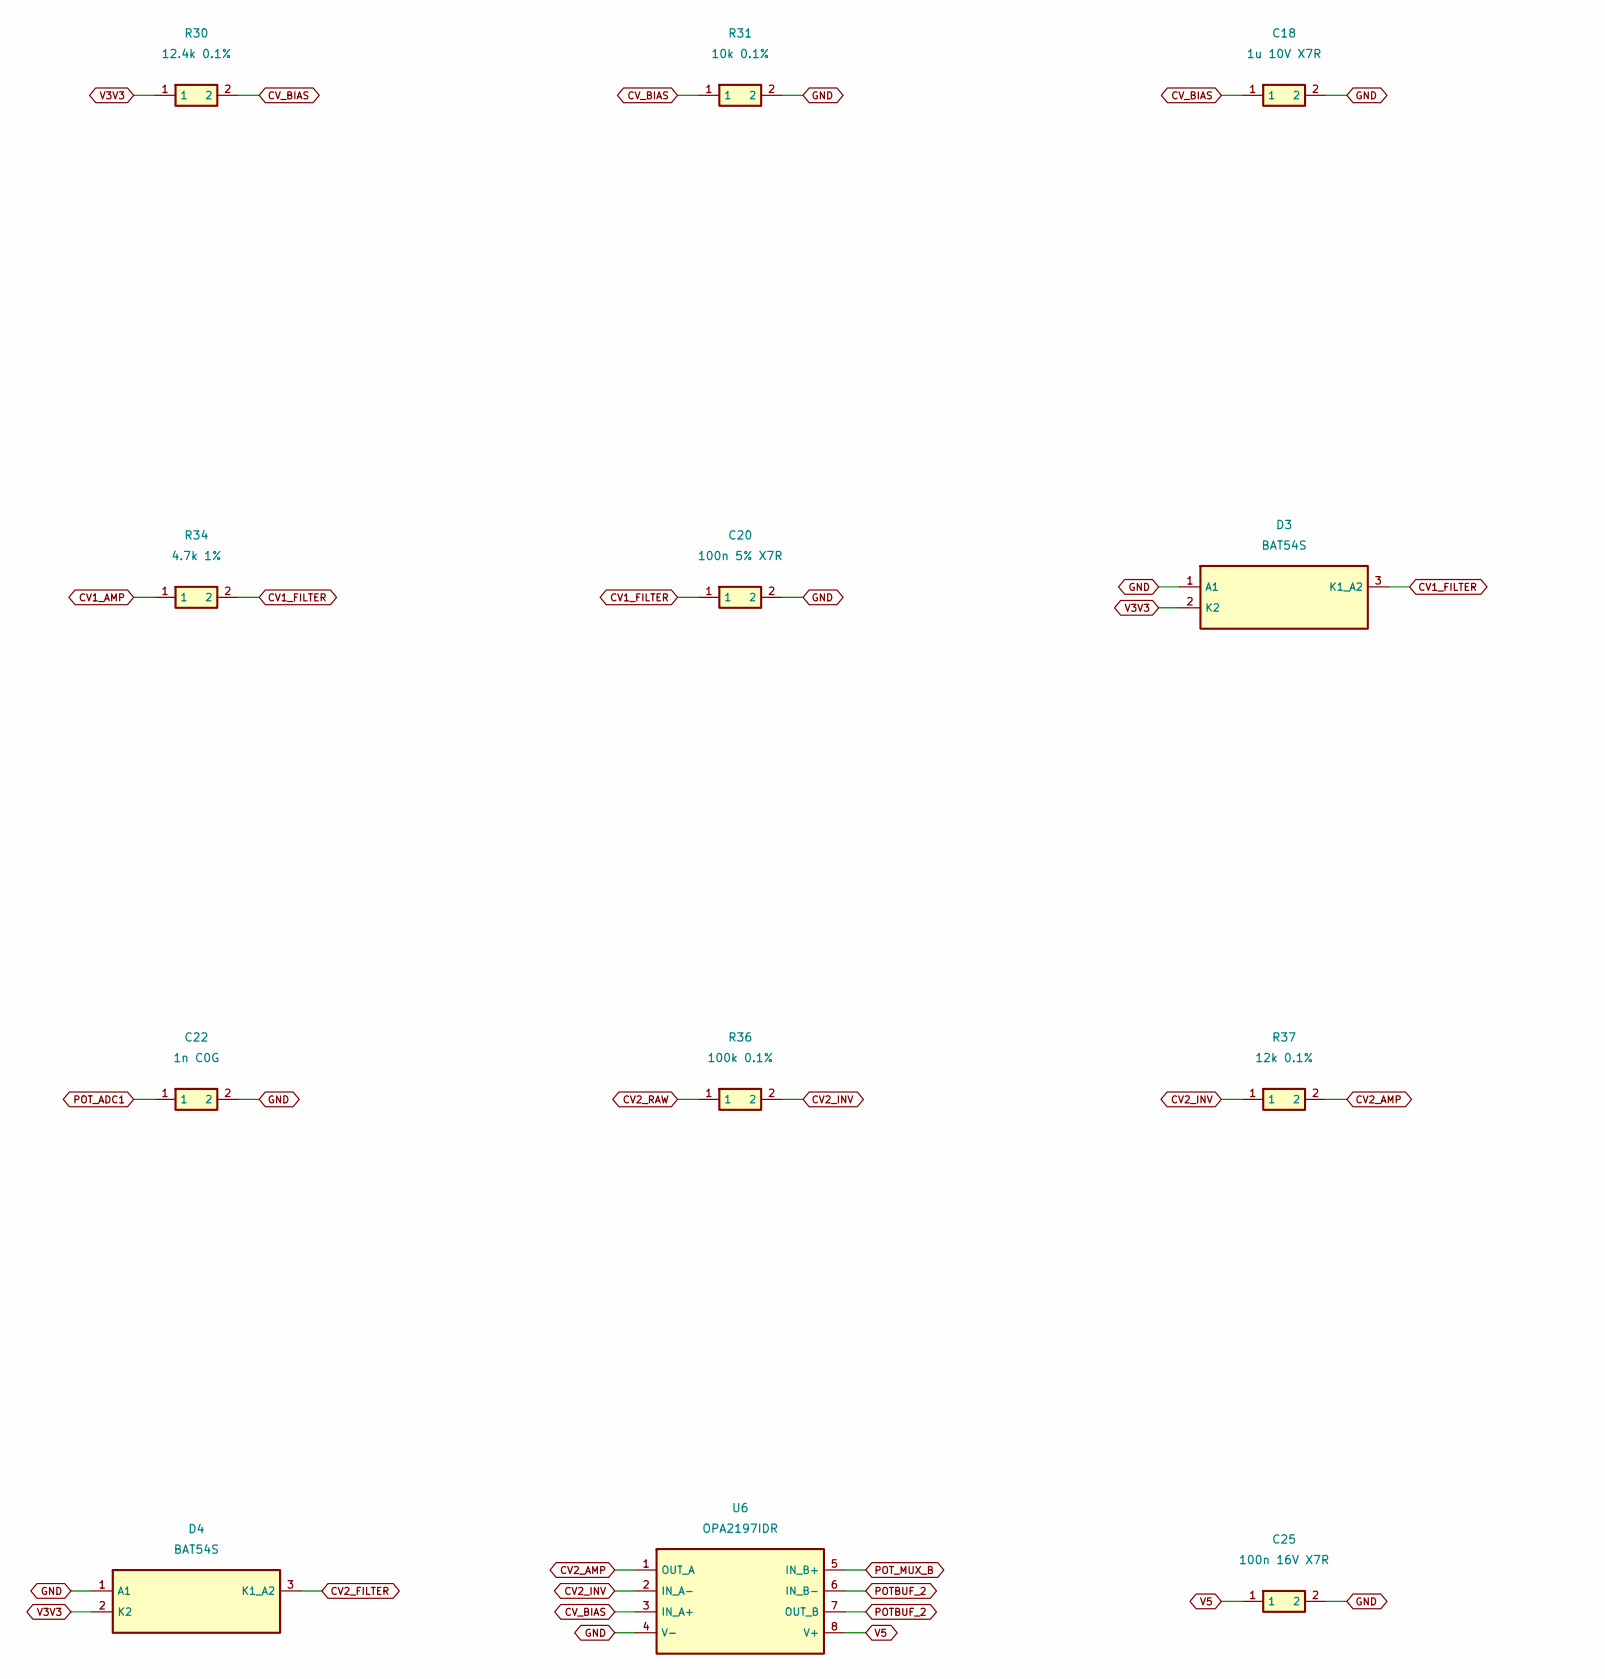
[picture p42: schematic core_05.kicad_sch, VideoSynth R1 / core / CV protection and control ADC, part in row 1, column 1]

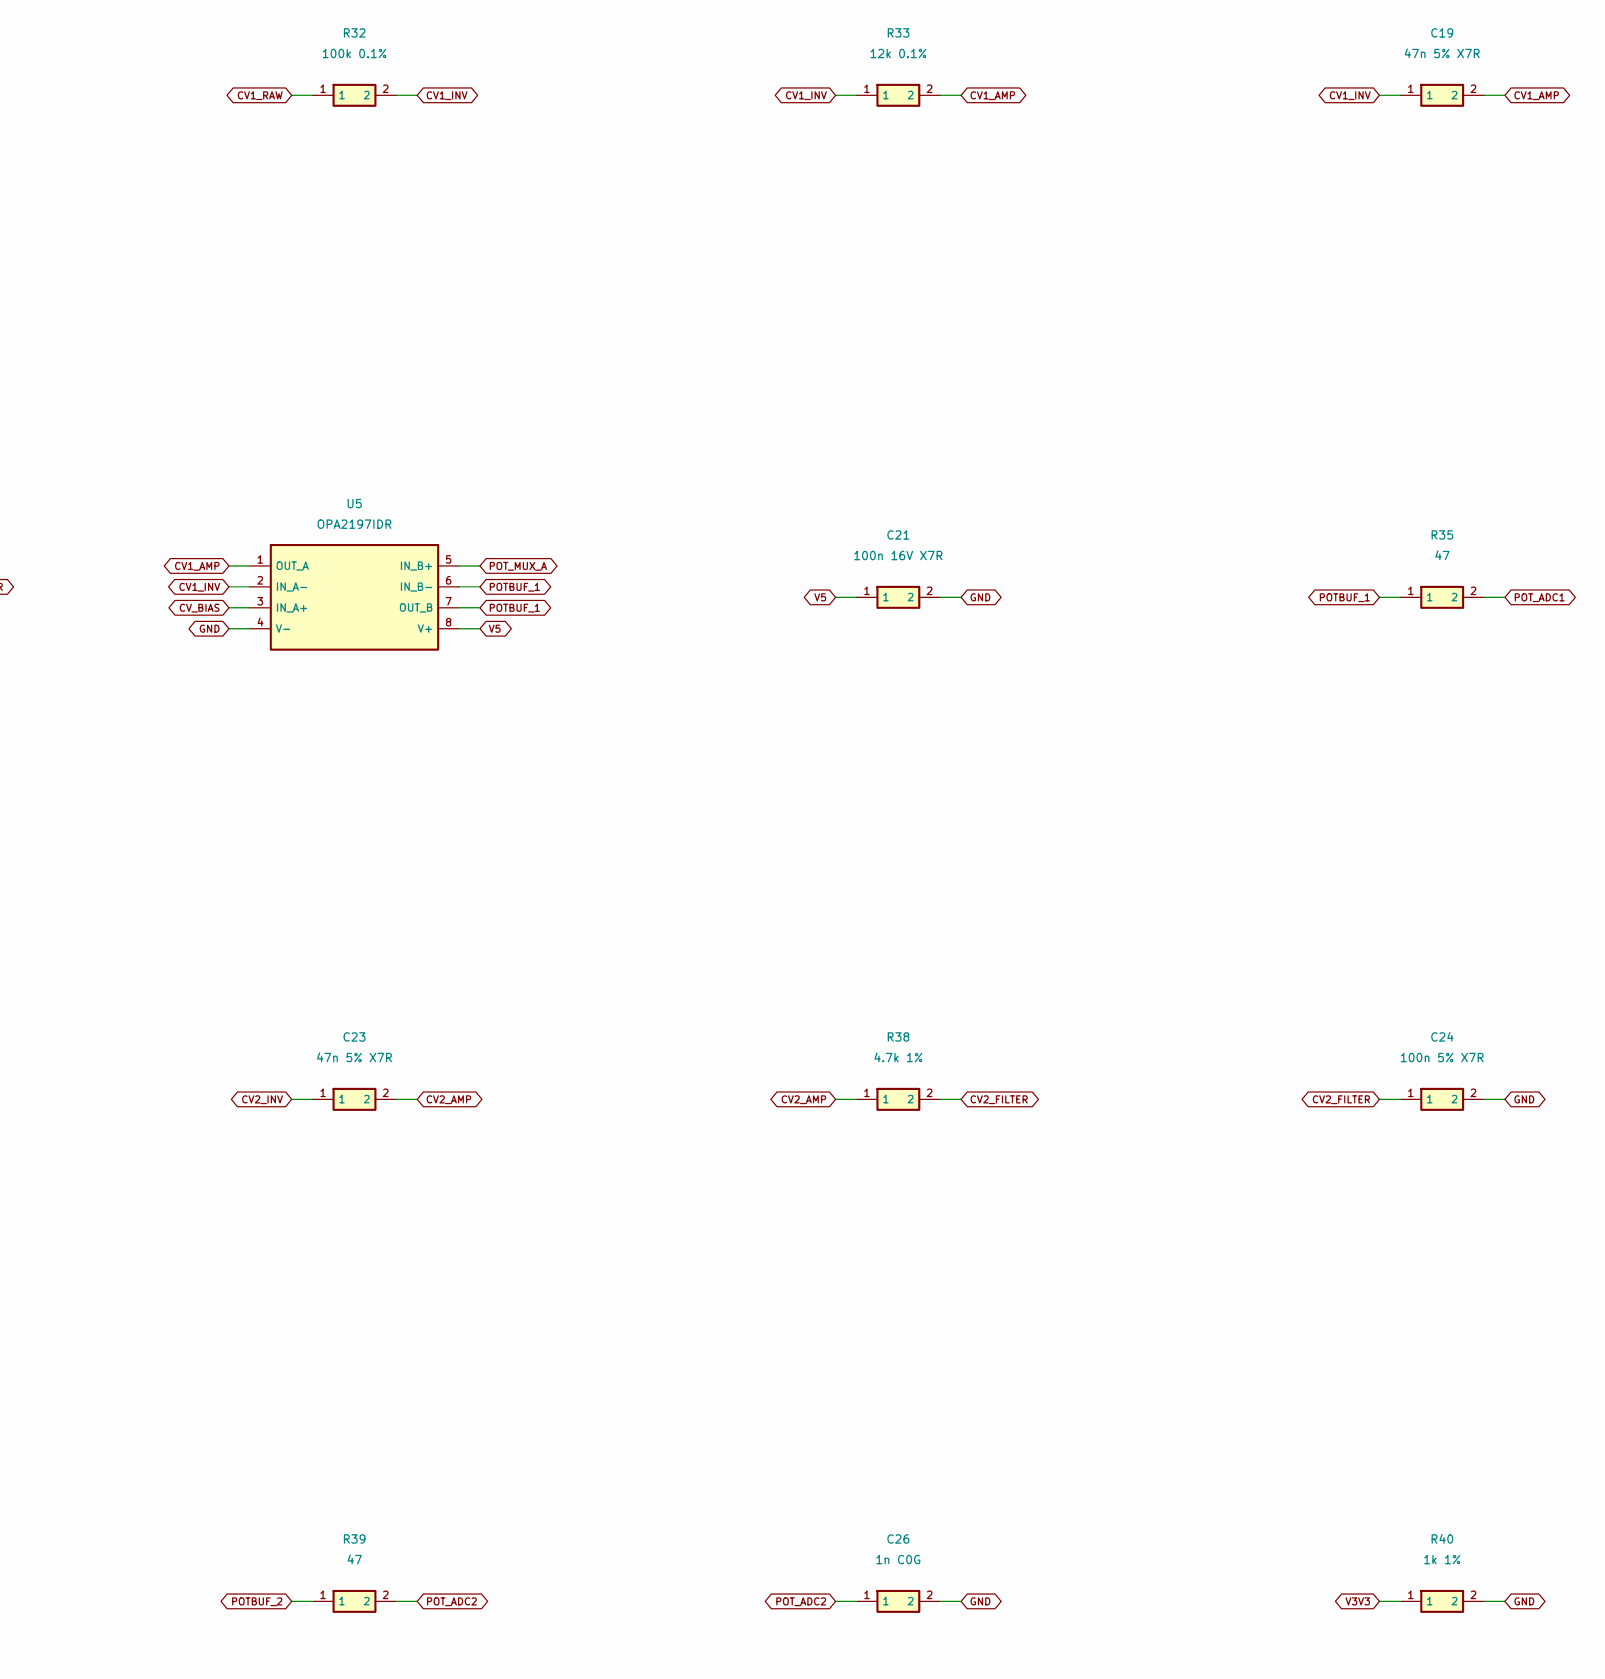
[picture p43: schematic core_05.kicad_sch, VideoSynth R1 / core / CV protection and control ADC, part in row 1, column 2]

Parts:
C18: 1u 10V X7R; C_0805_2012Metric
C19, C23: 47n 5% X7R; C_0805_2012Metric
C20, C24: 100n 5% X7R; C_0805_2012Metric
C21, C25: 100n 16V X7R; C_0805_2012Metric
C22, C26: 1n C0G; C_0805_2012Metric
D3, D4: BAT54S; SOT-23
R30: 12.4k 0.1%; R_0805_2012Metric
R31: 10k 0.1%; R_0805_2012Metric
R32, R36: 100k 0.1%; R_0805_2012Metric
R33, R37: 12k 0.1%; R_0805_2012Metric
R34, R38: 4.7k 1%; R_0805_2012Metric
R35, R39: 47; R_0805_2012Metric
R40: 1k 1%; R_0805_2012Metric
U5, U6: OPA2197IDR; SOIC-8_3.9x4.9mm_P1.27mm

Connections:
CV1_AMP: C19.2, R33.2, R34.1, U5.1 (OUT_A)
CV1_FILTER: C20.1, D3.3 (K1_A2), R34.2; also elsewhere on the board
CV1_INV: C19.1, R32.2, R33.1, U5.2 (IN_A-)
CV1_RAW: R32.1; also elsewhere on the board
CV2_AMP: C23.2, R37.2, R38.1, U6.1 (OUT_A)
CV2_FILTER: C24.1, D4.3 (K1_A2), R38.2; also elsewhere on the board
CV2_INV: C23.1, R36.2, R37.1, U6.2 (IN_A-)
CV2_RAW: R36.1; also elsewhere on the board
CV_BIAS: C18.1, R30.2, R31.1, U5.3 (IN_A+), U6.3 (IN_A+)
GND: C18.2, C20.2, C21.2, C22.2, C24.2, C25.2, C26.2, D3.1 (A1), D4.1 (A1), R31.2, R40.2, U5.4 (V-), U6.4 (V-); also elsewhere on the board
POTBUF_1: R35.1, U5.6 (IN_B-), U5.7 (OUT_B)
POTBUF_2: R39.1, U6.6 (IN_B-), U6.7 (OUT_B)
POT_ADC1: C22.1, R35.2; also elsewhere on the board
POT_ADC2: C26.1, R39.2; also elsewhere on the board
POT_MUX_A: U5.5 (IN_B+); also elsewhere on the board
POT_MUX_B: U6.5 (IN_B+); also elsewhere on the board
V3V3: D3.2 (K2), D4.2 (K2), R30.1, R40.1; also elsewhere on the board
V5: C21.1, C25.1, U5.8 (V+), U6.8 (V+); also elsewhere on the board

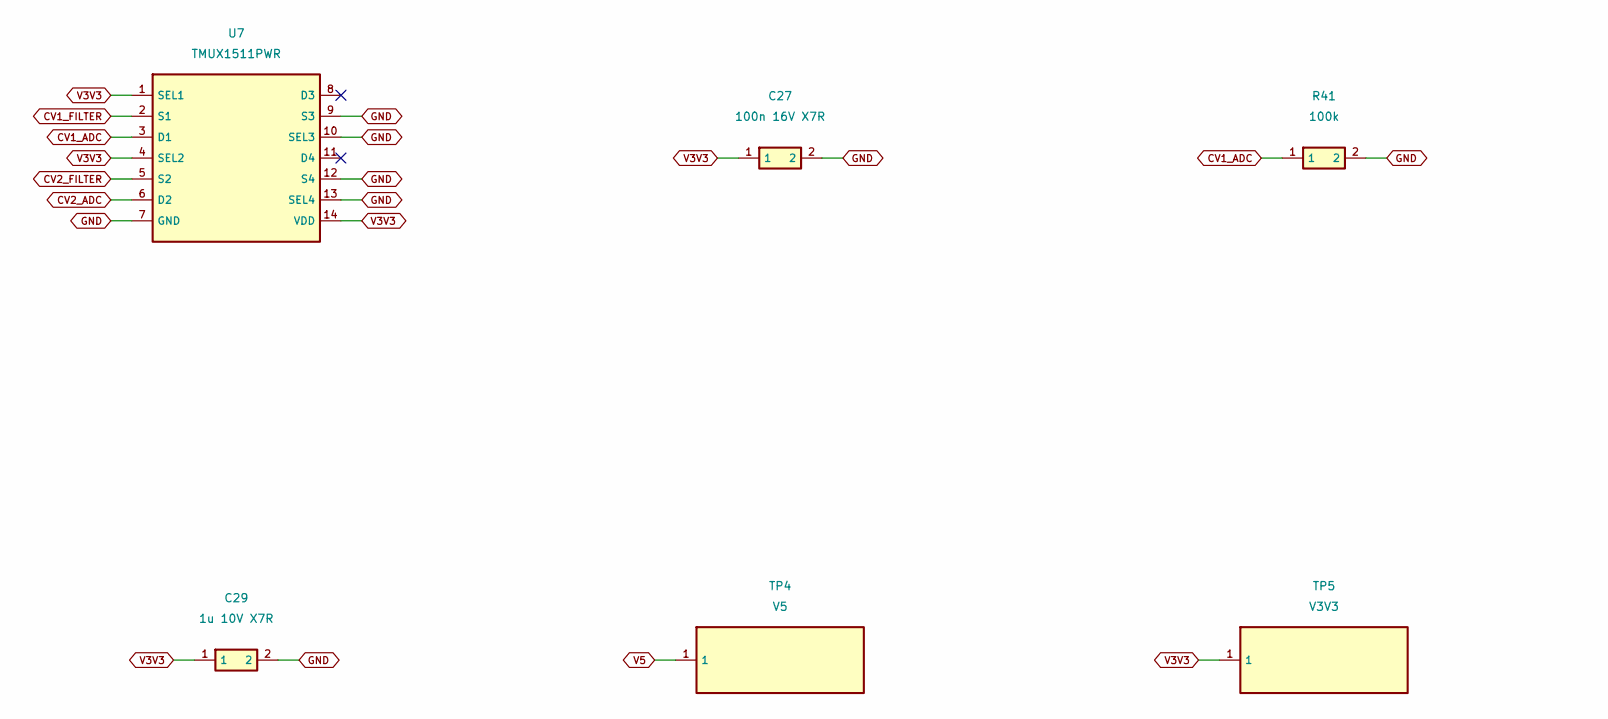
[picture p44: schematic core_06.kicad_sch, VideoSynth R1 / core / CV protection and control ADC, part in row 1, column 1]

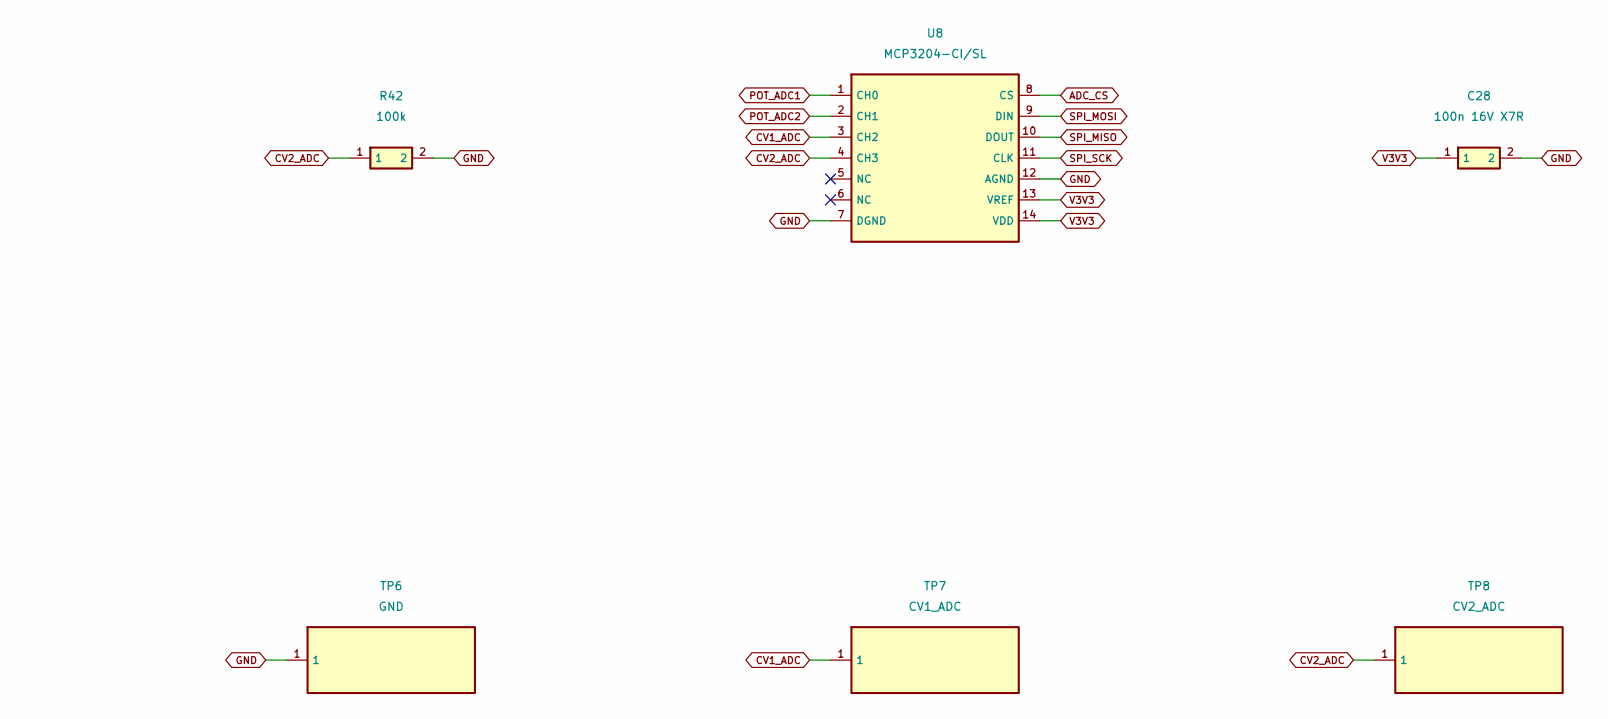
[picture p45: schematic core_06.kicad_sch, VideoSynth R1 / core / CV protection and control ADC, part in row 1, column 2]

Parts:
C27, C28: 100n 16V X7R; C_0805_2012Metric
C29: 1u 10V X7R; C_0805_2012Metric
R41, R42: 100k; R_0805_2012Metric
TP4: V5; TestPoint_Pad_D1.5mm
TP5: V3V3; TestPoint_Pad_D1.5mm
TP6: GND; TestPoint_Pad_D1.5mm
TP7: CV1_ADC; TestPoint_Pad_D1.5mm
TP8: CV2_ADC; TestPoint_Pad_D1.5mm
U7: TMUX1511PWR; TSSOP-14_4.4x5mm_P0.65mm
U8: MCP3204-CI/SL; SOIC-14_3.9x8.7mm_P1.27mm

Connections:
ADC_CS: U8.8 (CS); also elsewhere on the board
CV1_ADC: R41.1, TP7.1, U7.3 (D1), U8.3 (CH2)
CV1_FILTER: U7.2 (S1); also elsewhere on the board
CV2_ADC: R42.1, TP8.1, U7.6 (D2), U8.4 (CH3)
CV2_FILTER: U7.5 (S2); also elsewhere on the board
GND: C27.2, C28.2, C29.2, R41.2, R42.2, TP6.1, U7.7 (GND), U7.9 (S3), U7.10 (SEL3), U7.12 (S4), U7.13 (SEL4), U8.7 (DGND), U8.12 (AGND); also elsewhere on the board
POT_ADC1: U8.1 (CH0); also elsewhere on the board
POT_ADC2: U8.2 (CH1); also elsewhere on the board
SPI_MISO: U8.10 (DOUT); also elsewhere on the board
SPI_MOSI: U8.9 (DIN); also elsewhere on the board
SPI_SCK: U8.11 (CLK); also elsewhere on the board
V3V3: C27.1, C28.1, C29.1, TP5.1, U7.1 (SEL1), U7.4 (SEL2), U7.14 (VDD), U8.13 (VREF), U8.14 (VDD); also elsewhere on the board
V5: TP4.1; also elsewhere on the board

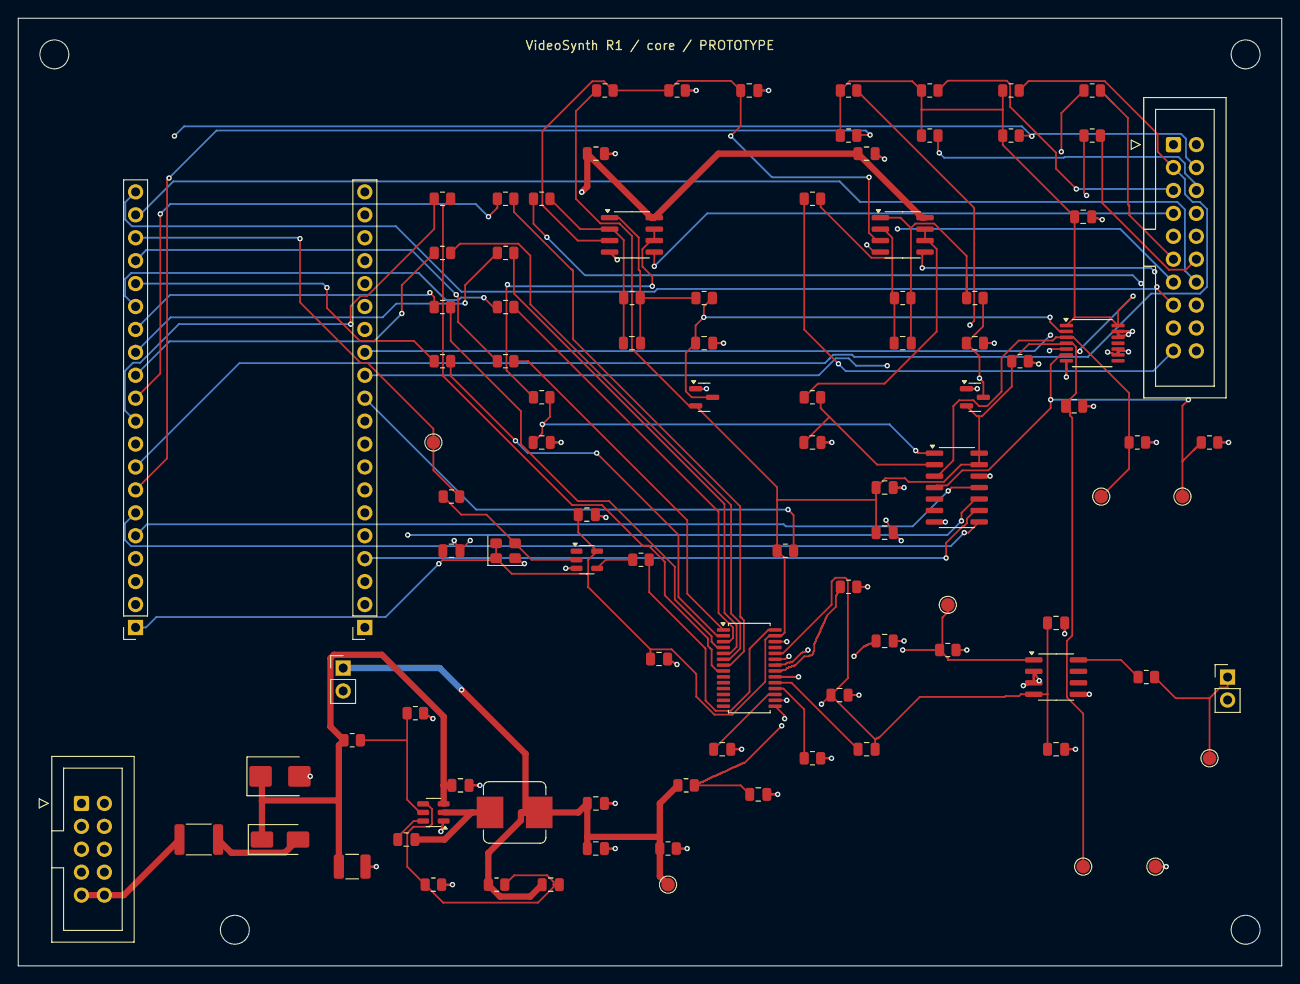
[picture p46: board videosynth_core.kicad_pcb from above]

Board: 4 copper layers, 140.0 x 105.0 mm, 104 parts (0 on the bottom side), 70 nets.

Other parts of the board:
H1, H2, H3, H4: MountingHole_3.2mm_M3
