Guadonna/VideoSynth/(commit log)

2026-10-23 Add VideoSynth v0.4 feasibility report and supporting research
    [components-preliminary.csv, cpu-budgets.csv, dsp-sensitivity.csv, patch-electrical-assumptions.csv, power-budget.csv, source-register.csv, video-memory.csv]
2026-10-23 docs: verify hardware candidates and revise feasibility report
    [catalog-availability.csv, components-preliminary.csv, cpu-budgets.csv, dsp-sensitivity.csv, patch-electrical-assumptions.csv, power-budget.csv, source-register.csv, video-filter-sensitivity.csv]
2026-10-23 docs: revise VideoSynth for one 480i output and screen modulation matrix
    [components-preliminary.csv, cpu-budget.csv, cv-filter-sensitivity.csv, dsp-sensitivity.csv, power-budget.csv, source-register.csv, video-budget.csv]
2026-10-23 feat: add R1 KiCad prototype and visual DSP emulator
    [bom-r1.csv, core_01.kicad_sch, core_02.kicad_sch, core_03.kicad_sch, core_04.kicad_sch, core_05.kicad_sch, core_06.kicad_sch, cost-estimate-usd.csv]
